vaknin/PCB/boards/capture-clip/case/case-exploded.png

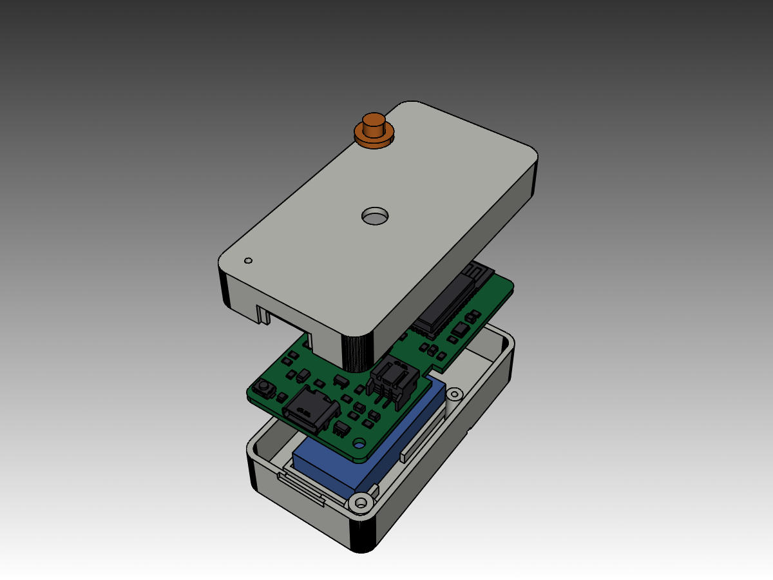
boards/capture-clip/case/case-exploded.png
