vaknin/PCB/boards/capture-clip/case/case-iso.png

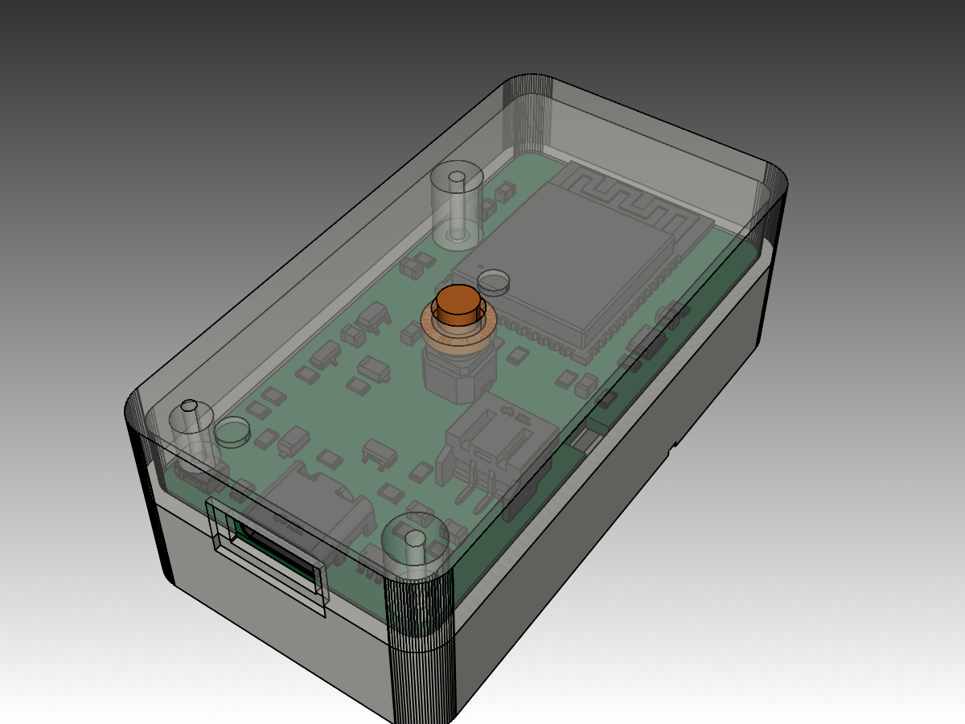
boards/capture-clip/case/case-iso.png
