vaknin/PCB/boards/capture-clip/fab/README.md

# Fab files: capture-clip

Generated by `cargo run --release -p capture-clip -- fab`; do not edit by hand.

- `capture-clip-gerbers.zip`: upload as the PCB (gerbers + drill).
- `capture-clip-bom.csv` and `capture-clip-cpl.csv`: upload for assembly (42 parts).
- Not assembled (no LCSC part, or test points/holes): H1, H2, TP1, TP2, TP3, TP4, TP5, TP6, TP7, TP8.

## Rotation corrections applied

- J1: KiCad 0 deg + 180 = 180 deg
- Q1: KiCad 0 deg + -90 = 270 deg
- U2: KiCad 90 deg + -90 = 0 deg
- U3: KiCad 90 deg + -90 = 0 deg
- U4: KiCad 0 deg + -90 = 270 deg

## Rotation UNVERIFIED (no known correction, or bottom side)

Check each of these in JLCPCB's placement preview (pin 1 marker) before paying.

- D1 (LED_0805_2012Metric)
- D2 (D_SOD-123F)
- D3 (D_SOD-123F)
- D4 (LED_LiteOn_LTST-C19HE1WT)
- J2 (JST_PH_S2B-PH-SM4-TB_1x02-1MP_P2.00mm_Horizontal)
- MK1 (InvenSense_ICS-43434-6_3.5x2.65mm)
- SW1 (SW_Push_1TS009xxxx-xxxx-xxxx_6x6x5mm)
- SW2 (SW_SPST_TS-1088-xR020)
- U1 (ESP32-S3-WROOM-1_EPAD-Drill0.3)
