vaknin/PCB/boards/starter/fab/README.md

# Fab files: starter

Generated by `cargo run --release -p starter -- fab`; do not edit by hand.

- `starter-gerbers.zip`: upload as the PCB (gerbers + drill).
- `starter-bom.csv` and `starter-cpl.csv`: upload for assembly (26 parts).
- Not assembled (no LCSC part, or test points/holes): H1, H2, H3, H4, TP1, TP2, TP3, TP4, TP5, TP6, TP7.

## Rotation corrections applied

- J1: KiCad 0 deg + 180 = 180 deg
- U2: KiCad 90 deg + 180 = 270 deg
- U3: KiCad 90 deg + -90 = 0 deg

## Rotation UNVERIFIED (no known correction, or bottom side)

Check each of these in JLCPCB's placement preview (pin 1 marker) before paying.

- D1 (LED_0805_2012Metric)
- D2 (LED_0805_2012Metric)
- D3 (D_SOD-123F)
- J2 (JST_SH_SM04B-SRSS-TB_1x04-1MP_P1.00mm_Horizontal)
- SW1 (SW_Push_1P1T_XKB_TS-1187A)
- SW2 (SW_Push_1P1T_XKB_TS-1187A)
- U1 (ESP32-S3-WROOM-1_EPAD-Drill0.3)
- U4 (Sensirion_DFN-4_1.5x1.5mm_P0.8mm_SHT4x_NoCentralPad)
