vaknin/PCB/research/2026-09-30-blind-review-capture-clip.md

# capture-clip revision A: blind design review (2026-09-30)

Reviewer: a separate agent that did not build the design and did not read `DECISIONS.md` or
`research/2026-09-30-power-path-fix.md` (only two datasheet URLs were taken from the latter by grep).

How this was checked:
- Every pad's net was read from `boards/capture-clip/kicad/capture-clip.kicad_pcb` (parsed with a script; pad positions turned into board coordinates) and compared with `src/circuit.rs` and the datasheets.
- Tracks, vias and the filled pours were read from the same file; path lengths are the shortest routed path between two pads.
- Coordinates are layout mm from the board's top-left corner, Y down (as in `src/layout.rs`).
- Datasheets read for this review: HE9073 (HEERMICR Ver 1.3, LCSC C723789 mirror), RB168MM-40 (ROHM Rev.002, C509936 mirror), adafruit.com/product/3898. Everything else rests on `research/2026-09-30-datasheet-check-capture-clip.md`.
- Reports read: `erc.json` (0 items), `drc.json` (16 warnings, all waived silk items; 0 unconnected; parity empty), `routing.json`, `gates.json`, `case/fit.json` (all checks pass), `fab/*`.

Cost-of-a-miss classes: **firmware** (fixable in code), **rework** (fixable by hand on the delivered board, or by reprinting the case or buying a different cell), **new board**.

## Findings

| # | Severity | Location | Finding and evidence | What a miss costs | Fix |
|---|---|---|---|---|---|
| 1 | **must** | J2 (24.9, 42.5), notch in the right edge (x 27.5–30, y 31–35), cell pocket x 6.5–23.5, y 18–54 (`board.toml` `[case.battery]`) | **The chosen cell's lead is too short to reach J2.** Adafruit #3898's lead is 25 mm (product page, read 2026-09-30; also parts research §10). J2's mouth faces the antenna end (`layout.rs` line 80), so the wires leave the plug at about (24.9, 30), turn back to the notch (~6 mm), drop past the board to the cell's mid-height (2.5 + 1.6 + 5.1 = ~9 mm), then run under the board to the cell's end at y 18 (15 mm to the nearest corner, ~20 mm to the middle of that end). Total ~30–35 mm against 25 mm. The lengths are **INFERRED** from the layout and case numbers; where on the cell's end the wires leave was not measured. `fit.json` has no check for the lead. | rework (splice longer wires onto a LiPo lead, or find a different protected cell with a longer lead and re-check its polarity) | Move J2 so its mouth is within ~15 mm of wire path from the cell's lead end (for example at the right edge near y 18–24, mouth toward the edge), or choose the cell first and place J2 for it. Add a lead-length check to the case stage. |
| 2 | **should** (fix before ordering; it is free now) | GND via at (4.6, 21.8), beside C7; pours `GND_F.Cu` (6 pieces), `GND_B.Cu` (3 pieces) | **The module's ground hangs on one via.** The pour pieces under and around U1, C5, C6, C8 and MK1 (front piece x 0.5–29.5, y 6–24; front piece around the mic; back piece y 6–32) connect to the ground of the regulator, battery connector, charger and USB only through the single 0.6/0.3 mm via at (4.6, 21.8) and a ~1 mm wide neck of front pour between tracks west of the module. Verified: removing that one via from the connectivity graph splits the GND net into two groups (pieces {module, mic} and {everything else}). No GND track bridges the two groups. DRC cannot see this (the net is connected). `routing.json` reports the piece counts but no gate acts on them. All 355 mA of Wi-Fi return current, the USB data return and the antenna's ground reference to the battery/USB side go through it. | Probably works; a single-via open kills the board (rework: a wire link). Marginal radio or USB behaviour would be hard to tell apart from other causes | Add stitching vias where the two back pieces meet the front pieces (several along x 1–5, y 22–30 and x 20–29, y 26–32), and keep a track-free ground corridor on the back layer from the module to U4/J2. Add a gate: every pour piece must be tied to the main piece by at least 2 vias. |
| 3 | **should** | U4 HE9073A33M5R (3.5, 32.5); `board.toml` lines 187–190, 197–200 | **The regulator drops too much for Wi-Fi bursts on a partly used cell.** HE9073 datasheet p.5: dropout 100 mV at 100 mA, 200 typ / 250 max mV at 200 mA; p.6 Fig. 5: ~0.45 V at 350 mA, ~0.77 V at 500 mA (typical). `board.toml`'s "500 mA typical at 0.5 V dropout" is the IOUT_MAX test condition, not the dropout. With Q1 (~30 mV) and the copper of finding 4 (~45 mV), the 3.3 V rail at a 355 mA peak is about cell − 0.55 V: below the module's 3.0 V minimum once the cell's terminal voltage is under ~3.55 V, which is reached with a good part of the charge left (**INFERRED**: roughly the last 15–30 % of a LiPo; the cell's own resistance makes it worse). The datasheet gives no load-transient conditions (p.7 Fig. 7 has none) and lists "Short / Start load current 90 mA" (fold-back, p.5). The earlier independent datasheet check covered the RT9080, not this part. Pinout 1 VIN, 2 GND, 3 CE, 4 NC, 5 VOUT was checked here against p.2 and matches the board. | firmware (stop uploads and warn at a higher cell voltage; less usable battery) or rework (swap U4 for a same-pinout SOT-23-5 part with lower dropout) | Decide now: either accept and set the low-battery threshold from a bench measurement, or pick a lower-dropout regulator with the same footprint and re-check its input rating and sleep current. Measure the rail during a transmit burst at a cell of 3.5–3.7 V at bring-up. |
| 4 | should | +BATT J2.1 → Q1.3 (32.7 mm, 5 of its nodes on the back), VSYS Q1.2 → U4.1 (13.4 mm), +3V3 U4.5 → U1.2 (26.2 mm, through vias); all 0.3 mm (`layout.rs` line 41) | **Power tracks are thin and long.** About 72 mm of 0.3 mm, 1 oz copper in series from the battery connector to the module: ~120 mΩ, ~45 mV at 355 mA, on top of finding 3. C5/C6 are close to the 3V3 pad (3.6 and 7.2 mm), which is good. | none by itself; adds to finding 3 | Power class 0.6–1.0 mm (or short pour shapes) for +BATT, VSYS, +3V3; put U4 nearer the module's pad 2 or Q1 nearer J2. |
| 5 | should | D3 SMF5.0A (7.6, 49.5), VBUS from J1.A4 (12.55, 52.26) | **The VBUS surge diode is at the end of the line, not the start.** Routed VBUS goes J1 → TP1 → D2.A at 17.2 mm and only then on to D3 at 30.4 mm (27 mm from J1.A9), although D3 sits 5 mm from the connector. D2, Q1's gate, R6 and the regulator's input see a fast edge before the clamp does (~25–30 nH of track in series with the diode, **INFERRED**). The 9 V rating of the HE9073 (p.4) and the clamp's 9.2 V leave little margin already. | rework is impractical; an ESD/surge failure would show as a dead regulator | Route J1 VBUS pins straight to D3.1 first (short, wide), then on to the rest; D3.2 to the pour with its own via. |
| 6 | should | J1 shell legs at (10.68, 53.17) and (19.32, 53.17), slots reach y 52.3–54.0; cell pocket ends at y 54 | **The cell's end lies under two soldered through-hole legs of the USB connector.** `layout.rs` says the cell is "clear of the USB-C shell legs (y > 53)", but the front legs start at y 52.3 and the cell reaches y 54, inside x 6.5–23.5. `fit.json` `battery.board` = 0.42 mm uses the EasyEDA 3D model, which has no solder fillets and was aligned by hand (HARDWARE_LESSONS). A solder tip against a swelling pouch cell is a safety matter. Whether the legs or fillets stick out below a 1.6 mm board is UNVERIFIED. | rework (tape or trim the legs; reprint the tray with the pocket moved) | Move the pocket ≥ 2.5 mm toward the antenna end or shorten it, and add the through-hole pads' positions to the battery check. |
| 7 | should | MK1 stock; BOM line C5656610 | **Only 1,271 ICS-43434 in JLCPCB stock** (`cost.json`), and the owner plans to order later (spec status). If it runs out, the fallback mic (T3902, PDM) has a different footprint: new layout. | new board if it goes out of stock after the freeze | Re-check stock at order time; consider pre-ordering the part into JLCPCB's parts library, or lay out for the better-stocked part now. |
| 8 | note | pins IO4 (CHRG_SENSE), IO5 (STDBY_N) | With USB absent both pins float (the charger is unpowered, D1 blocks). An internal pull-down on IO4 would read "charging" with USB present and not charging (3.3 V through 100k into ~45k = ~1 V). | firmware | Read both pins only while VBUS_SENSE is high; no pulls on IO4; disable their inputs before sleep. |
| 9 | note | unplugging USB with a low cell | VSYS falls onto Q1's body diode (cell − ~0.6 V) for a few ms until the gate (R6 × C1 = 10 ms) has dropped. At a cell of ~3.5 V the rail can dip to ~2.8 V (**INFERRED**). | firmware (brown-out handling; resume an interrupted upload) | Test unplugging during an upload at a low cell. |
| 10 | note | sleep budget, `board.toml` lines 251–279 | Not counted: insulation leakage of C2, C3, C4, C5 (10–22 µF X5R; datasheet-limit leakage can be ~0.5–2 µA each, typical far less: **INFERRED**), and the module's figure is typical only. The sum of 12.65 µA has room. Every other path was traced and draws nothing asleep: R8 only when pressed, R16/R17/R6/D1 only on USB, LEDs (VSYS − 3.3 V ≤ 0.9 V), mic off, R9, R19 (PROG at 0 V). | firmware/none | Measure on the first board through the battery lead. |
| 11 | note | cell (metal foil) under the board from y 18; antenna y 0–6; M2 screw at H1 (2.5, 16.7) | Metal 12 mm from the antenna, inside Espressif's suggested 15 mm. The keep-out under the antenna itself is clean on both layers (zone x −9..39, y −15..6; no copper found in it). | reduced range (INFERRED, small) | Range test at bring-up. |
| 12 | note | U2 (22.4, 56) next to the case boss at H2 (27, 56.5) | In fast charge the TP4057 runs up to its 120 °C limit about 1 mm from a resin screw boss, in a closed case beside the cell, with no temperature sensing of the cell. | rework (case material) / firmware (shorter or no fast charge) | Try fast charge with the case closed at bring-up before relying on it. |
| 13 | note | microphone path: PCB hole Ø0.5 × 1.6 mm, then a Ø1.5 chimney ~10.5 mm long through the tray; outlet on the back face (with a side groove) | A sound path ~12 mm long will resonate inside the 8 kHz band (quarter-wave estimate ~6–7 kHz, **INFERRED**), and the mic faces away from the speaker. The seal is printed resin against bare PCB with two screws on a diagonal. Speech for transcription should survive. | rework (case reprint) | Record a test sentence in the closed case before freezing the case. |
| 14 | note | J2 mount pads MP at (21.55, 39.6) and (28.25, 39.6) | Both pads carry one "unconnected" net name, so the router joined them with 15 mm of track and 2 vias. Harmless. | none | Tie them to GND or give them separate nets. |
| 15 | note | no fuse on VBUS; one spare pin (IO21 on TP8); no test pad on EN or the I2S lines | A short on VSYS is limited only by the USB source. Rework hooks are thin but usable: TP1–TP8, R18, R3/R19. | rework harder | Optional: a test pad on EN and on MIC_VDD. |
| 16 | note | `fab/README.md` "Rotation UNVERIFIED" list | D1, D2, D3, D4, J2, MK1, SW1, SW2, U1 rotations are unchecked against JLCPCB's preview. D2, D3, D4, MK1 and U1 are polarised. | new board if a polarised part is turned and not caught | Check every one in the placement preview before paying (already the README's instruction). |
| 17 | note | silk | SW1 prints a literal "REF**"; values and references overlap across the board (render). | cosmetic | Hide values on silk. |

## Checked and found correct
- Pad → net for every IC and polarised part on the board: U2 (1 CHRG, 2 GND, 3 BAT, 4 VBUS, 5 STDBY, 6 PROG), Q1 (G VBUS, S VSYS, D +BATT; body diode cell → VSYS), D2 (pad 1 cathode on VSYS), D3 (pad 1 cathode on VBUS), D1, D4 (pad 4 anode on VSYS), U3, U4, MK1, J1 (D+ on A6/B6 → pad 14, D− on A7/B7 → pad 13, CC1/CC2 each on its own 5.1k), J2 (pad 1 +BATT, the "+" silk at x 25.9 is at pad 1), U1 pads against the pin map in `board.toml`.
- Power path logic, reversed-cell tolerance, no back-feed into USB, running from USB with no cell.
- Strapping: IO0 has 10k up and the button, no capacitor; IO3, IO45, IO46 unconnected. Flashing: native USB, or hold SW1 and poke SW2.
- Gerbers, drill file and CPL share one origin (board's bottom-left); vias are tented; smallest hole 0.3 mm; one-sided assembly.
- Cost: `cost.json` $66.89 for the design, $96.48 alone in a parcel, under the spec's $150 guide; 8 Extended parts ($24.56).

## What I could not verify
- The battery: lead exit position, real lead length, polarity of a pack in hand, its internal resistance.
- Whether the USB connector's legs protrude below the board (no drawing dimension read).
- HE9073 load-transient behaviour and its fold-back under a Wi-Fi burst; dropout maximum at 355 mA (only 200 mA has a maximum).
- The module's real deep-sleep current with 8 MB PSRAM; capacitor leakage.
- JLCPCB's own DFM result and placement preview (needs an upload); current stock beyond `cost.json`.
- The TP4057's package dimensions (datasheet page mislabelled, per the earlier check) and RB168MM-40's land pattern against `D_SOD-123F` (both SOD-123FL by name; dimensions not compared).
- Acoustic response, radio range, thermal behaviour: bench only.
- The case beyond `fit.json` and the three renders; the STEP/STL solids were not opened.

## Verdict
**Not ready to order.** No wrong pinout, polarity or footprint was found, and the gates that exist do pass. But the specified battery cannot be plugged in as laid out (finding 1), and the ground pour, regulator dropout, power track widths and surge-diode routing (findings 2–5) are all cheap to fix in a layout round now and awkward or impossible on a delivered board. Fix 1–6, re-run the gates, then re-review the changed areas.
