vaknin/PCB/research/2026-09-30-red-team-capture-clip.md

# Red team: what breaks the capture clip in the owner's hands (2026-09-30)

Reviewer did not design this board and did not read `DECISIONS.md`. Read-only pass over
`boards/capture-clip` (spec, board.toml, circuit, layout, case fit and renders, fab files) and the
firmware (`boards/capture-clip/firmware/main`, `firmware/components/clip`). Nothing was built, run
or measured. Another agent was editing the button sampler in `main.c` and `sim/run.py`; nothing
below depends on that half-edited code.

How to read this:

- **INFERRED** = reasoned from the files or from memory of a datasheet, not measured and not
  re-read today. Everything about real-board behaviour is INFERRED: no board exists.
- "Cost after delivery": *Wi-Fi* = firmware update over Wi-Fi; *USB* = flash or re-provision from
  the laptop with the case closed; *owner fix* = something a non-solderer can do (file a part,
  add a sticker, reprint a case); *rework* = soldering, which the owner cannot do; *new board* =
  second order and shipment.
- `board.toml` and `PROGRESS.md` were being edited while this was written, so they are cited by
  section, not by line.
- Paths are relative to the repo root. `bc/` = `boards/capture-clip/`, `fw/` =
  `boards/capture-clip/firmware/main/`, `clip/` = `firmware/components/clip/`.
- The fab quote is for 2 assembled boards (`bc/fab/cost.json:4-7`). That spare covers a single
  assembly defect. It does not cover a design fault: both boards have it.

## The short version

1. The 3.3 V regulator was picked for its 9 V input rating and 0.3 µA sleep current. How it
   behaves when Wi-Fi switches on (a 0 to ~350 mA step) was never looked at, and there is only
   about 32 µF behind it. If the rail dips under 2.84 V the chip resets, and the firmware then
   retries at once, forever. This is the one finding that can make the core function (send a note
   on battery) fail on every board with no firmware cure better than "turn the radio down".
2. The case works against the device: the microphone hole is in the underside (blocked when the
   clip lies on a table), the button stands proud with no guard (pocket presses start 15-minute
   recordings), and the cap-to-switch gap is 0.2 mm, the same size as the print tolerance.
3. USB recovery is sound. Main button + reset pinhole gives the chip's built-in flashing mode,
   which no firmware can break, as long as no security eFuse is ever burned. So firmware faults
   are fixable; what matters is that the device does not drain or loop itself in the meantime.
4. Firmware has no loop breakers: a brown-out loop, a crash loop or a held button each keep the
   chip awake until the cell is flat.

---

## A. Hardware: change before the order

| # | What breaks | How likely, and why | Evidence | Cost after delivery | Cheapest prevention now |
|---|---|---|---|---|---|
| A1 | **Wi-Fi start resets the chip on battery (3.3 V rail dips).** The HE9073 is a 0.3 µA-quiescent regulator from a small vendor with a thin datasheet. Regulators this frugal usually answer a sudden load slowly. Behind it: C4 10 µF + C5 22 µF, and 0805 ceramics lose a third or more of that at 3.3 V. A 350 mA step for 20 µs on ~18 µF effective is a ~0.4 V dip: 3.3 → 2.9 V, against a 2.84 V brown-out setting. On a part-empty cell the rail already sits lower (0.46 V dropout at 355 mA), so the margin is gone. | **Medium (INFERRED), impact highest.** Nobody checked load-transient response: the regulator research covers input rating, quiescent current, dropout and current limit only, and itself calls the vendor "the main weakness of this pick". The dev-board tests ran on a different regulator, so they say nothing. The pattern (ESP32 + micro-power LDO = brown-out at radio start) is a well-known failure. | `bc/src/circuit.rs:239-256` (U4, C3, C4), `:268-269` (C5, C6); `research/2026-09-30-power-path-fix.md` §"HE9073A33M5R, from the datasheet" (no transient figure; "Vendor ... thin") ; `bc/firmware/sdkconfig.defaults:16` (brown-out level 4); `clip/include/clip.h:25-35` | Firmware over Wi-Fi/USB can only lower the transmit power (shorter range) and back off. A real cure is a capacitor soldered on: **rework → in practice a new board.** | Add bulk capacitance on +3V3 at the module now: pads for one or two large ceramics or a polymer/tantalum (100 µF or more in total), populated. Room exists beside C5/C6 on the left strip. Re-check the regulator's start-up into the larger capacitor (its short-circuit foldback is 90 mA). Also worth a second look: the RT9080 that was dropped has ~0.18 V dropout instead of 0.46 V, but a 6.5 V input limit. |
| A2 | **Microphone hole is in the underside of the case.** Lying on a table button-up (the normal place for a device used "around the house"), the hole faces the table and is closed off by it. Carried in a pocket it faces cloth. | **High** that recordings made with the clip lying down are muffled (INFERRED: a 1.5 mm hole flat against a surface). R4 asks for clear speech at arm's length. | `bc/board.toml` `[[case.opening]] ref = "MK1"` (`side = "bottom"`), `bc/case/fit.json` check `opening.MK1` ("tray side"), `bc/src/layout.rs:6-8`, `bc/case/case-top.png` (no opening on the top face) | Owner fix only if a new case is printed: a second shipment of the case, not the board. Firmware cannot help. | Case change only: the mic sits 2.7 mm from the right edge (`layout.rs:65`), so turn the sound channel to come out of the **side wall**, or at least add feet/ribs and a groove from the hole to the edge. No board change. |
| A3 | **Button cap can hold the button down for good.** Nominal gap cap-to-switch is 0.2 mm and the switch travels 0.25 mm. Print tolerance on resin is about ±0.2 mm, plus switch height and screw seating. A cap 0.2 mm long = button permanently pressed. | **Medium (INFERRED).** The case's own rule for moving parts is 0.5 mm (`moving_fit`), but this gap passes at the 0.2 mm static limit. Result of a stuck button: a 15-minute recording after every wake, the chip never sleeps (B-row F2), and any reset lands in flashing mode, so the device looks dead. | `bc/case/fit.json` checks `clearance.cap-SW1` (0.2, limit 0.2) and `cap_travel.SW1` ("gap 0.20 + travel 0.25"); `bc/case/board.json` `limits.moving_fit 0.5` | Owner fix (file the cap's stem) once someone works out that this is the cause. | Open the gap to ≥ 0.5 mm in the case generator; firmware stuck-button handling (F2) as the backstop. |
| A4 | **Button stands 0.55 mm proud of the lid with no guard: pocket and bag presses.** One bump starts a recording that runs up to 15 minutes; the next bump stops it and starts a send. The light cannot be seen in a pocket. | **High** for a device the spec says is "sometimes carried in a pocket or bag". Each false press: a private conversation sent to Gemini and committed as a junk note, a note number used up, ~3.6 MB of the 9.75 MB store, and about a tenth of the battery. Three of them offline fill the store. | `bc/case/fit.json` `cap_travel.SW1` ("stands 0.55 mm above the lid"); `bc/spec.md:13`; `clip/include/clip.h:119`; `clip/clip_sm.c:183-200`; `bc/firmware/partitions.csv:11` | Firmware over Wi-Fi can soften it (F3). The guard itself needs a new case print. | Case: sink the cap flush or below a raised rim. No board change. |
| A5 | **USB connector legs point at the battery.** The front pair of shell legs comes through the board at y 52.6–53.7 mm, x 10.7 and 19.3; the cell lies under the board at y 18–54, x 6.5–23.5, with 1.2 mm between cell and board, 0.78 mm of which is reserved for swelling. Soldered pin ends over the end of a soft pouch. | **Low–medium (INFERRED)**, but the consequence is a punctured lithium cell. `layout.rs` says the cell is "clear of the USB-C shell legs (y > 53)" while placing it to y 54: the two numbers overlap. Whether the fit check counts the legs below the board is not visible in `fit.json` (nearest part to the battery is reported as "PCB"). | `bc/src/layout.rs:17-20`; `bc/fab/gerbers/capture-clip.drl` (T4 slots X10.68 Y7.38–6.28 and mirror); `bc/board.toml` `[case.battery]`; `fit.json` `battery.board` | Owner fix: a strip of Kapton or fish paper over the legs, if told to. | Move the cell pocket 2–3 mm toward the antenna end (y 15.5–51.5 still clears the antenna, which ends at y 6), or put a printed shelf between legs and cell. |
| A6 | **Light too dim to read.** Each colour runs through 1 kΩ from VSYS. On a cell at the upload limit (3.65 V) blue and green get about 0.3–0.7 mA; a high-forward-voltage part is dark. Blue = "sending", green = "saved": the two things the owner most wants to see. Seen through a hole in a lid 7 mm above the LED. | **Medium (INFERRED from the designer's own datasheet check)**: "A high-Vf green/blue part may be dark on a nearly flat cell." Firmware can dim a bright LED with PWM; it can never brighten a dim one. | `bc/src/circuit.rs:342-359`; `research/2026-09-30-datasheet-check-capture-clip.md:66` | Rework (three resistors) → new board. | R11 and R12 (green, blue) to about 330 Ω, R10 (red) to about 470 Ω; trim in firmware. All Basic values, no cost. |

## B. Hardware hooks worth adding now (cheap insurance, not proven faults)

| # | What it buys | Why | Evidence | Cost if skipped | Hook |
|---|---|---|---|---|---|
| B1 | **The main button off the flashing-mode pin.** The main button is on IO0. The chip reads IO0 at power-on, brown-out and watchdog resets (INFERRED from the ESP32-S3 datasheet's strapping section, from memory); low = ROM flashing mode, where it sits with the light off until the cell is flat. | A brown-out while the button is down (a squeeze in a pocket on a low cell, or A3's stuck cap) parks the device in flashing mode. No firmware runs there, so no firmware can fix it. A deep-sleep wake is safe (HARDWARE_LESSONS:149). | `bc/src/circuit.rs:278-292`; `bc/board.toml:19` (BUTTON pin note) | Owner must know the cure: reset pinhole with the button released. Battery is drained each time. | Main button on the spare RTC pin IO21 (today only a test pad, which is useless to someone who cannot solder), and a second small Basic switch on IO0 behind its own pinhole next to reset. Recovery stays as good; a stuck main button can no longer stop the boot. |
| B2 | **Battery protection that does not depend on which cell is bought.** The board has no protection chip and no under-voltage cut-off; the regulator is always on. It relies on the cell's own protection board. | The owner buys the cell separately, in Israel, where the named Adafruit cell is awkward to get. A bare cell, or one with a 2.4 V cut-off, is deep-discharged by any of the drain loops in section C. | `bc/src/circuit.rs:209-215`; `bc/board.toml:203-205` ("its datasheet was not read") | Swollen or dead cell; new cell. | A DW01A + dual-FET protection stage on the board (standard parts), or at least state in the owner guide: only a *protected* cell, this size, this polarity. |
| B3 | **A battery reading good to better than ±0.1 V.** The divider is 667 kΩ seen from the pin; the pin's leakage (up to 50 nA) shifts the reading by up to 0.1 V at the cell. The firmware's limits are 50–100 mV apart. | A board that reads 0.1 V low refuses to send with a fifth of the charge still in the cell; one that reads high walks into brown-out. | `bc/src/circuit.rs:231-237`; datasheet check `:74`; `clip/include/clip.h:33-38` | Firmware (per-board calibration over USB: with no cell fitted the charger holds 4.2 V on the pin). | Three 330 kΩ instead of three 1 MΩ: 4 µA instead of 1.4 µA asleep, inside the 20 µA budget (sum today ~12.7 µA). Or keep and calibrate at bring-up. |
| B4 | **Fast charge is 0.83 C into a 400 mAh cell with no temperature sense**, in a closed case, next to a charger chip that runs at up to 120 °C while throttling. | Cell life and swelling over a year of nightly charges; charging below 0 °C or in a hot car is unprotected in any mode (TP4057 has no thermistor pin). Spec says indoors. | `bc/src/circuit.rs:147-159`; `bc/src/layout.rs:21-22`; `clip/clip_sm.c:288-293` | Wi-Fi: firmware can drop to 100 mA always, or use the chip's internal temperature sensor as a rough guard. | None needed on the board if fast charge is made opt-in in firmware. Tell the owner. |
| B5 | **Microphone seal.** The chimney's top meets the board with 0.0 mm nominal gap, rigid resin on fibreglass, at a corner far from both screws. Print tolerance gives either a leak (the mic hears the inside of the case and button clicks) or a bowed board. The 10.5 mm × Ø1.5 mm tube also resonates around 5–7 kHz, inside the recorded band (INFERRED). | Medium for "sounds boxy", low for "unusable": speech-to-text is tolerant. Open hole, no mesh: lint and sweat go straight to the mic port. | `fit.json` `seal.MK1` (0.0), `opening.MK1`, `print.tube_wall`; `bc/board.toml` `[[case.opening]] ref = "MK1"` | Owner fix (foam ring, mesh sticker) or new case. | Make the chimney 0.5 mm short and fit a soft gasket; a side port (A2) shortens the tube as well. |
| B6 | **M2 self-tapping screws into resin bosses**, 1.5 mm boss wall, two screws only. Resin is brittle: bosses crack on the second or third opening, and the case will be opened (battery, reset of a looping device). A drop lands on a 1.5 mm resin wall. | Medium over the device's life (INFERRED). Material is the owner's choice and resin is only the starting value. | `fit.json:5`, checks `print.boss_wall`, `screw_length` | New case print. | Offer nylon (MJF/SLS) on the choice page with this reason; or brass inserts. |

## C. Firmware: fix before shipping

All of these are fixable later over Wi-Fi or USB. They are listed because, until fixed, they
drain the cell, lose notes or leave the device looking dead.

| # | What breaks | How likely, and why | Evidence | Cost after delivery | Prevention now |
|---|---|---|---|---|---|
| F1 | **Brown-out reset loop.** After a brown-out the app starts "fresh": it clears the retry times, reads the cell at rest (it has recovered), sees a queued note and starts Wi-Fi at once. If Wi-Fi start is what caused the reset (A1, a cold or aged cell), it loops every second or two until the resting voltage falls under 3.65 V. The loaded-voltage check reads an average, not the transmit peak, so it does not catch this. | High *if* A1 is real; otherwise occasional on old or cold cells. | `fw/main.c:514-528` (fresh start wipes `keep`), `:645-647` (brown-out is only used to skip the self-test); `clip/clip_sm.c:76-91`; `fw/main.c:191-199`; `fw/hw_gpio.c:109-126` | Wi-Fi/USB | Count resets in memory that survives a reset (`RTC_NOINIT`); after a brown-out treat the battery as low for that wake and back off; cap transmit power until bring-up has measured the rail. |
| F2 | **A held or stuck button keeps the chip awake until the cell is flat.** With the button down the state machine refuses to sleep ("a sleep would end at once"). At roughly 30–50 mA idle that is about 10 hours for 400 mAh (INFERRED current). No timeout. | Medium: pocket pressure, a bag, A3's stuck cap. | `clip/clip_sm.c:104-108`; `fw/sleep_deep.c:30-40` | Wi-Fi/USB | After a recording ends with the button still down, sleep with the button wake turned off and a short timer wake to look again (or wake on release). |
| F3 | **Nothing stops a recording nobody meant.** No silence check, fixed 15-minute cap, and the junk is sent. | High with A4. Also a privacy matter: other people's speech goes to Google and into the repo. | `clip/clip_sm.c:217-220`; `clip/include/clip.h:119` | Wi-Fi/USB | Stop after ~20–30 s without speech energy; drop a new note Gemini hears nothing in (additions already do this). |
| F4 | **Crash loop with no safe mode.** A file in the queue that crashes the parser or the uploader crashes it again on every wake. Rollback does not help: the image was already accepted. The console barely comes up before the crash. | Low per release, but this is the case the "free to fix" promise rests on. | `fw/main.c:625-670` (no reset counter); `bc/firmware/sdkconfig.defaults:11` | USB with the case closed: button + reset pinhole, reflash, erase storage (queued notes are lost). Not Wi-Fi. | After three crashes in a row, start a minimal mode: console and update check only, queue untouched. |
| F5 | **Updates are not authenticated.** The image is checked only against a SHA-256 that comes from the same manifest. Whoever can write the manifest (or sit in the path: `http://` is accepted for both the manifest and the image) installs anything. Any *different* version string installs, including an older one. No secure boot. A malicious image gets the Wi-Fi password, both keys and a microphone in the house. | Low likelihood, severe. If the manifest lives in the notes repo, every holder of the notes token (phone, laptop, this clip's own flash) can push firmware. | `fw/update.c:49-69`, `:89-150` (SHA compare at `:138`); `clip/clip_update.c:53` (`http://` allowed), `:92-105` (`strcmp` only); `bc/firmware/PROGRESS.md` "INFERRED items" (update manifest format and hosting) | Wi-Fi/USB | Sign the manifest (Ed25519, public key in the firmware), refuse `http://`, refuse downgrades. Keeps USB recovery, burns no eFuse. |
| F6 | **Wi-Fi updates are inert as provisioned, and only checked at one moment.** `update_url` is not in `board.toml [provision]`, so a provisioned clip has none and never updates. With it, the check runs only on USB with Wi-Fi already up for a queued note. A firmware whose recorder is broken queues nothing and therefore never looks for its own fix. | Certain (first part) as the files stand. | `bc/board.toml` `[provision]` (no `update_url`); `bc/firmware/PROGRESS.md` "Needed from pcbgen and board.toml"; `clip/clip_sm.c:96-102`; `fw/update.c:89-96` | USB | Add the key; on USB plug-in, check for an update once a day whether or not a note is queued. |
| F7 | **A good update is thrown away, and that version is then refused for ever**, if the network is down for three tries during its trial, or the cable is pulled and the chip resets before the trial ends. | Medium: a router reboot is enough. The designer lists the first half as known bug 6. | `fw/update.c:164-203`; `clip/clip_update.c:100-102`; `bc/firmware/PROGRESS.md` "Known bugs" item 6 | Publish a new version number. | Judge the trial on local checks; treat "no network" as "try again at the next boot", not as failure. |
| F8 | **The trial's storage check cannot fail, and a mount failure erases the queue silently.** Storage is mounted with format-on-failure, so an update with an incompatible file-system setting wipes every unsent note and then passes its own "storage mounts" check. | Low, but the loss is silent and total. | `fw/store.c:144-155`; `fw/update.c:176-179` | Notes lost; no recovery. | Format only when a "never formatted" flag says first boot; otherwise fail the trial and report. |
| F9 | **Storage fills and stays full.** Given-up recordings are kept and never retried or deleted without a console command; while GitHub refuses (expired token), everything stays queued. About 40 minutes of audio fits. Then every press is a red blink. | Certain on 2027-09-18, when the GitHub token expires, unless it is renewed first; the status file uses the same token, so the phone sees nothing either. | `bc/firmware/PROGRESS.md` "Not started" (storage-full policy); `clip/clip_queue.c:664-669`; `fw/recorder.c:141`, `:190`; `bc/board.toml` `[provision] github_token` (`expires = "2027-09-18"`); `clip/clip_upload.c:14` | USB re-provisioning; nothing lost if done before the store fills. | A distinct light pattern for "needs the laptop"; a reminder before the expiry date; a policy for given-up audio. |
| F10 | **First half-second of every note is lost, and a hold must be ~1.2 s.** Wake-to-app was measured at 325–365 ms because the bootloader re-checks the whole image on every wake; the firmware assumes 150 ms. `update.c` says the skip option "must stay off", but that option only affects deep-sleep wakes and the update uses a restart, so they do not conflict. File-system mount and microphone start come on top. | Certain. | `firmware/spikes/codec/RESULTS-devboard.md:133-149`; `fw/main.c:35-38`; `fw/update.c:156-157`; `bc/firmware/sdkconfig.defaults` (option absent) | Wi-Fi/USB | Turn on skip-validate on wake and the quiet boot settings; measure; set `WAKE_BOOT_MS` from the measurement. Check that the quiet-ROM option burns no eFuse (the results file flags this). |
| F11 | **Gemini model and endpoint are compiled in** (`gemini-3.5-flash-lite`, a `v1beta` path). When Google retires either, every note fails eight times and is set aside. | Certain eventually (INFERRED: hosted models are retired on a schedule). | `firmware/components/capture/include/capture.h:114-121` | Wi-Fi, if F6 is fixed; otherwise USB. | Make the model a provisioned value with the compiled one as default. |
| F12 | **No upload where the network blocks time servers.** With the clock never set (first use, or after the cell ran flat), a failed time sync counts as "offline". Guest and office networks often block it. | Low at home, certain on such networks. | `fw/net_wifi.c:97-105` | Wi-Fi/USB | Fall back to the `Date` header of the first HTTPS answer. |
| F13 | **Notes postponed by the wall clock can wait indefinitely after the cell runs flat** (INFERRED from reading, not run): the queue compares `not_before_ms` with a wall clock that reads 0 until Wi-Fi sets it, and Wi-Fi is not started because nothing is due. A new recording unblocks it. | Low. | `fw/main.c:112-117`, `:136-141`; `clip/clip_queue.c:615-650` | Wi-Fi/USB | With the clock unset, treat postponed notes as due. |
| F14 | **Secrets are in plain flash.** Wi-Fi password, Gemini key, GitHub token and any unsent recordings can be read from a lost clip with a USB cable. NVS encryption is "not started"; it would not stop someone who flashes their own reader anyway. | Low (needs the device), but see section D: the cure is worse than the disease for recovery. | `bc/firmware/PROGRESS.md` "Not started" (NVS encryption); `fw/http.c:42-77` | — | See D3. Do **not** turn on flash encryption or secure boot casually: they burn eFuses and can end USB recovery. |
| F15 | **Audio gaps when flash is slow.** One second of audio is synced to LittleFS per page; the I2S buffer holds 320 ms. A slow erase or an allocator scan on a nearly full 9.75 MB store is longer than that (INFERRED; the designer lists it as not provable before hardware). | Medium when the store is nearly full. | `fw/mic_i2s.c:22-23`; `fw/recorder.c:46-54`, `:126-144` | Wi-Fi/USB | A larger ring buffer in internal RAM between mic and encoder; measure at bring-up. |
| F16 | **The microphone self-test cannot see a blocked or missing sound path.** It passes on the mic's own noise (4 counts of spread). A board with flux in the hole, or a case with the chimney off-centre, passes. | Medium that a real acoustic fault slips through bring-up. | `fw/selftests.c:15-47` | — | Self-test step: "clap once", require a clear rise over the noise floor, with the case closed. |
| F17 | **None of the real hardware paths has ever run**: GPIO, ADC, I2S mic, deep sleep and both wake pins, Wi-Fi, TLS, the certificate bundle. | Certain that something in there is wrong on first power-up; that is what bring-up is for. It matters here because the freeze comes before any board exists. | `bc/firmware/PROGRESS.md` "Written but untested" and "Proven where: Not before hardware" | USB | Run the app on the ESP32-S3 dev board with a breakout mic and a button before the order: it removes most of this list for the price of one small part. |

## D. Accept, and tell the owner

| # | What | Why accept | Evidence | What the owner needs to know |
|---|---|---|---|---|
| D1 | **Button held while a flat or missing battery is plugged into USB = flashing mode**, light off, looks dead. | Inherent in using one button for both (spec line 27), unless B1 is taken. | `bc/spec.md:27`; `bc/board.toml:19` | "If it seems dead: poke the reset hole once, without touching the button." The charge light works on its own and still shows USB power. |
| D2 | **The battery must be the right one.** The pocket fits 36 × 17 × 7.8 mm with 0.4 mm to spare; the plug's polarity is not standardised across sellers. A reversed cell does no damage by analysis (INFERRED) but the clip will not run. | Cannot be designed away short of B2. | `fit.json` `battery.case`; `bc/src/layout.rs:124-127`; datasheet check `:58` | Exact cell to buy, a photo of which wire goes to "+", and: never force the lid shut on the lead. About 5 cm of lead has to be folded above the board beside the button (INFERRED: the fit check does not model wires); keep it off the antenna end. |
| D3 | **A lost clip gives away the Wi-Fi password, the Gemini key and the notes token.** | Real protection costs the USB safety net. | F14 | Use a GitHub token limited to the notes repo only; know where to revoke it and the Gemini key; change the Wi-Fi password if the clip is lost. |
| D4 | **About a fifth of the battery cannot be used for sending.** Below 3.65 V at rest the clip records but does not send, because of the regulator's dropout. By the firmware's own curve that is ~18 % of the charge. | Follows from the regulator choice. | `clip/include/clip.h:33-37`; `clip/clip_power.c:42` | Amber light = "charge me to send". Battery life in weeks is still unmeasured (spec line 18). |
| D5 | **Weeks offline with a note queued drains the cell slowly**: a 15-second connect attempt every hour, roughly 10 mAh a day (INFERRED). | Cheap to soften later in firmware (longer back-off). | `clip/clip_sm.c:47-54`; `fw/net_wifi.c:19`, `:90` | On a trip, expect about a month, not months. |
| D6 | **Plugged in all the time**, the cell is held full and topped up, which ages it; the clip stays awake on USB. | Normal for this charger. 0.78 mm of swelling room is designed in. | `clip/clip_sm.c:104-107`; `fit.json` `battery.board` | Look at the cell once or twice a year; a case that no longer closes flat means replace the cell. |
| D7 | **Antenna**: the keep-out is respected and the cell ends 12 mm from it; a steel M2 screw sits 10 mm from it and the hand covers that end. Range is unmeasured. | Pre-certified module used as intended. | `bc/src/layout.rs:4`, `:57`; `bc/kicad/render-top.png` | If notes queue in rooms where the phone has Wi-Fi, that is range, not a fault. |
| D8 | **No clip.** The case is a plain 34 × 64 × ~20 mm box with no clip, loop or lanyard hole. | A case matter, the owner's choice. | `bc/case/case-iso.png`, `case-top.png`; `fit.json` parts list | Decide on the case choice page. |
| D9 | **Open holes** for the light, reset and microphone: not splash-proof. Spec says indoors, dry. | As specified. | `bc/spec.md:13`; `bc/board.toml` `[[case.opening]]` entries | Not for the bathroom or a sweaty pocket. |
| D10 | **Clock drift while asleep** uses the chip's internal oscillator: a note recorded after days offline can be stamped minutes off. | No crystal on the board; corrected at each connect. | `fw/net_wifi.c:100-101` | — |

## E. Fab and assembly chain

| # | What breaks | How likely | Evidence | Cost | Prevention |
|---|---|---|---|---|---|
| E1 | **Wrong rotation in the placement file.** Rotation is unverified for D2 and D3 (diodes), D4 (RGB), MK1 (mic), U1 (module), J2, D1. A reversed D3 shorts USB power; a reversed D2 means USB cannot run the board; a turned mic or module is a dead board. | Medium per part; this is the usual way a first assembled order dies. Both assembled boards would share it. | `bc/fab/README.md` ("Rotation UNVERIFIED") | New board (owner cannot solder). | Check every listed part against pin 1 in JLCPCB's placement preview before paying, and save a screenshot with the order. Ask JLCPCB to confirm polarity ("DFM/placement review") in the order note. |
| E2 | **Microphone out of stock.** 1,281 in stock on 2026-09-30, the thinnest on the board, and nothing else fits its footprint. A fab-side substitute would be wrong. | Medium if the order waits for other designs, as the spec says it will. | datasheet check `:115`; `bc/spec.md:4` | Order delayed, or a redesign. | Pre-purchase the mic (and the module) into JLCPCB's parts library at freeze; re-read stock on order day; forbid substitutions in the order. |
| E3 | **Regulator pin numbers are INFERRED** (the datasheet figure has no numbers) and the part is drawn with another maker's symbol. The standard numbering is very likely right. | Low. | `bc/src/circuit.rs:240-243` | New board. | Compare against JLCPCB's own footprint/3D preview for C723789 at order time. |
| E4 | **Bottom-port mic soldered by the fab**: paste or flux in the 0.5 mm hole. The hole is present in the drill file and unplated. | Low. | `bc/fab/gerbers/capture-clip.drl` (T5 0.5 mm at X27.3 Y39.69) | New board, or the spare. | F16's clap test on both boards at bring-up. |

## What was checked and found sound

- **USB recovery with the case closed.** Main button on IO0 plus reset behind a pinhole, native
  USB on the fixed pins, no eFuse burned: the ROM flashing mode is reachable whatever the firmware
  does (`bc/src/circuit.rs:278-301`, `fit.json` `opening.SW2`). It stays true only while no
  security eFuse is burned.
- **Bad update.** Two slots, trial boot, rollback on crash or failed check
  (`bc/firmware/sdkconfig.defaults:11`, `fw/update.c`). The old firmware always survives.
- **Power path.** USB present: cell isolated and charging; USB absent: cell feeds the board; a
  reversed cell is blocked by analysis (`bc/src/circuit.rs:181-205`).
- **Dead cell on USB.** The board runs from USB through D2 while the charger trickle-charges.
- **Fast charge never overlaps Wi-Fi** in the state machine, the worker and `net_up`
  (`clip/clip_sm.c:288-293`, `fw/main.c:286-294`, `fw/net_wifi.c:69`), and the pin is hi-Z at
  reset and asleep.
- **Power cut while recording.** Page-by-page sync, recovery at boot (`fw/recorder.c:46-54`).
- **Antenna keep-out** is in the footprint and empty in the render.
- **Provisioning console** lists key names and lengths only, never values
  (`firmware/components/provision/provision_cmd.c:28`).

## Not checked

- No datasheet was re-read today; the HE9073's transient behaviour (A1) and the strapping-pin
  reset list (B1) are from memory and must be confirmed.
- `clip_queue.c` and `clip_upload.c` were skimmed, not audited line by line.
- The case geometry was judged from `fit.json`, `board.json` and three renders, not from the
  STEP files.
- Nothing was measured: currents, range, audio and timing are all INFERRED.
