vaknin/PCB/boards/capture-clip/case/case-top.png

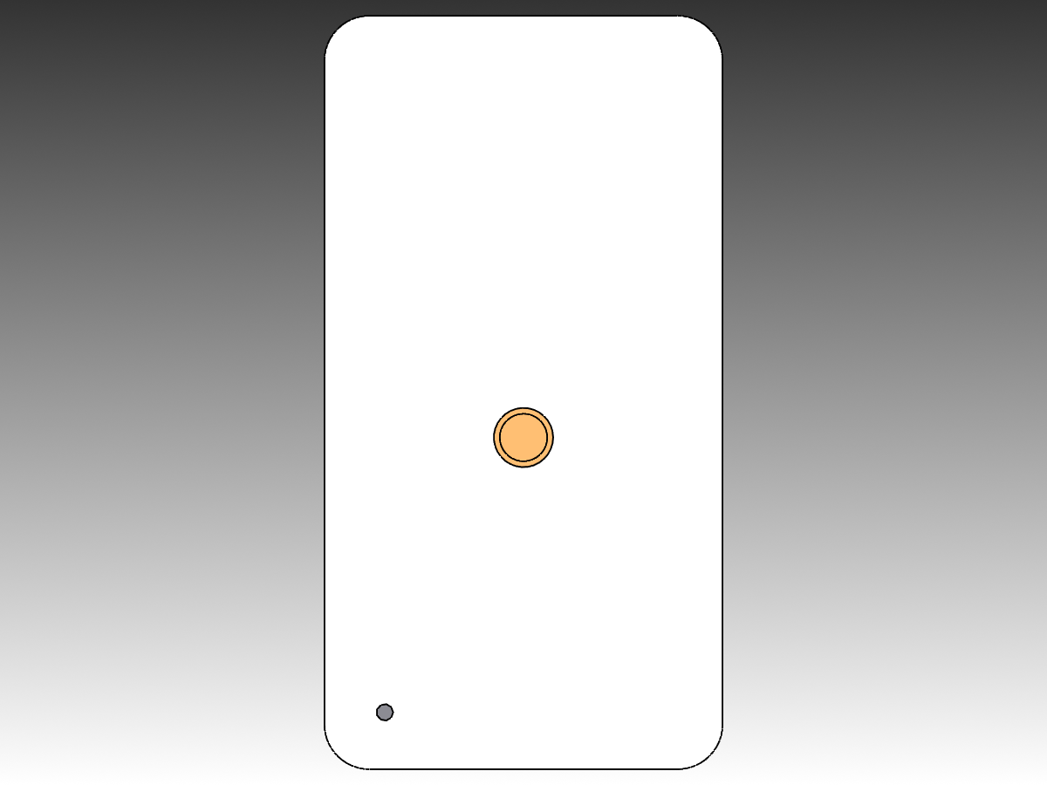
boards/capture-clip/case/case-top.png
