vaknin/PCB/boards/capture-clip/kicad/render-top.png

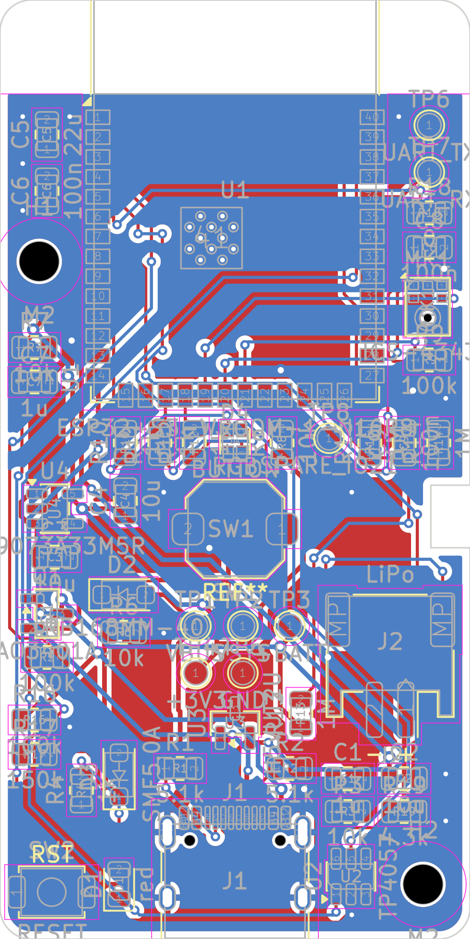
boards/capture-clip/kicad/render-top.png
