vaknin/PCB/boards/starter/kicad/render-top.png

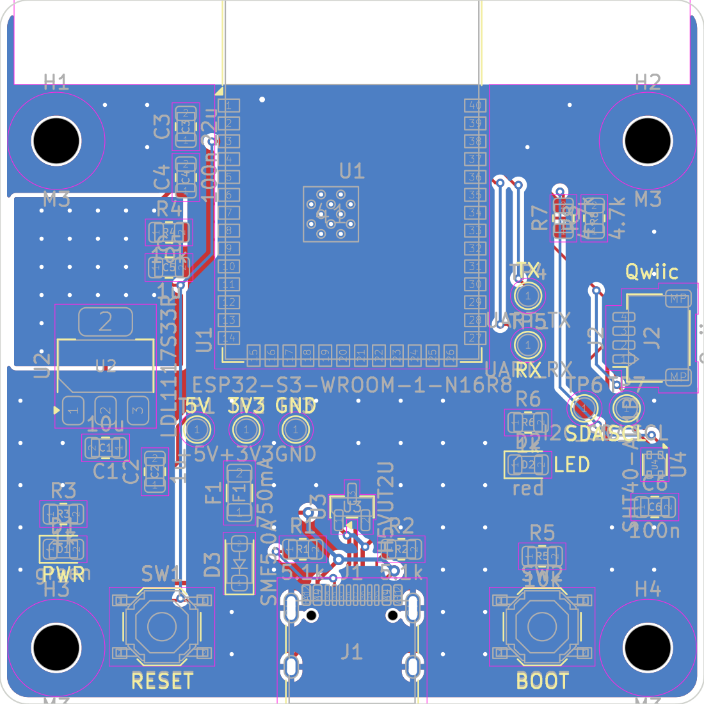
boards/starter/kicad/render-top.png
