vaknin/PCB/boards/starter/fab/starter-bom.csv

Comment | Designator | Footprint | LCSC
10u | C1 | C_0805_2012Metric | C15850
1u | C2,C5 | C_0805_2012Metric | C28323
22u | C3 | C_0805_2012Metric | C45783
100n | C4,C6 | C_0805_2012Metric | C49678
green | D1 | LED_0805_2012Metric | C2297
red | D2 | LED_0805_2012Metric | C84256
SMF5.0A | D3 | D_SOD-123F | C19077497
750mA | F1 | Fuse_1206_3216Metric | C89653
USB-C | J1 | USB_C_Receptacle_HRO_TYPE-C-31-M-12 | C165948
Qwiic | J2 | JST_SH_SM04B-SRSS-TB_1x04-1MP_P1.00mm_Horizontal | C160404
5.1k | R1,R2 | R_0805_2012Metric | C27834
1k | R3,R6 | R_0805_2012Metric | C17513
10k | R4,R5 | R_0805_2012Metric | C17414
4.7k | R7,R8 | R_0805_2012Metric | C17673
RESET | SW1 | SW_Push_1P1T_XKB_TS-1187A | C318884
BOOT | SW2 | SW_Push_1P1T_XKB_TS-1187A | C318884
ESP32-S3-WROOM-1-N16R8 | U1 | ESP32-S3-WROOM-1_EPAD-Drill0.3 | C2913202
LDL1117S33R | U2 | SOT-223-3_TabPin2 | C435835
H5VUT2U | U3 | SOT-23 | C20615824
SHT40-AD1B | U4 | Sensirion_DFN-4_1.5x1.5mm_P0.8mm_SHT4x_NoCentralPad | C2909890
