vaknin/PCB/boards/capture-clip/case/case-lid.step

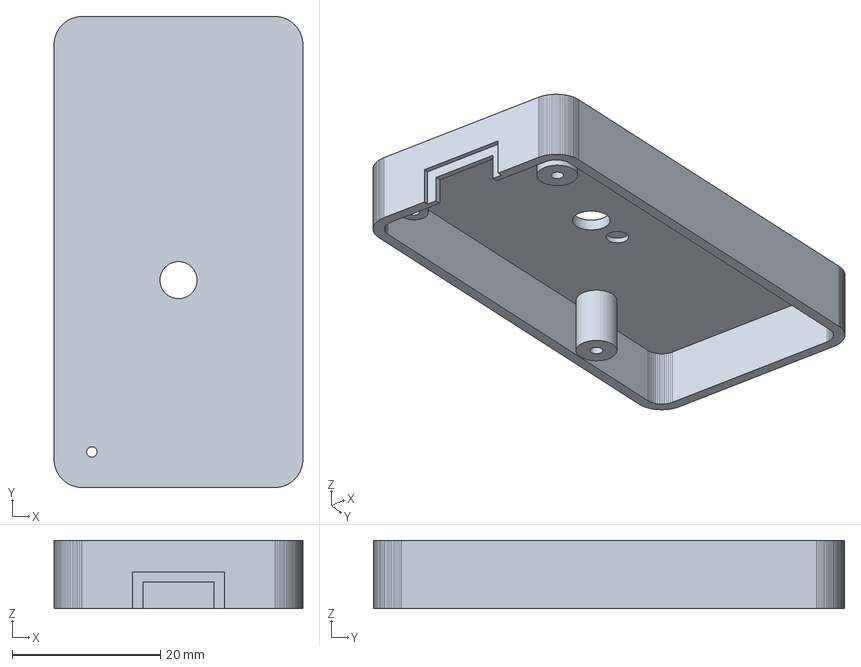
[picture p6: CAD file, 2026-09-30]
boards/capture-clip/case/case-lid.step
33.6 x 63.6 x 9.20 mm
