vaknin/PCB/boards/capture-clip/case/cap-SW1.step

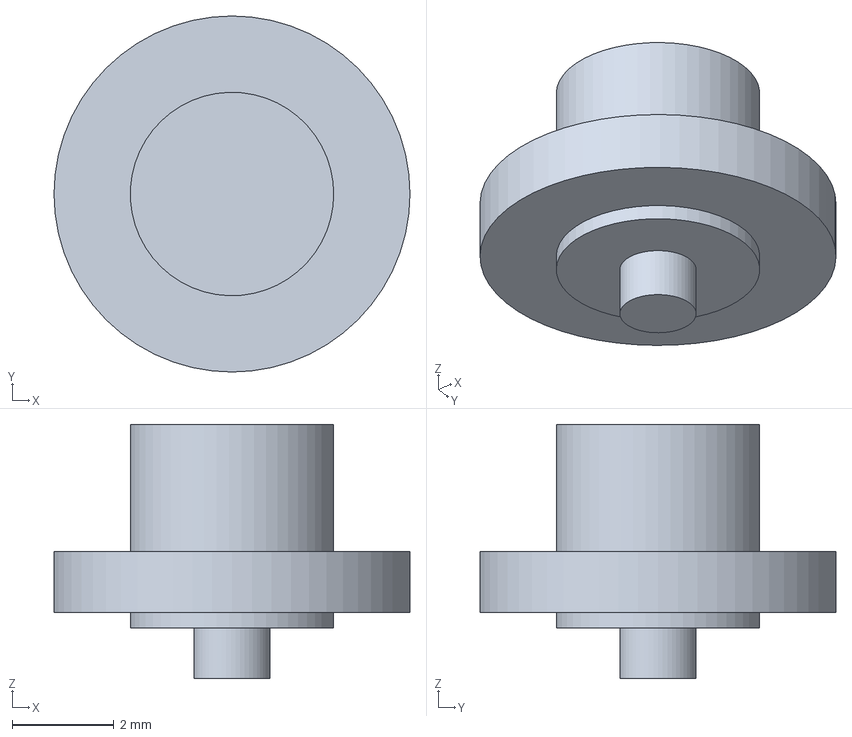
[picture p7: CAD file, 2026-09-30]
boards/capture-clip/case/cap-SW1.step
7.00 x 7.00 x 5.00 mm
