vaknin/PCB/boards/capture-clip/case/case-bottom.step

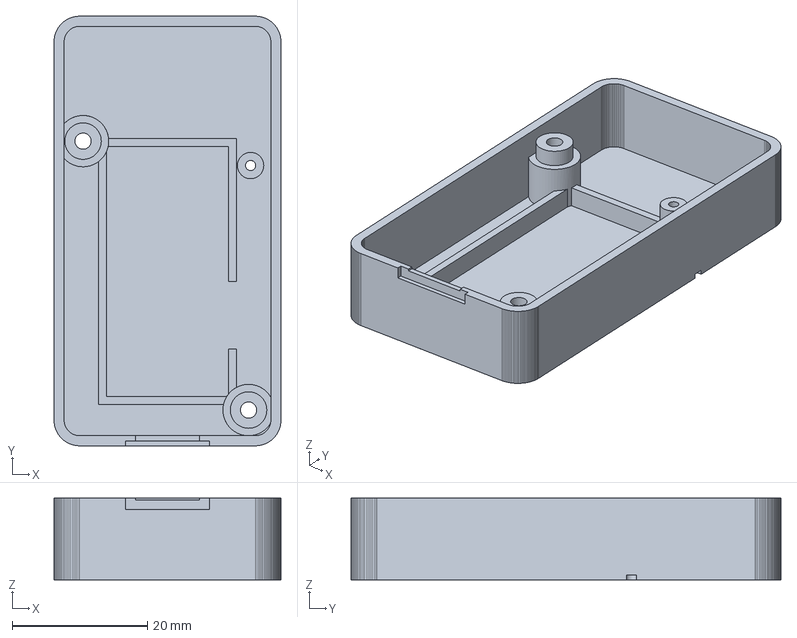
[picture p8: CAD file, 2026-09-30]
boards/capture-clip/case/case-bottom.step
33.6 x 63.6 x 12.1 mm
