vaknin/PCB/boards/starter/case/cap-SW2.step

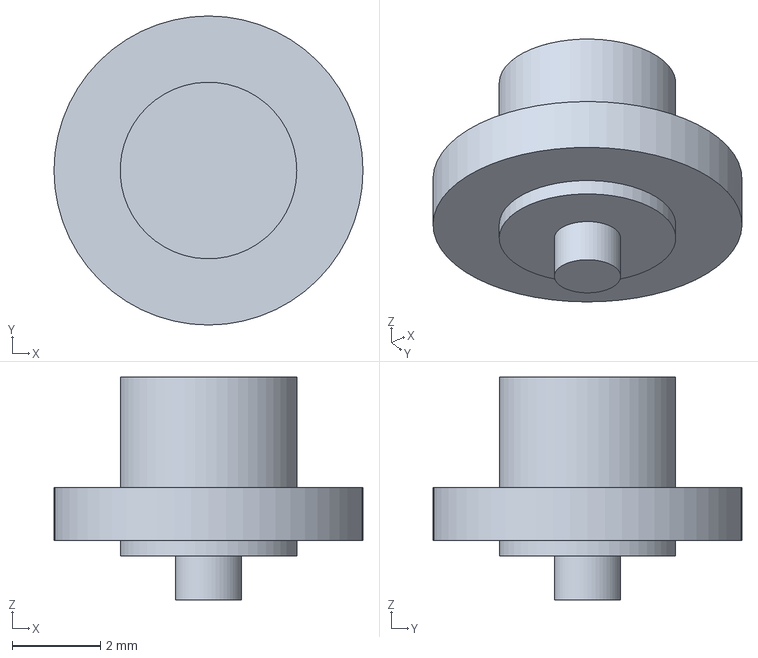
[picture p9: CAD file, 2026-09-30]
boards/starter/case/cap-SW2.step
7.00 x 7.00 x 5.05 mm
