vaknin/PCB/boards/starter/case/case-bottom.step

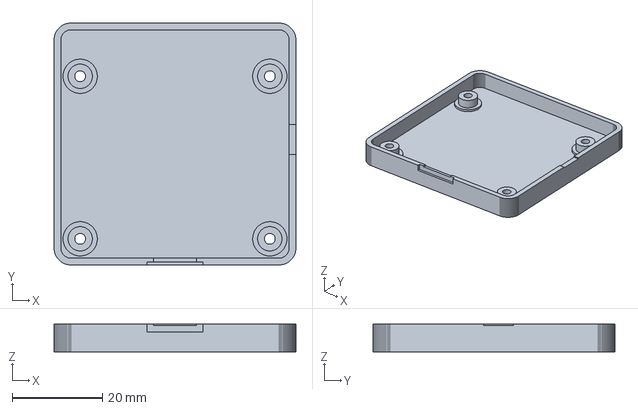
[picture p10: CAD file, 2026-09-30, an earlier design]
boards/starter/case/case-bottom.step
53.6 x 53.6 x 6.10 mm
