vaknin/PCB/boards/starter/case/case-lid.step

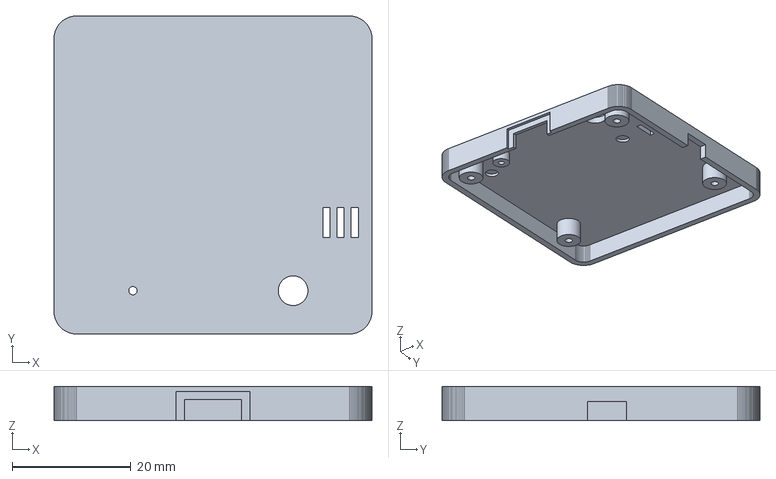
[picture p11: CAD file, 2026-09-30, an earlier design]
boards/starter/case/case-lid.step
53.6 x 53.6 x 5.75 mm
