vaknin/PCB/(list of files, cad)

Other CAD files:
boards/capture-clip/case/cap-SW1.stl
boards/capture-clip/case/case-bottom.stl
boards/capture-clip/case/case-lid.stl
boards/starter/case/cap-SW2.stl
boards/starter/case/case-bottom.stl
boards/starter/case/case-lid.stl
