vaknin/PCB/firmware/test/fixtures/capture/laptop_addition.md

---
id: c0ffee00000000000000000000000003
created: 2026-09-19T09:00:00Z
num: 43
source: laptop
---

# Label maker for jars

- Print labels for the spice jars.
- Use the old thermal printer.

## Transcript

Print labels for the spice jars.

## Added
<!-- addition add00000000000000000000000000002 created=2026-09-19T09:02:36Z source=laptop -->

Use the old thermal printer for it.
