vaknin/PCB/firmware/test/fixtures/capture/phone_list.md

---
id: c0ffee00000000000000000000000001
created: 2026-09-19T09:00:00Z
num: 41
duration_ms: 56634
source: phone
---

# Bird feeder with a camera

- Put a small camera on the bird feeder.
- Sort the pictures by species.

## Transcript

I want a bird feeder that takes a picture of every visitor. Later it could sort them by species.
