vaknin/PCB/firmware/test/fixtures/capture/phone_paragraph.md

---
id: c0ffee00000000000000000000000004
created: 2026-09-19T09:00:00Z
num: 44
duration_ms: 20343
source: phone
---

# Compost thermometer

A probe that reports how warm the compost heap is, so it is turned at the right time.

## Transcript

The compost heap should tell me how warm it is. Then I know when to turn it.
