vaknin/PCB/firmware/test/fixtures/capture/phone_typed_addition.md

---
id: c0ffee00000000000000000000000002
created: 2026-09-19T09:00:00Z
num: 42
duration_ms: 9023
source: phone
---

# Kite with lights

- Build a kite with a strip of lights.
- Power it from a coin cell.

## Transcript

A kite with lights on it, for flying at dusk.

## Added
<!-- addition add00000000000000000000000000001 created=2026-09-19T14:36:05Z source=phone -->

A coin cell should be enough to power it.
