vaknin/PCB/templates/errata.md

# <Board title>: errata, revision <X>

What was wrong with this revision at bring-up and after. Copy to
`boards/<name>/errata-rev<X>.md`. The next revision fixes every open item in one go
(`docs/workflow.md` step 6). Mark each cause VERIFIED (measured, seen) or INFERRED.

| # | Found | What happens | Cause | Workaround on this board | Fix in the next revision | Status |
|---|---|---|---|---|---|---|
| E1 | self-test / bring-up step / use | what the owner sees | why (VERIFIED/INFERRED) | rework, firmware change, or none | circuit or layout change | open |

## Self-test results at bring-up
Paste the self-test report here, one block per board (boards are numbered by the order
they were tested).

## Notes
