vaknin/PCB/boards/starter/kicad/starter.kicad_pcb

## KiCad design boards/starter/kicad/starter.kicad_pcb (2026-10-01)

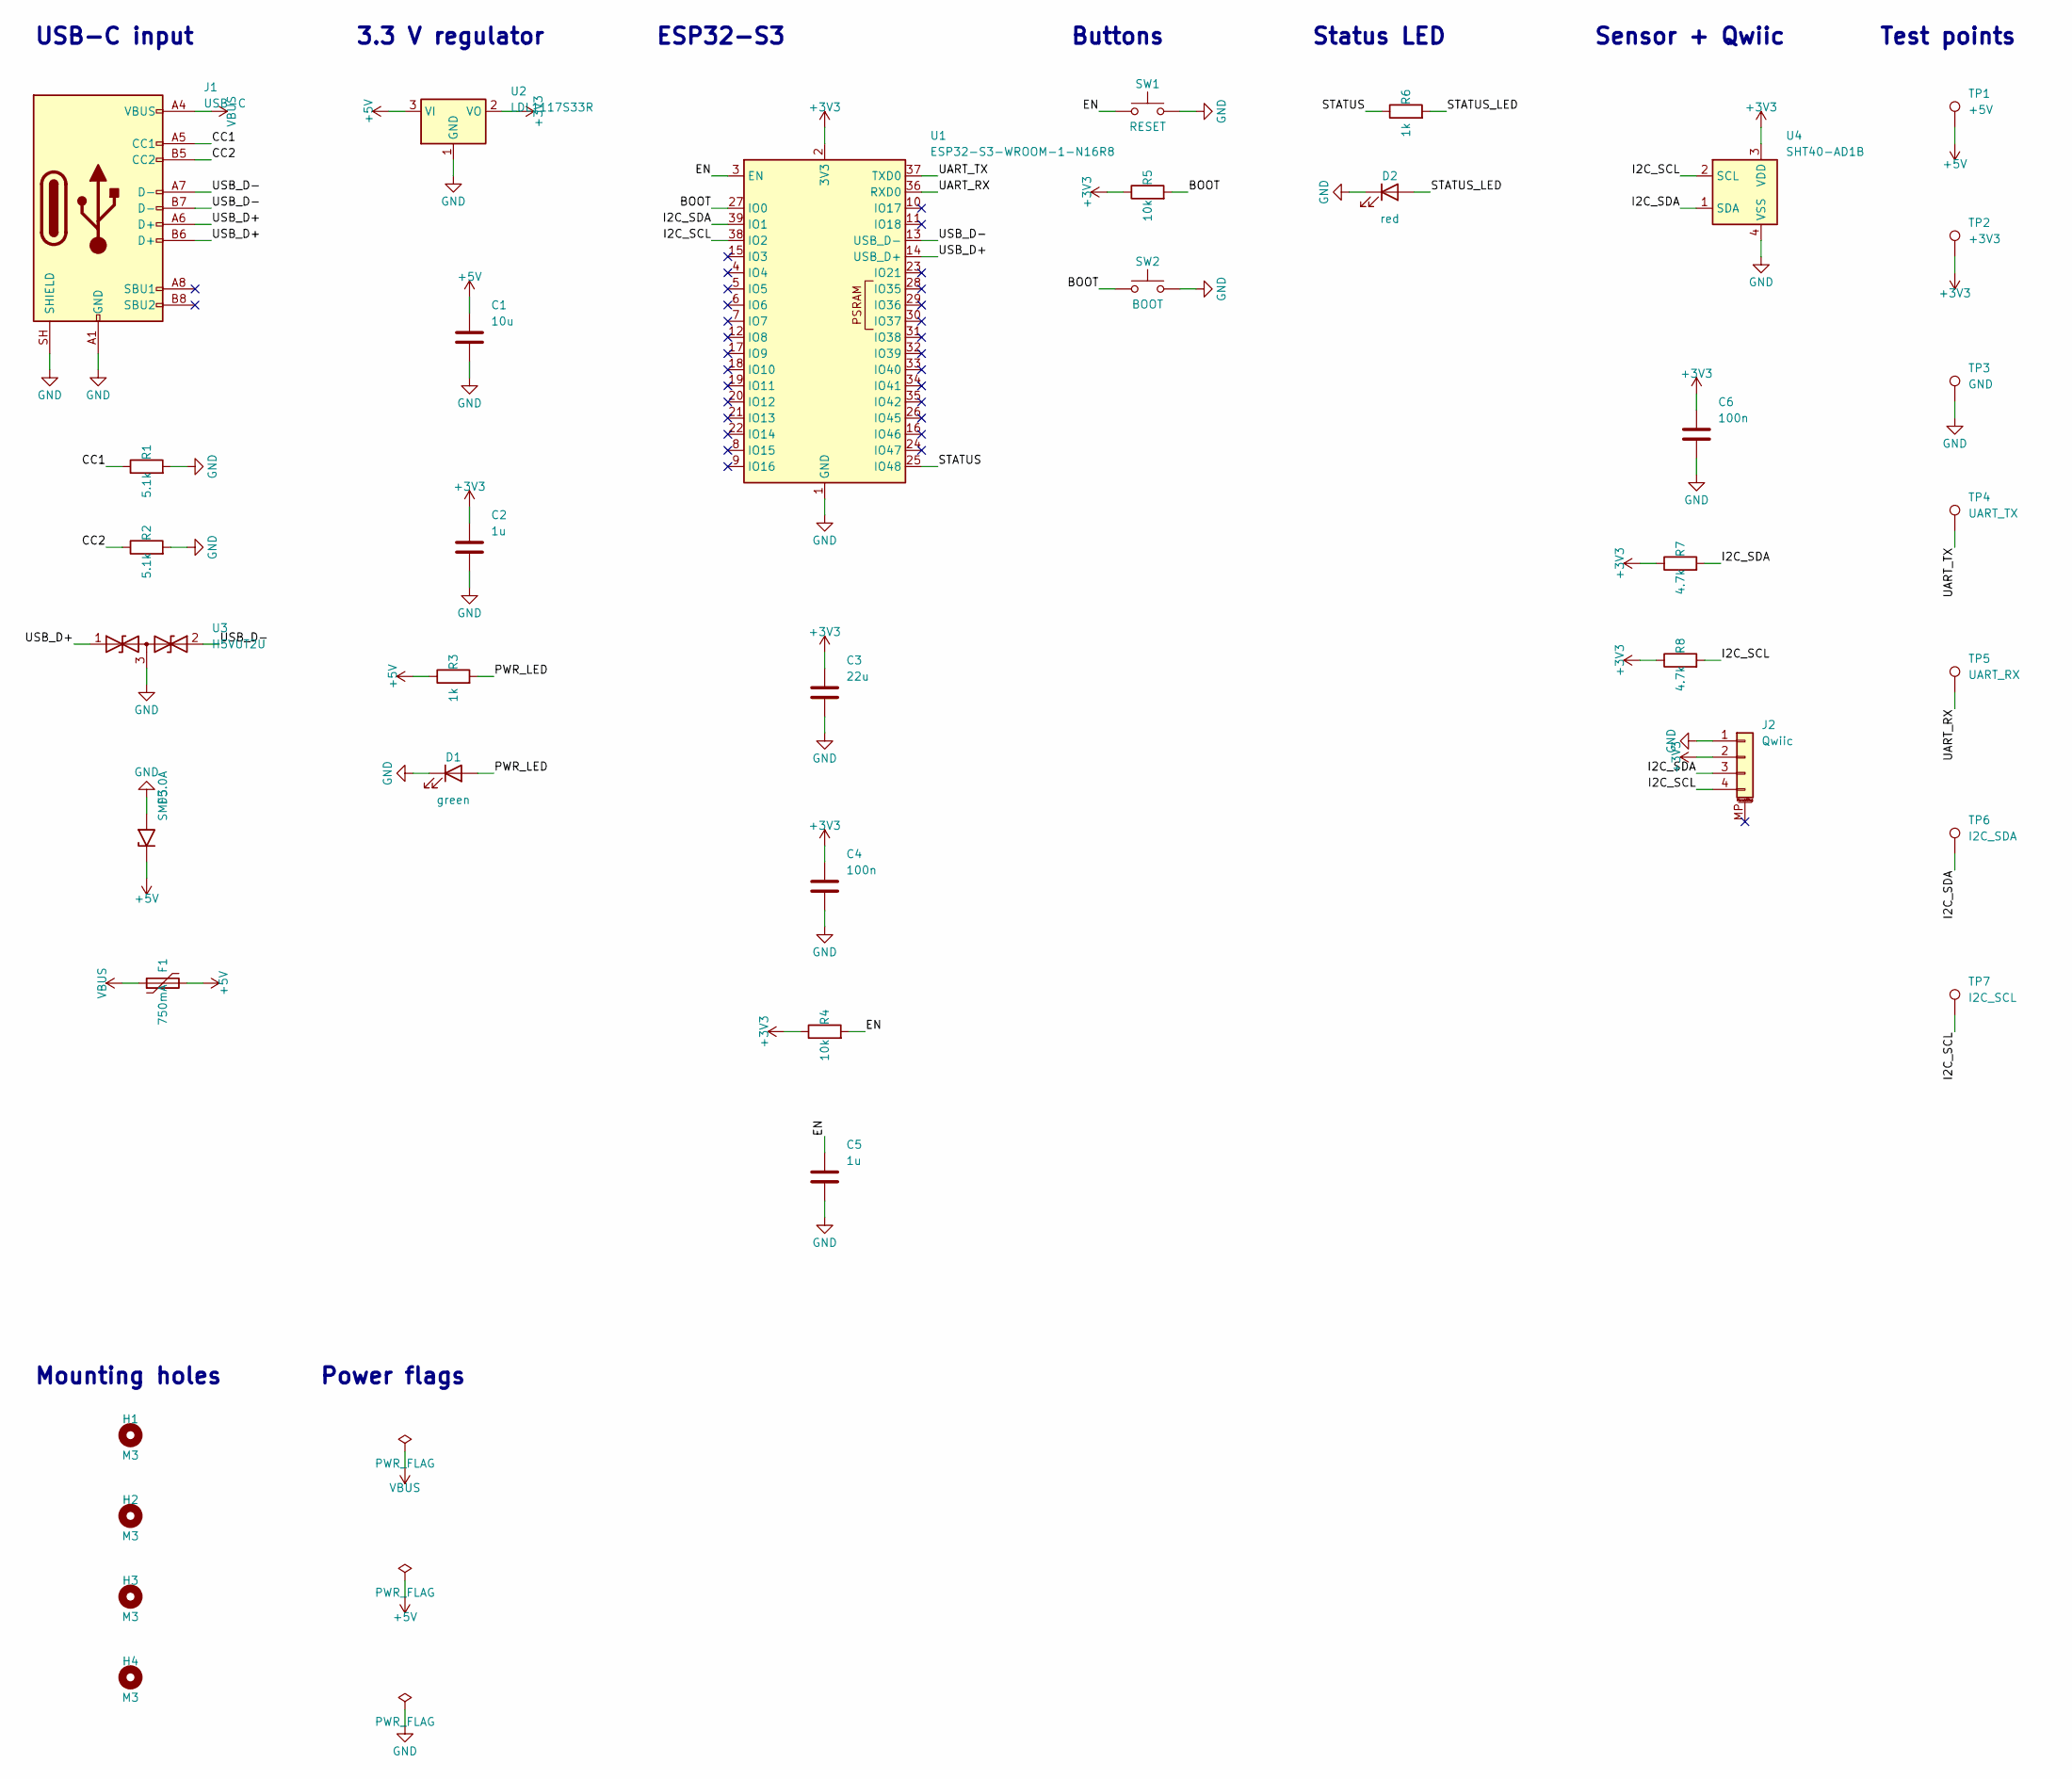
[picture p12: schematic starter.kicad_sch, ESP32-S3 starter board]

Parts:
C1: 10u; C_0805_2012Metric; MPN CL21A106KAYNNNE; LCSC C15850
C2, C5: 1u; C_0805_2012Metric; MPN CL21B105KBFNNNE; LCSC C28323
C3: 22u; C_0805_2012Metric; MPN CL21A226MAQNNNE; LCSC C45783
C4, C6: 100n; C_0805_2012Metric; MPN CC0805KRX7R9BB104; LCSC C49678
D1: green; LED_0805_2012Metric; MPN KT-0805G; LCSC C2297
D2: red; LED_0805_2012Metric; MPN NCD0805R1; LCSC C84256
D3: SMF5.0A; D_SOD-123F; MPN SMF5.0A; LCSC C19077497
F1: 750mA; Fuse_1206_3216Metric; MPN MF-NSMF075-2; LCSC C89653
H1, H2, H3, H4: M3; MountingHole_3.2mm_M3
J1: USB-C; USB_C_Receptacle_HRO_TYPE-C-31-M-12; MPN TYPE-C-31-M-12; LCSC C165948
J2: Qwiic; JST_SH_SM04B-SRSS-TB_1x04-1MP_P1.00mm_Horizontal; MPN SM04B-SRSS-TB; LCSC C160404
R1, R2: 5.1k; R_0805_2012Metric; MPN 0805W8F5101T5E; LCSC C27834
R3, R6: 1k; R_0805_2012Metric; MPN 0805W8F1001T5E; LCSC C17513
R4, R5: 10k; R_0805_2012Metric; MPN 0805W8F1002T5E; LCSC C17414
R7, R8: 4.7k; R_0805_2012Metric; MPN 0805W8F4701T5E; LCSC C17673
SW1: RESET; SW_Push_1P1T_XKB_TS-1187A; MPN TS-1187A-B-A-B; LCSC C318884
SW2: BOOT; SW_Push_1P1T_XKB_TS-1187A; MPN TS-1187A-B-A-B; LCSC C318884
TP1: +5V; TestPoint_Pad_D1.5mm
TP2: +3V3; TestPoint_Pad_D1.5mm
TP3: GND; TestPoint_Pad_D1.5mm
TP4: UART_TX; TestPoint_Pad_D1.5mm
TP5: UART_RX; TestPoint_Pad_D1.5mm
TP6: I2C_SDA; TestPoint_Pad_D1.5mm
TP7: I2C_SCL; TestPoint_Pad_D1.5mm
U1: ESP32-S3-WROOM-1-N16R8; ESP32-S3-WROOM-1_EPAD-Drill0.3; MPN ESP32-S3-WROOM-1-N16R8; LCSC C2913202
U2: LDL1117S33R; SOT-223-3_TabPin2; MPN LDL1117S33R; LCSC C435835
U3: H5VUT2U; SOT-23; MPN H5VUT2U; LCSC C20615824
U4: SHT40-AD1B; Sensirion_DFN-4_1.5x1.5mm_P0.8mm_SHT4x_NoCentralPad; MPN SHT40-AD1B-R2; LCSC C2909890

Connections:
+3V3: C2.1, C3.1, C4.1, C6.1, J2.2, R4.1, R5.1, R7.1, R8.1, TP2.1, U1.2 (3V3), U2.2 (VO), U4.3 (VDD)
+5V: C1.1, D3.1 (A1), F1.2, R3.1, TP1.1, U2.3 (VI)
/BOOT: R5.2, SW2.1, U1.27 (IO0)
/CC1: J1.A5 (CC1), R1.1
/CC2: J1.B5 (CC2), R2.1
/EN: C5.1, R4.2, SW1.1, U1.3 (EN)
/I2C_SCL: J2.4, R8.2, TP7.1, U1.38 (IO2), U4.2 (SCL)
/I2C_SDA: J2.3, R7.2, TP6.1, U1.39 (IO1), U4.1 (SDA)
/PWR_LED: D1.2 (A), R3.2
/STATUS: R6.1, U1.25 (IO48)
/STATUS_LED: D2.2 (A), R6.2
/UART_RX: TP5.1, U1.36 (RXD0)
/UART_TX: TP4.1, U1.37 (TXD0)
/USB_D+: J1.A6 (D+), J1.B6 (D+), U1.14 (USB_D+), U3.1 (A1)
/USB_D-: J1.A7 (D-), J1.B7 (D-), U1.13 (USB_D-), U3.2 (A2)
GND: C1.2, C2.2, C3.2, C4.2, C5.2, C6.2, D1.1 (K), D2.1 (K), D3.2 (A2), J1.A1 (GND), J1.A12 (GND), J1.B1 (GND), J1.B12 (GND), J1.SH (SHIELD), J2.1, R1.2, R2.2, SW1.2, SW2.2, TP3.1, U1.1 (GND), U1.40 (GND), U1.41 (GND), U2.1 (GND), U3.3 (common), U4.4 (VSS)
VBUS: F1.1, J1.A4 (VBUS), J1.A9 (VBUS), J1.B4 (VBUS), J1.B9 (VBUS)

Notes on the sheet:
Mounting holes
Sensor + Qwiic
ESP32-S3
USB-C input
Power flags
Buttons
Test points
3.3 V regulator
Status LED

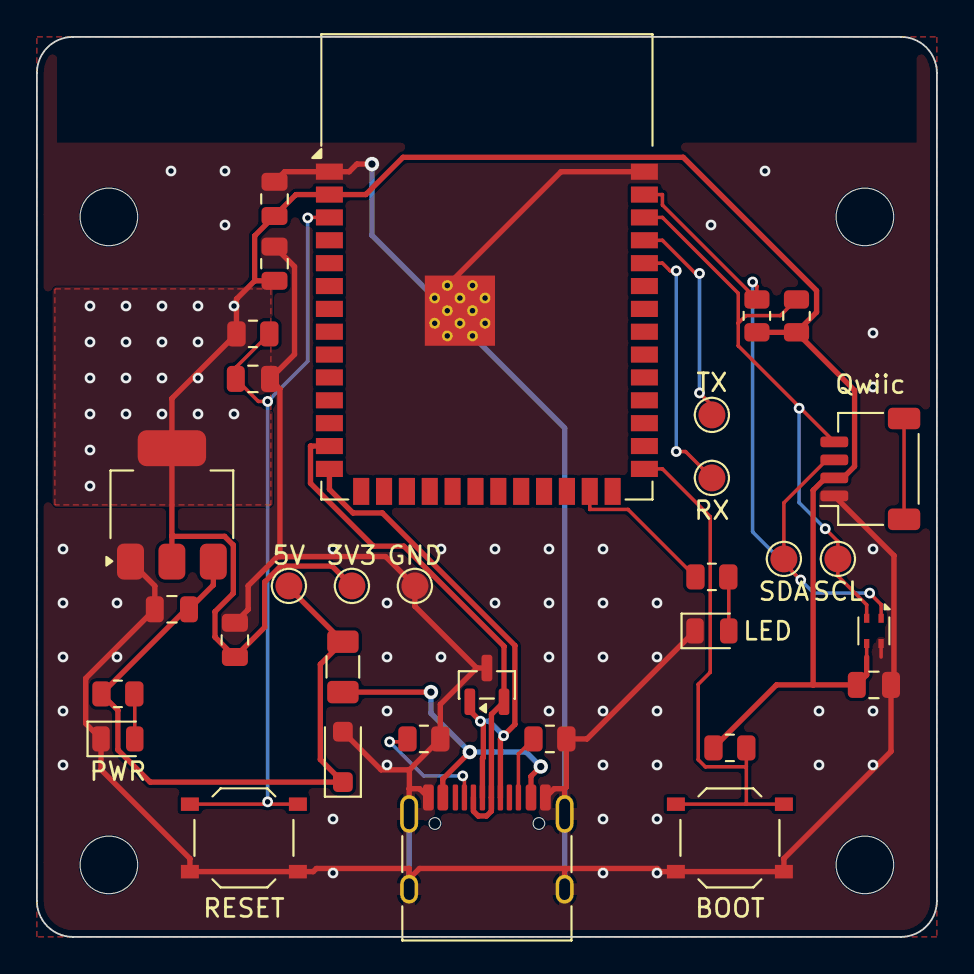
[picture p13: board starter.kicad_pcb from above]

Board: 2 copper layers, 50.0 x 50.0 mm, 37 parts (0 on the bottom side), 17 nets.
