vaknin/PCB/boards/capture-clip/kicad/capture-clip.kicad_pcb

## KiCad design boards/capture-clip/kicad/capture-clip.kicad_pcb (2026-09-30)

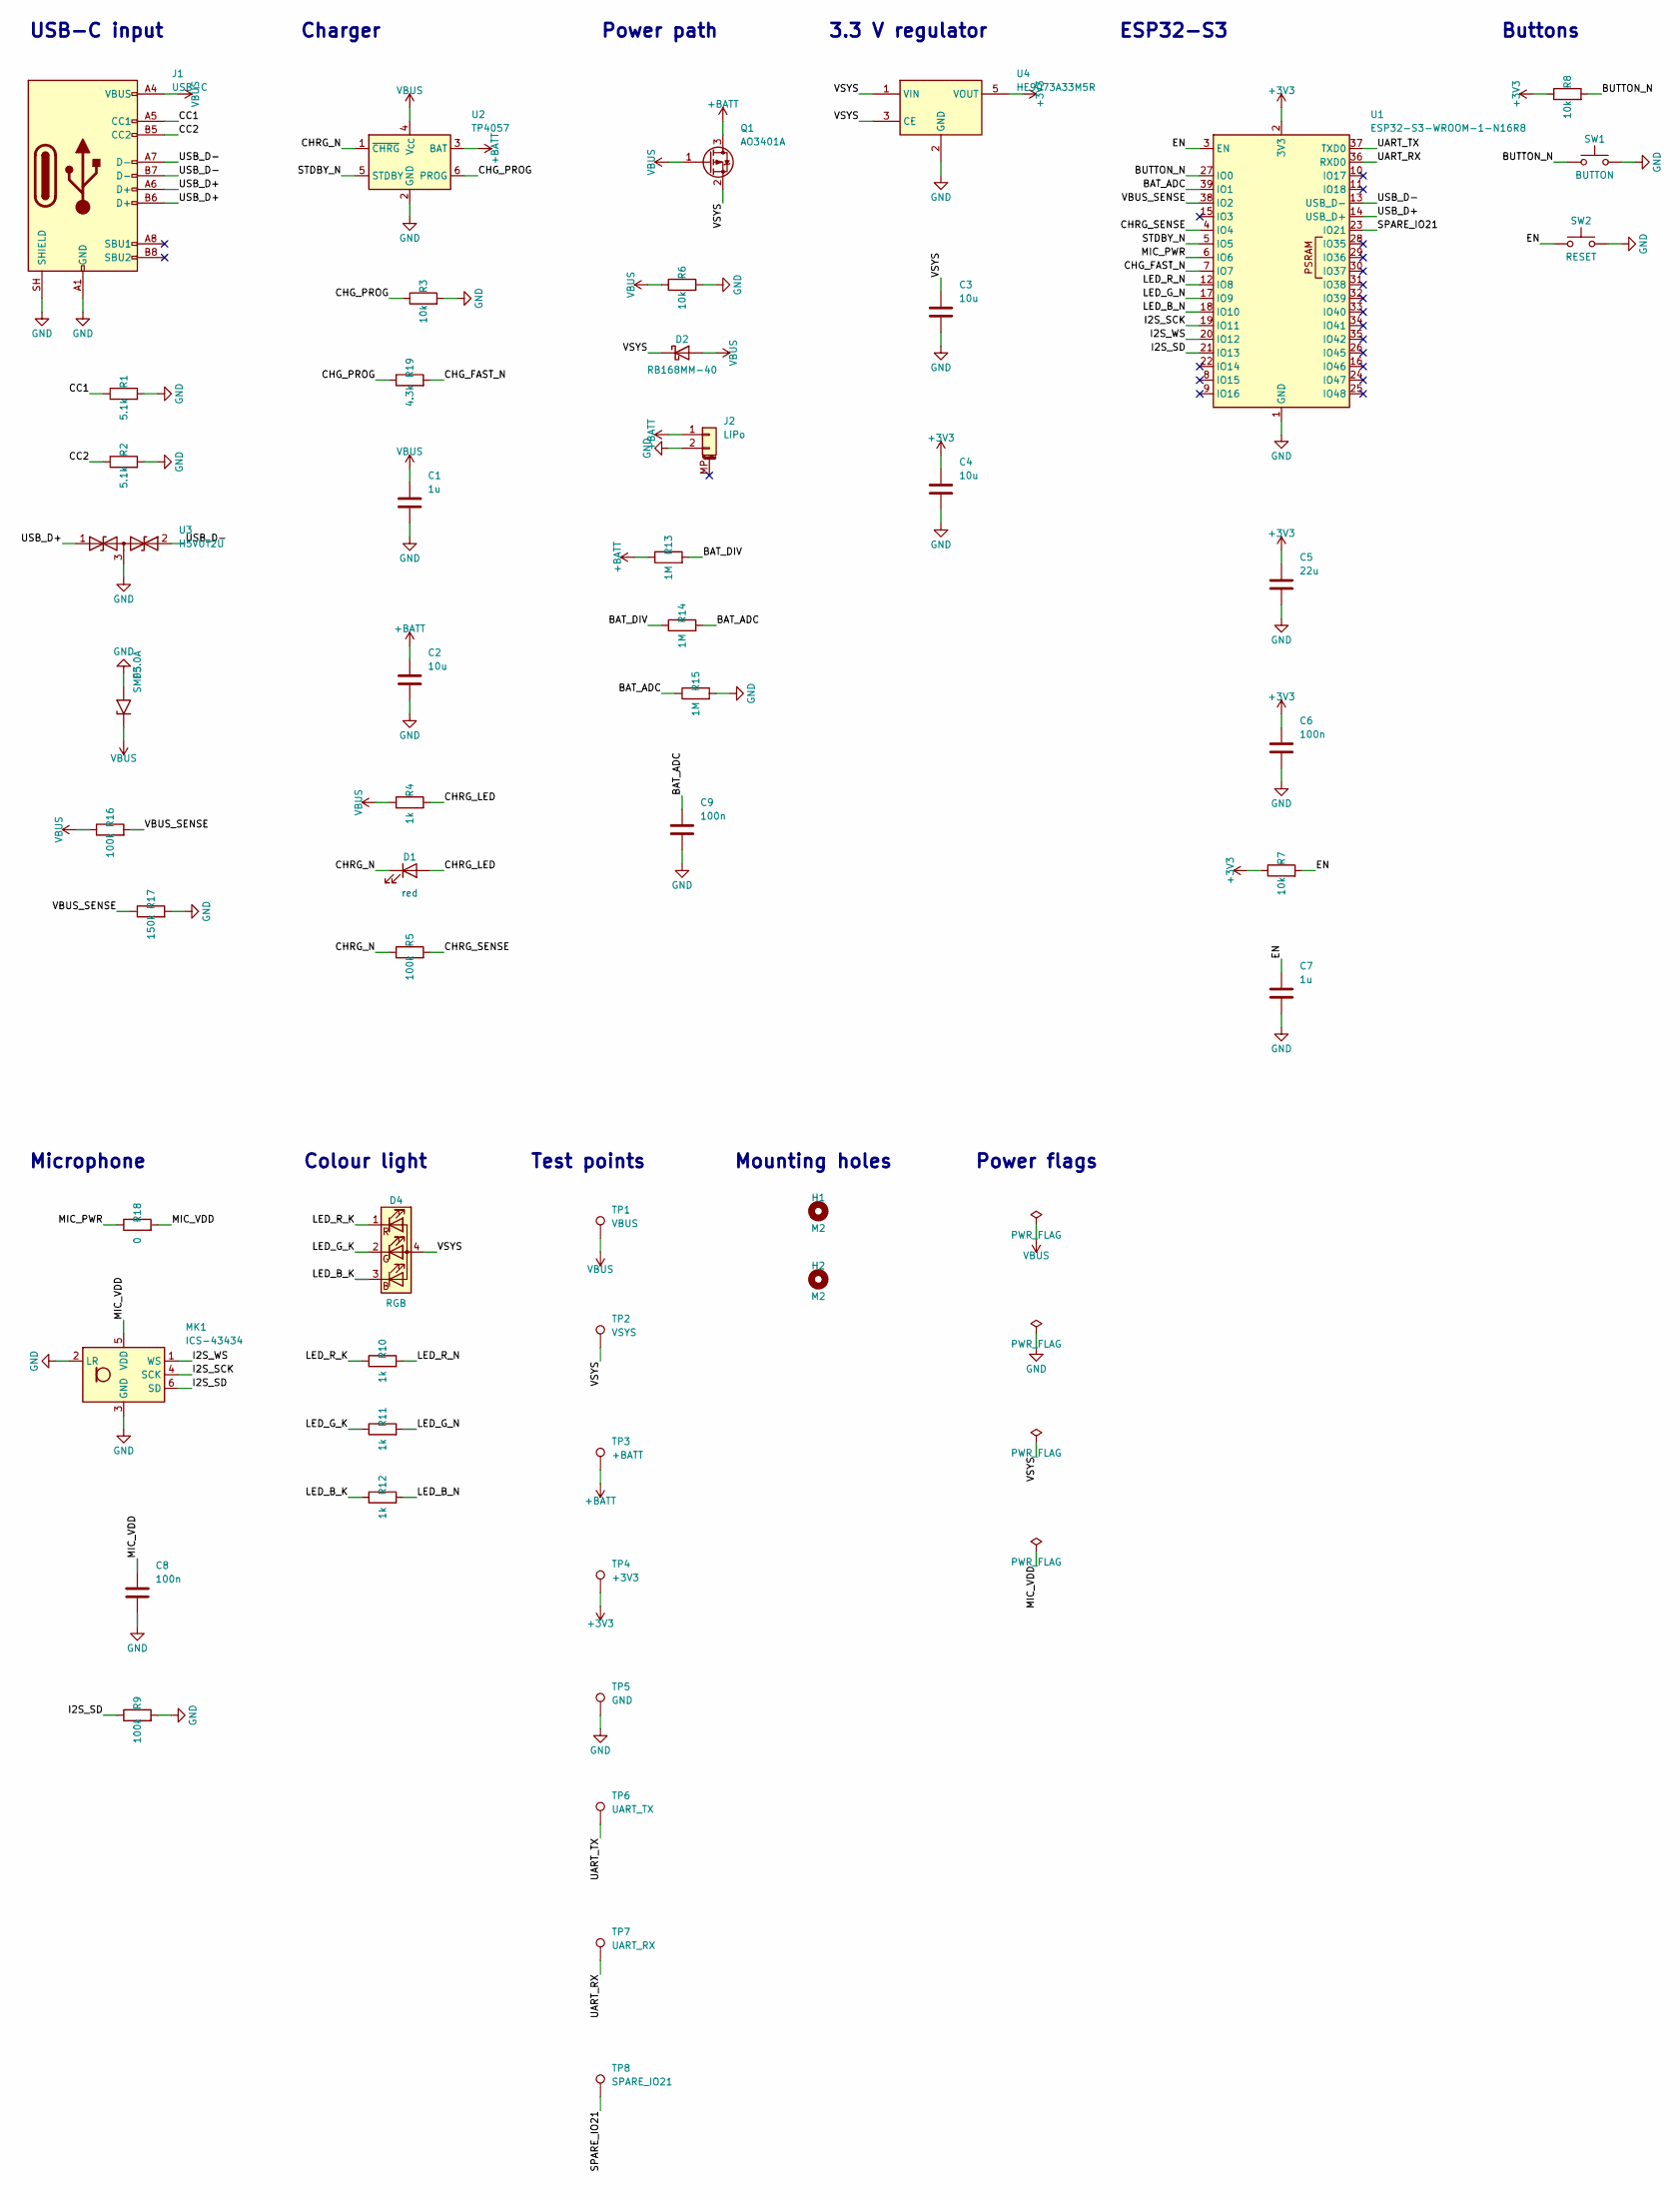
[picture p14: schematic capture-clip.kicad_sch, Capture clip]

Parts:
C1, C7: 1u; C_0805_2012Metric; LCSC C28323
C2, C3, C4: 10u; C_0805_2012Metric; LCSC C15850
C5: 22u; C_0805_2012Metric; LCSC C45783
C6, C8, C9: 100n; C_0805_2012Metric; LCSC C49678
D1: red; LED_0805_2012Metric; LCSC C84256
D2: RB168MM-40; D_SOD-123F; MPN RB168MM-40TR; LCSC C509936
D3: SMF5.0A; D_SOD-123F; MPN SMF5.0A; LCSC C19077497
D4: RGB; LED_LiteOn_LTST-C19HE1WT; MPN LTST-C19HE1WT; LCSC C458749
H1, H2: M2; MountingHole_2.5mm
J1: USB-C; USB_C_Receptacle_HRO_TYPE-C-31-M-12; MPN TYPE-C-31-M-12; LCSC C165948
J2: LiPo; JST_PH_S2B-PH-SM4-TB_1x02-1MP_P2.00mm_Horizontal; MPN S2B-PH-SM4-TB(LF)(SN); LCSC C295747
MK1: ICS-43434; InvenSense_ICS-43434-6_3.5x2.65mm; MPN ICS-43434; LCSC C5656610
Q1: AO3401A; SOT-23; MPN AO3401A; LCSC C15127
R1, R2: 5.1k; R_0805_2012Metric; LCSC C27834
R3, R6, R7, R8: 10k; R_0805_2012Metric; LCSC C17414
R4, R10, R11, R12: 1k; R_0805_2012Metric; LCSC C17513
R5, R9, R16: 100k; R_0805_2012Metric; LCSC C149504
R13, R14, R15: 1M; R_0805_2012Metric; LCSC C17514
R17: 150k; R_0805_2012Metric; LCSC C17470
R18: 0; R_0805_2012Metric; LCSC C17477
R19: 4.3k; R_0805_2012Metric; LCSC C17667
SW1: BUTTON; SW_Push_1TS009xxxx-xxxx-xxxx_6x6x5mm; MPN 1TS009A-1800-5000-CT; LCSC C319409
SW2: RESET; SW_SPST_TS-1088-xR020; MPN TS-1088-AR02016; LCSC C720477
TP1: VBUS; TestPoint_Pad_D1.5mm
TP2: VSYS; TestPoint_Pad_D1.5mm
TP3: +BATT; TestPoint_Pad_D1.5mm
TP4: +3V3; TestPoint_Pad_D1.5mm
TP5: GND; TestPoint_Pad_D1.5mm
TP6: UART_TX; TestPoint_Pad_D1.5mm
TP7: UART_RX; TestPoint_Pad_D1.5mm
TP8: SPARE_IO21; TestPoint_Pad_D1.5mm
U1: ESP32-S3-WROOM-1-N16R8; ESP32-S3-WROOM-1_EPAD-Drill0.3; MPN ESP32-S3-WROOM-1-N16R8; LCSC C2913202
U2: TP4057; SOT-23-6; MPN TP4057-42-SOT26-R; LCSC C12044
U3: H5VUT2U; SOT-23; MPN H5VUT2U; LCSC C20615824
U4: HE9073A33M5R; SOT-23-5; MPN HE9073A33M5R; LCSC C723789

Connections:
+3V3: C4.1, C5.1, C6.1, R7.1, R8.1, TP4.1, U1.2 (3V3), U4.5 (VOUT)
+BATT: C2.1, J2.1, Q1.3 (D), R13.1, TP3.1, U2.3 (BAT)
/BAT_ADC: C9.1, R14.2, R15.1, U1.39 (IO1)
/BAT_DIV: R13.2, R14.1
/BUTTON_N: R8.2, SW1.1, U1.27 (IO0)
/CC1: J1.A5 (CC1), R1.1
/CC2: J1.B5 (CC2), R2.1
/CHG_FAST_N: R19.2, U1.7 (IO7)
/CHG_PROG: R3.1, R19.1, U2.6 (PROG)
/CHRG_LED: D1.2 (A), R4.2
/CHRG_N: D1.1 (K), R5.1, U2.1 (~CHRG)
/CHRG_SENSE: R5.2, U1.4 (IO4)
/EN: C7.1, R7.2, SW2.1, U1.3 (EN)
/I2S_SCK: MK1.4 (SCK), U1.19 (IO11)
/I2S_SD: MK1.6 (SD), R9.1, U1.21 (IO13)
/I2S_WS: MK1.1 (WS), U1.20 (IO12)
/LED_B_K: D4.3 (BK), R12.1
/LED_B_N: R12.2, U1.18 (IO10)
/LED_G_K: D4.2 (GK), R11.1
/LED_G_N: R11.2, U1.17 (IO9)
/LED_R_K: D4.1 (RK), R10.1
/LED_R_N: R10.2, U1.12 (IO8)
/MIC_PWR: R18.1, U1.6 (IO6)
/MIC_VDD: C8.1, MK1.5 (VDD), R18.2
/SPARE_IO21: TP8.1, U1.23 (IO21)
/STDBY_N: U1.5 (IO5), U2.5 (STDBY)
/UART_RX: TP7.1, U1.36 (RXD0)
/UART_TX: TP6.1, U1.37 (TXD0)
/USB_D+: J1.A6 (D+), J1.B6 (D+), U1.14 (USB_D+), U3.1 (A1)
/USB_D-: J1.A7 (D-), J1.B7 (D-), U1.13 (USB_D-), U3.2 (A2)
/VBUS_SENSE: R16.2, R17.1, U1.38 (IO2)
/VSYS: C3.1, D2.1 (K), D4.4 (A), Q1.2 (S), TP2.1, U4.1 (VIN), U4.3 (CE)
GND: C1.2, C2.2, C3.2, C4.2, C5.2, C6.2, C7.2, C8.2, C9.2, D3.2 (A2), J1.A1 (GND), J1.A12 (GND), J1.B1 (GND), J1.B12 (GND), J1.SH (SHIELD), J2.2, MK1.2 (LR), MK1.3 (GND), R1.2, R2.2, R3.2, R6.2, R9.2, R15.2, R17.2, SW1.2, SW2.2, TP5.1, U1.1 (GND), U1.40 (GND), U1.41 (GND), U2.2 (GND), U3.3 (common), U4.2 (GND)
VBUS: C1.1, D2.2 (A), D3.1 (A1), J1.A4 (VBUS), J1.A9 (VBUS), J1.B4 (VBUS), J1.B9 (VBUS), Q1.1 (G), R4.1, R6.1, R16.1, TP1.1, U2.4 (V_{CC})

Notes on the sheet:
Test points
Power path
Colour light
3.3 V regulator
Buttons
Power flags
USB-C input
Charger
Mounting holes
Microphone
ESP32-S3

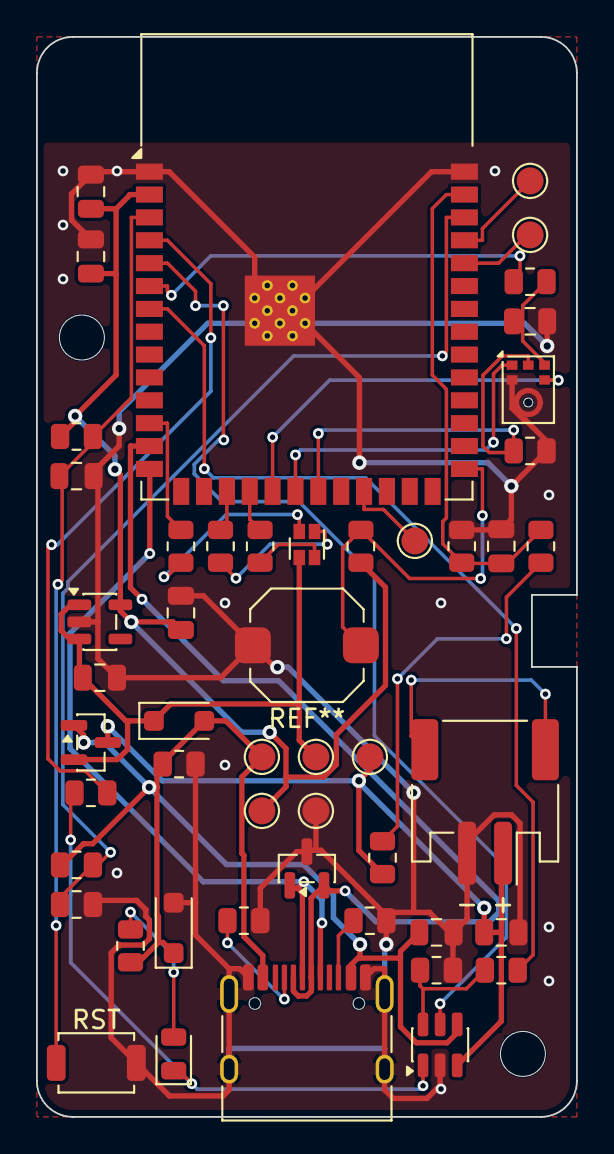
[picture p15: board capture-clip.kicad_pcb from above]

Board: 2 copper layers, 30.0 x 60.0 mm, 52 parts (0 on the bottom side), 34 nets.
