vaknin/PCB/crates/pcbgen/src/boardfile.rs

//! `board.toml`: the facts that the circuit, the firmware and the spec must agree on
//! (D-022, D-023). One per board, next to its `Cargo.toml`:
//!
//! ```toml
//! [board]          name = "starter"; revision = "0"; module = "U1"
//! [[pin]]          signal = "I2C_SDA"; pin = "IO1"; net = "I2C_SDA"; gpio = 1; dir = "io"
//! [[power.source]] name = "usb"; what = "USB-C 5 V"; sleep_ua = 20 (optional)
//! [[power.source.limit]] name = "USB 2.0 default"; ma = 500; source = "..."
//! [[power.load]]   name = "ESP32-S3 Wi-Fi TX peak"; ma = 355; source = "WROOM-1 datasheet"; from = ["usb"]
//! [[power.sleep_load]] name = "LDO quiescent"; ua = 2; source = "VERIFIED: datasheet p.3"
//! [[requirement]]  id = "R1"; text = "..."; covered_by = ["part:J1", "pin:I2C_SDA", "test:sht40", "gate:drc"]
//! [firmware]       self_test = ["sht40"]
//! [[sim.wokwi_step]] wait = "SELFTEST_PRESS boot_button"; press = "BOOT"
//! [[sim.scenario]] name = "press"; about = "..."; [[sim.scenario.step]] sim = "PRESS 300"
//! [provision]      gemini_api_key = "file:~/.config/capture-notes/config#gemini_api_key"
//!                  github_token = { from = "file:...#github_token", expires = "2027-09-18" }
//! [case]           material = "resin"; wall = 1.5; screw = "M3"
//! [[case.opening]] ref = "J1"; kind = "usb_c"
//! [case.battery]   size = [36, 17, 7.8]; lead = "J3"
//! [[requirement.proof]] how = "simulated"; evidence = "QEMU scenario record_upload"
//! [[risk]]         what = "..."; tag = "INFERRED"; fix = "new_board"; miss = "..."; check = "..."; accepted = "..."
//! ```
//!
//! `gate` checks it against the circuit and the board's `spec.md`; `header` turns it into
//! the firmware's `board_pins.h`. Unknown keys are errors, so a typo can't pass silently.

use std::collections::{BTreeMap, BTreeSet, HashSet};
use std::path::Path;

use anyhow::{Context, Result};
use regex::Regex;
use serde::{Deserialize, Serialize};

use crate::circuit::Circuit;

pub const FILE: &str = "board.toml";
/// Gate names a requirement may be covered by (`gate:<name>`).
pub const GATES: [&str; 6] = ["erc", "drc", "netlist", "netclasses", "routing", "board_toml"];

#[derive(Debug, Deserialize)]
#[serde(deny_unknown_fields)]
pub struct BoardFile {
    pub board: BoardInfo,
    #[serde(rename = "pin", default)]
    pub pins: Vec<PinMap>,
    pub power: Power,
    #[serde(rename = "requirement", default)]
    pub requirements: Vec<Requirement>,
    #[serde(default)]
    pub firmware: Firmware,
    #[serde(default)]
    pub order: Order,
    #[serde(default)]
    pub sim: Sim,
    /// NVS key -> where `devctl provision` gets its value: `file:<path>#<field>` (a
    /// `field = value` line in that file) or `prompt`, optionally with the secret's expiry
    /// date. Only references; values never enter the repo (D-025).
    #[serde(default)]
    pub provision: BTreeMap<String, Provision>,
    /// The printed case (D-025 Phase B), built and fit-checked by the `case` stage; None: no case.
    pub case: Option<Case>,
    /// Every guess and unchecked fact the design still rests on, for the readiness page
    /// (`crate::readiness`, docs/workflow.md "Right the first time").
    #[serde(rename = "risk", default)]
    pub risks: Vec<Risk>,
}

/// `[case]`: a two-part printed shell (bottom tray + lid) around the board, made by
/// `enclosure/case.py` from `case/board.json` (the `case` stage, `crate::case`). mm throughout.
/// Printing rules are JLC3DP's design guide (research/2026-09-29-enclosure-tooling.md §3).
#[derive(Debug, Clone, Deserialize)]
#[serde(deny_unknown_fields)]
pub struct Case {
    /// Sets the minimum wall, hole and skin (`Material::limits`).
    pub material: Material,
    /// Side wall.
    #[serde(default = "d1_5")]
    pub wall: f64,
    /// Floor of the tray and top plate of the lid.
    #[serde(default = "d1_5")]
    pub floor: f64,
    /// PCB edge to the inner wall (static fit 0.2 + print tolerance).
    #[serde(default = "d0_3")]
    pub edge_gap: f64,
    /// Tallest top-side part to the lid's underside.
    #[serde(default = "d1_0")]
    pub top_gap: f64,
    /// PCB underside to the floor: the standoff height.
    #[serde(default = "d3_0")]
    pub bottom_gap: f64,
    /// Fit gate: every case solid to every part solid, except intended contacts.
    #[serde(default = "d0_2")]
    pub min_clearance: f64,
    /// Self-tapping screw for plastic: from below through a standoff and the PCB's mounting
    /// hole into a boss in the lid.
    #[serde(default)]
    pub screw: Screw,
    #[serde(rename = "opening", default)]
    pub openings: Vec<Opening>,
    /// A single-cell LiPo under the board, in a fenced pocket on the tray's floor.
    pub battery: Option<Battery>,
}

/// `[case.battery]`: the cell lies on the tray's floor under the board, in a pocket fenced on
/// all sides by a low rib, open on the side facing its lead's connector. The fit gate checks the
/// cell against the case and the cell plus its swelling room against the board's underside
/// (research/2026-09-29-enclosure-tooling.md §4: ribs on four sides, room to swell, nothing
/// pressing on it).
#[derive(Debug, Clone, Deserialize)]
#[serde(deny_unknown_fields)]
pub struct Battery {
    /// Length, width and thickness of the cell (mm), from its datasheet, lead and tape included.
    pub size: [f64; 3],
    /// Centre of the cell, in board coordinates (mm); the board's centre if not given.
    pub at: Option<[f64; 2]>,
    /// The cell's length runs along the board's y axis instead of x.
    #[serde(default)]
    pub rotate: bool,
    /// Headroom over the cell for swelling (mm); 10 % of its thickness if not given (INFERRED:
    /// pouch cells swell several % over their life).
    pub swell: Option<f64>,
    /// Gap between the cell and its fence, per side (mm).
    #[serde(default = "d0_5")]
    pub pad: f64,
    /// The part the cell's lead plugs into (a JST PH): the fence opens on that side.
    pub lead: Option<String>,
}

impl Battery {
    /// Fence rib height above the floor (mm): up to the cell's mid-height, at most 3 mm
    /// (INFERRED: enough to stop it sliding, low enough to lift it out).
    fn fence_height(&self) -> f64 {
        (self.size[2] / 2.0).min(3.0)
    }

    fn swell(&self) -> f64 {
        self.swell.unwrap_or(0.1 * self.size[2])
    }

    /// Floor to the board's underside the cell needs (mm): thickness + swell + clearance.
    pub fn needs(&self, min_clearance: f64) -> f64 {
        self.size[2] + self.swell() + min_clearance
    }
}

fn d0_2() -> f64 {
    0.2
}
fn d0_5() -> f64 {
    0.5
}
fn d0_3() -> f64 {
    0.3
}
fn d1_0() -> f64 {
    1.0
}
fn d1_5() -> f64 {
    1.5
}
fn d3_0() -> f64 {
    3.0
}

#[derive(Debug, Clone, Copy, PartialEq, Eq, Deserialize, Serialize)]
#[serde(rename_all = "lowercase")]
pub enum Material {
    /// SLA, JLC3DP 9600 white resin: cheapest, finest; brittle (no snap arms), translucent.
    Resin,
    /// MJF PA12 nylon: tough, black or grey.
    Nylon,
}

/// A material's printing limits, mm (JLC3DP design guide, VERIFIED 2026-09-29, unless noted).
#[derive(Debug, Clone, Copy, Serialize)]
pub struct Limits {
    /// Side wall and floor: resin 1.2 (the upload checker's "wall thickness > 1.2 mm"),
    /// nylon 1.5 (the guide's 50 × 50 mm row).
    pub wall_min: f64,
    /// Smallest hole: SLA Ø1.0, others Ø1.5.
    pub hole_min: f64,
    /// Bosses, snaps and fasteners: "more than 1.5 mm".
    pub boss_wall_min: f64,
    /// Thinnest local skin (LED window, the wall left at the USB-C recess): resin 0.8 (the
    /// upload checker's "thinnest part ≥ 0.8 mm"), nylon 1.0 (PA12-HP's datasheet wall).
    pub skin_min: f64,
    /// Static fit clearance per side (resin 0.2; nylon 0.2-0.4).
    pub static_fit: f64,
    /// Moving fit clearance per side (resin 0.5, nylon 0.6): the button cap in its hole.
    pub moving_fit: f64,
    /// Smallest printable part in each axis (SLA/MJF 5 × 5 × 5).
    pub part_min: f64,
}

impl Material {
    pub fn limits(self) -> Limits {
        match self {
            Material::Resin => Limits { wall_min: 1.2, hole_min: 1.0, boss_wall_min: 1.5, skin_min: 0.8, static_fit: 0.2, moving_fit: 0.5, part_min: 5.0 },
            Material::Nylon => Limits { wall_min: 1.5, hole_min: 1.5, boss_wall_min: 1.5, skin_min: 1.0, static_fit: 0.2, moving_fit: 0.6, part_min: 5.0 },
        }
    }
}

/// Self-tapping (thread-forming) screws for plastic, by nominal size.
#[derive(Debug, Clone, Copy, PartialEq, Eq, Default, Deserialize, Serialize)]
pub enum Screw {
    M2,
    #[serde(rename = "M2.5")]
    M2_5,
    #[default]
    M3,
}

/// A screw's holes, mm. Pilot ≈ 0.8-0.85 × d for thread-forming screws into plastic and pan
/// head sizes from ISO 7045 (INFERRED: common vendor tables, not checked against the screws
/// that will be bought).
#[derive(Debug, Clone, Copy, Serialize)]
pub struct ScrewHoles {
    pub size: Screw,
    pub d: f64,
    /// Hole in the lid boss the screw cuts its thread into.
    pub pilot: f64,
    /// Hole the screw passes through (standoff).
    pub clearance: f64,
    pub head_d: f64,
    pub head_h: f64,
}

impl Screw {
    pub fn holes(self) -> ScrewHoles {
        let (d, pilot, clearance, head_d, head_h) = match self {
            Screw::M2 => (2.0, 1.7, 2.4, 4.0, 1.6),
            Screw::M2_5 => (2.5, 2.1, 2.9, 5.0, 2.0),
            Screw::M3 => (3.0, 2.5, 3.4, 5.6, 2.4),
        };
        ScrewHoles { size: self, d, pilot, clearance, head_d, head_h }
    }
}

#[derive(Debug, Clone, Copy, PartialEq, Eq, Deserialize, Serialize)]
#[serde(rename_all = "snake_case")]
pub enum OpeningKind {
    /// Wall cutout around a USB-C receptacle's mouth, plus an outer recess for the plug.
    UsbC,
    /// Wall cutout around a connector's mouth (JST, Qwiic).
    Connector,
    /// Lid hole over a tactile switch, with a separate printed cap (plunger).
    Button,
    /// Small lid hole over a switch (reset), with a guide tube for a paper clip.
    Pinhole,
    /// A LED seen through the lid: a thin window (resin) or a hole.
    Led,
    /// Slots in the lid over a part that must see outside air (humidity sensor).
    Vent,
}

impl OpeningKind {
    pub fn as_str(self) -> &'static str {
        match self {
            OpeningKind::UsbC => "usb_c",
            OpeningKind::Connector => "connector",
            OpeningKind::Button => "button",
            OpeningKind::Pinhole => "pinhole",
            OpeningKind::Led => "led",
            OpeningKind::Vent => "vent",
        }
    }
}

#[derive(Debug, Clone, Copy, PartialEq, Eq, Deserialize, Serialize)]
#[serde(rename_all = "lowercase")]
pub enum LedStyle {
    /// A pocket from inside, leaving the material's thinnest skin (resin glows through it).
    Window,
    /// A hole through the lid.
    Hole,
}

/// Which half of the case an opening is in.
#[derive(Debug, Clone, Copy, PartialEq, Eq, Deserialize, Serialize)]
#[serde(rename_all = "lowercase")]
pub enum CaseSide {
    /// The lid, over the part (the default).
    Top,
    /// The tray's floor, under the board: for a part whose port is a hole through the PCB (a
    /// bottom-port microphone). The hole sits under the footprint's one unplated hole, with a
    /// chimney from the floor up to the PCB's underside around it.
    Bottom,
}

/// `[[case.opening]]`: what the case must let through for one part. Only `ref` and `kind` are
/// needed; the rest override the kind's defaults (`Opening::resolved`).
#[derive(Debug, Clone, Deserialize)]
#[serde(deny_unknown_fields)]
pub struct Opening {
    #[serde(rename = "ref")]
    pub reference: String,
    pub kind: OpeningKind,
    /// usb_c, connector: gap around the mouth, per side (0.3).
    pub margin: Option<f64>,
    /// usb_c, connector: the mouth's height above the PCB (usb_c 3.26, INFERRED from the HRO
    /// model; a connector must give its datasheet value).
    pub height: Option<f64>,
    /// button: the cap's diameter (4.0); pinhole: the hole (1.4); led: the window pocket (3.0)
    /// or the hole (2.0).
    pub diameter: Option<f64>,
    /// led: window (default) or hole.
    pub style: Option<LedStyle>,
    /// pinhole: top (default, a lid hole with a guide tube) or bottom (a floor hole with a
    /// chimney up to the part's hole through the PCB).
    pub side: Option<CaseSide>,
    /// button: the switch's travel (0.25, INFERRED: typical for small tactile switches).
    pub travel: Option<f64>,
    /// vent: number of slots (3), their width (1.2) and length (5.0).
    pub slots: Option<u32>,
    pub slot_width: Option<f64>,
    pub slot_length: Option<f64>,
}

/// An opening with every value its kind uses filled in (written to `case/board.json`).
#[derive(Debug, Clone, Serialize)]
pub struct ResolvedOpening {
    #[serde(rename = "ref")]
    pub reference: String,
    pub kind: OpeningKind,
    #[serde(skip_serializing_if = "Option::is_none")]
    pub margin: Option<f64>,
    #[serde(skip_serializing_if = "Option::is_none")]
    pub height: Option<f64>,
    #[serde(skip_serializing_if = "Option::is_none")]
    pub diameter: Option<f64>,
    #[serde(skip_serializing_if = "Option::is_none")]
    pub style: Option<LedStyle>,
    /// Only written when it is `bottom`, so a top opening's JSON is as before.
    #[serde(skip_serializing_if = "Option::is_none")]
    pub side: Option<CaseSide>,
    #[serde(skip_serializing_if = "Option::is_none")]
    pub travel: Option<f64>,
    #[serde(skip_serializing_if = "Option::is_none")]
    pub slots: Option<u32>,
    #[serde(skip_serializing_if = "Option::is_none")]
    pub slot_width: Option<f64>,
    #[serde(skip_serializing_if = "Option::is_none")]
    pub slot_length: Option<f64>,
}

impl Opening {
    /// The keys (besides ref and kind) this kind uses.
    fn keys(kind: OpeningKind) -> &'static [&'static str] {
        match kind {
            OpeningKind::UsbC | OpeningKind::Connector => &["margin", "height"],
            OpeningKind::Button => &["diameter", "travel"],
            OpeningKind::Pinhole => &["diameter", "side"],
            OpeningKind::Led => &["style", "diameter"],
            OpeningKind::Vent => &["slots", "slot_width", "slot_length"],
        }
    }

    /// The keys given in board.toml.
    fn given(&self) -> Vec<&'static str> {
        let o = self;
        [
            ("margin", o.margin.is_some()),
            ("height", o.height.is_some()),
            ("diameter", o.diameter.is_some()),
            ("style", o.style.is_some()),
            ("side", o.side.is_some()),
            ("travel", o.travel.is_some()),
            ("slots", o.slots.is_some()),
            ("slot_width", o.slot_width.is_some()),
            ("slot_length", o.slot_length.is_some()),
        ]
        .into_iter()
        .filter(|x| x.1)
        .map(|x| x.0)
        .collect()
    }

    pub fn resolved(&self) -> ResolvedOpening {
        use OpeningKind::*;
        let k = self.kind;
        let style = (k == Led).then(|| self.style.unwrap_or(LedStyle::Window));
        let diameter = match k {
            Button => Some(self.diameter.unwrap_or(4.0)),
            Pinhole => Some(self.diameter.unwrap_or(1.4)),
            Led => Some(self.diameter.unwrap_or(if style == Some(LedStyle::Hole) { 2.0 } else { 3.0 })),
            _ => None,
        };
        ResolvedOpening {
            reference: self.reference.clone(),
            kind: k,
            margin: matches!(k, UsbC | Connector).then(|| self.margin.unwrap_or(0.3)),
            height: match k {
                UsbC => Some(self.height.unwrap_or(3.26)),
                Connector => self.height,
                _ => None,
            },
            diameter,
            style,
            side: self.side.filter(|&s| k == Pinhole && s == CaseSide::Bottom),
            travel: (k == Button).then(|| self.travel.unwrap_or(0.25)),
            slots: (k == Vent).then(|| self.slots.unwrap_or(3)),
            slot_width: (k == Vent).then(|| self.slot_width.unwrap_or(1.2)),
            slot_length: (k == Vent).then(|| self.slot_length.unwrap_or(5.0)),
        }
    }
}

impl Case {
    /// The table as `case/board.json` carries it: defaults filled, the material's limits and
    /// the screw's holes spelled out, so `enclosure/case.py` has one source of numbers.
    pub fn resolved(&self) -> serde_json::Value {
        serde_json::json!({
            "material": self.material,
            "limits": self.material.limits(),
            "wall": self.wall,
            "floor": self.floor,
            "edge_gap": self.edge_gap,
            "top_gap": self.top_gap,
            "bottom_gap": self.bottom_gap,
            "min_clearance": self.min_clearance,
            "screw": self.screw.holes(),
            "openings": self.openings.iter().map(Opening::resolved).collect::<Vec<_>>(),
            "battery": self.battery.as_ref().map(|b| serde_json::json!({
                "size": b.size,
                "at": b.at,
                "rotate": b.rotate,
                "swell": b.swell(),
                "pad": b.pad,
                "lead": b.lead,
                "fence_height": b.fence_height(),
                "fence_width": self.material.limits().wall_min,
            })),
        })
    }
}

/// Simulation settings (D-025). QEMU needs none; Wokwi needs the parts on the pins (`PinMap::sim`)
/// and the steps that drive them during the self-test run.
#[derive(Debug, Default, Deserialize)]
#[serde(deny_unknown_fields)]
pub struct Sim {
    #[serde(rename = "wokwi_step", default)]
    pub wokwi_steps: Vec<WokwiStep>,
    /// QEMU scenarios the `sim` stage runs (`crate::scenario`), each on a fresh copy of the image.
    #[serde(rename = "scenario", default)]
    pub scenarios: Vec<Scenario>,
}

/// `[[sim.scenario]]`: the firmware driven over its console in QEMU (unlimited, no pins), passed
/// or failed on what it prints. A `[[requirement.proof]]` with `evidence = "scenario:<name>"`
/// points at its result.
#[derive(Debug, Clone, Deserialize)]
#[serde(deny_unknown_fields)]
pub struct Scenario {
    /// `[a-z0-9_]+`, unique on the board.
    pub name: String,
    /// What it shows, in plain words (the review page's table).
    pub about: String,
    /// Give QEMU its Ethernet (`-nic user,model=open_eth`, the Wi-Fi stand-in).
    #[serde(default)]
    pub nic: bool,
    /// NVS values set over the console after boot (`PROV SET`). Literals only, never secrets:
    /// they are in the repo.
    #[serde(default)]
    pub provision: BTreeMap<String, String>,
    #[serde(rename = "step", default)]
    pub steps: Vec<ScenarioStep>,
}

/// One step of a scenario: exactly one verb.
#[derive(Debug, Clone, Default, Deserialize)]
#[serde(deny_unknown_fields)]
pub struct ScenarioStep {
    /// A console line, as is.
    pub send: Option<String>,
    /// `SIM <this>`, then wait (10 s) for the firmware's `SIM OK <this>` (firmware/components/simcmd).
    pub sim: Option<String>,
    /// A regex for the next console line to wait for (after the last one matched).
    pub wait: Option<String>,
    /// The next `<TAG> {json}` line whose fields equal `fields`.
    pub expect_json: Option<String>,
    pub fields: Option<BTreeMap<String, serde_json::Value>>,
    /// For `wait` and `expect_json`; 30 s if not given.
    pub timeout_ms: Option<u64>,
    /// Let the firmware run this long.
    pub sleep_ms: Option<u64>,
    /// `reboot = true`: kill QEMU and boot again on the same image (a power cycle).
    pub reboot: Option<bool>,
}

impl ScenarioStep {
    /// The verbs set on this step (a valid step has one).
    pub fn verbs(&self) -> Vec<&'static str> {
        [
            ("send", self.send.is_some()),
            ("sim", self.sim.is_some()),
            ("wait", self.wait.is_some()),
            ("expect_json", self.expect_json.is_some()),
            ("sleep_ms", self.sleep_ms.is_some()),
            ("reboot", self.reboot.is_some()),
        ]
        .into_iter()
        .filter_map(|(v, on)| on.then_some(v))
        .collect()
    }
}

/// The longest wait a scenario step may ask for (and the longest sleep).
pub const SCENARIO_MAX_MS: u64 = 300_000;

/// One step of the Wokwi self-test run: wait for a console line, then press a button or check
/// a pin. The run always ends by waiting for `SELFTEST_DONE`.
#[derive(Debug, Deserialize)]
#[serde(deny_unknown_fields)]
pub struct WokwiStep {
    /// Console text to wait for first.
    pub wait: String,
    /// Press the button on this signal (its pin has `sim = "button"`)...
    pub press: Option<String>,
    /// ...for this long (200 ms if not given; 1000 or more is a hold).
    pub hold_ms: Option<u64>,
    /// ...or check this signal's pin (a LED) is at `level`.
    pub expect: Option<String>,
    pub level: Option<u8>,
}

/// The Wokwi part that stands in for a pin in simulation (D-025).
#[derive(Debug, Clone, Copy, PartialEq, Eq, Hash, Deserialize)]
#[serde(rename_all = "snake_case")]
pub enum SimPart {
    /// Pushbutton to GND with a 10k pull-up (active low).
    Button,
    /// LED from the pin through 1k to GND (active high).
    Led,
    /// One cathode of a common-anode RGB LED on 3V3 (active low).
    LedR,
    LedG,
    LedB,
    /// Potentiometer wiper (an analog input such as a battery divider).
    Pot,
}

/// How the board would be ordered (D-021 option A: its own JLCPCB order in a shared parcel).
#[derive(Debug, Deserialize)]
#[serde(deny_unknown_fields)]
pub struct Order {
    /// Bare PCBs made (JLCPCB's smallest batch is 5).
    #[serde(default = "five")]
    pub boards: u64,
    /// Of those, how many JLCPCB assembles (Economic PCBA: 2 to 50).
    #[serde(default = "two")]
    pub assembled: u64,
    /// The owner's budget for this design, USD, before shipping and VAT; None if not set.
    pub budget_usd: Option<f64>,
}

fn five() -> u64 {
    5
}
fn two() -> u64 {
    2
}

impl Default for Order {
    fn default() -> Self {
        Order { boards: 5, assembled: 2, budget_usd: None }
    }
}

#[derive(Debug, Deserialize)]
#[serde(deny_unknown_fields)]
pub struct BoardInfo {
    /// Must equal `Circuit::name`.
    pub name: String,
    /// Must equal `Circuit::rev`.
    pub revision: String,
    /// Reference of the MCU module whose pins the map names ("U1").
    pub module: String,
}

/// One firmware signal on one module pin.
#[derive(Debug, Deserialize)]
#[serde(deny_unknown_fields)]
pub struct PinMap {
    /// Firmware name, upper-case C identifier: the header defines `PIN_<signal>`.
    pub signal: String,
    /// The module symbol's pin name ("IO1", "TXD0", "USB_D+").
    pub pin: String,
    /// The circuit net on that pin, as named in the circuit code (no KiCad "/" prefix).
    pub net: String,
    pub gpio: u32,
    pub dir: Dir,
    #[serde(default)]
    pub active_low: bool,
    #[serde(default)]
    pub note: String,
    /// The Wokwi part standing in for this pin, if any.
    pub sim: Option<SimPart>,
}

#[derive(Debug, Clone, Copy, PartialEq, Eq, Deserialize)]
#[serde(rename_all = "lowercase")]
pub enum Dir {
    In,
    Out,
    Io,
}

impl Dir {
    fn as_str(self) -> &'static str {
        match self {
            Dir::In => "in",
            Dir::Out => "out",
            Dir::Io => "io",
        }
    }
}

/// `[power]`: where the current comes from and what draws it. A board has one or more sources
/// (USB, a battery), each with its own budget; a battery board adds a sleep budget (D-025 C.2).
#[derive(Debug, Deserialize)]
#[serde(deny_unknown_fields)]
pub struct Power {
    #[serde(rename = "source")]
    pub sources: Vec<PowerSource>,
    #[serde(rename = "load", default)]
    pub loads: Vec<Load>,
    /// What stays on while the board sleeps, against the sources' `sleep_ua`.
    #[serde(rename = "sleep_load", default)]
    pub sleep_loads: Vec<SleepLoad>,
}

/// `[[power.source]]`: one way the board is powered.
#[derive(Debug, Deserialize)]
#[serde(deny_unknown_fields)]
pub struct PowerSource {
    /// Short lower-case name the loads' `from` uses: "usb", "battery".
    pub name: String,
    /// In words, for the review page: "USB-C 5 V, no PD".
    pub what: String,
    /// What caps the current; the budget is the smallest (a battery: its regulator and the
    /// cell's peak).
    #[serde(rename = "limit")]
    pub limits: Vec<SupplyLimit>,
    /// The whole board's budget while asleep on this source, µA (None: not a sleeping board).
    pub sleep_ua: Option<f64>,
}

#[derive(Debug, Deserialize)]
#[serde(deny_unknown_fields)]
pub struct SupplyLimit {
    pub name: String,
    pub ma: f64,
    /// Where the number comes from; say INFERRED if it is a guess.
    pub source: String,
}

#[derive(Debug, Deserialize)]
#[serde(deny_unknown_fields)]
pub struct Load {
    pub name: String,
    pub ma: f64,
    /// Where the number comes from; say INFERRED if it is a guess.
    pub source: String,
    /// The sources it draws from (empty: all of them).
    #[serde(default)]
    pub from: Vec<String>,
}

#[derive(Debug, Deserialize)]
#[serde(deny_unknown_fields)]
pub struct SleepLoad {
    pub name: String,
    pub ua: f64,
    /// Where the number comes from; must say INFERRED or VERIFIED.
    pub source: String,
    /// The sources it draws from while asleep (empty: every source with a `sleep_ua`).
    #[serde(default)]
    pub from: Vec<String>,
}

/// One source's budgets and what is drawn from it.
pub struct Tally<'a> {
    pub source: &'a PowerSource,
    /// The smallest limit, and which one it is (None: no limits, an error).
    pub budget_ma: f64,
    pub binding: Option<&'a SupplyLimit>,
    pub loads: Vec<&'a Load>,
    pub ma: f64,
    pub sleep_loads: Vec<&'a SleepLoad>,
    pub sleep_ua: f64,
}

impl Tally<'_> {
    pub fn over(&self) -> bool {
        self.ma > self.budget_ma
    }
    pub fn sleep_over(&self) -> bool {
        self.source.sleep_ua.is_some_and(|b| self.sleep_ua > b)
    }
}

impl Power {
    /// Each source with its loads and totals, in file order.
    pub fn tally(&self) -> Vec<Tally<'_>> {
        self.sources
            .iter()
            .map(|s| {
                let binding = s.limits.iter().min_by(|a, b| a.ma.total_cmp(&b.ma));
                let loads: Vec<&Load> = self.loads.iter().filter(|l| l.from.is_empty() || l.from.contains(&s.name)).collect();
                let sleep_loads: Vec<&SleepLoad> = self
                    .sleep_loads
                    .iter()
                    .filter(|l| if l.from.is_empty() { s.sleep_ua.is_some() } else { l.from.contains(&s.name) })
                    .collect();
                Tally {
                    source: s,
                    budget_ma: binding.map_or(f64::NAN, |l| l.ma),
                    binding,
                    ma: loads.iter().map(|l| l.ma).sum(),
                    sleep_ua: sleep_loads.iter().map(|l| l.ua).sum(),
                    loads,
                    sleep_loads,
                }
            })
            .collect()
    }

    /// One line per source for the gate and the page: "usb 360.9 of 500 mA".
    pub fn summary(&self) -> String {
        let parts: Vec<String> = self
            .tally()
            .iter()
            .map(|t| {
                let mut s = format!("{} {:.1} of {} mA", t.source.name, t.ma, t.budget_ma);
                if let Some(b) = t.source.sleep_ua {
                    s += &format!(", asleep {:.1} of {b} µA", t.sleep_ua);
                }
                s
            })
            .collect();
        parts.join("; ")
    }
}

/// A `[provision]` value: a reference (`"prompt"`, `"file:<path>#<field>"`), or a table with the
/// reference in `from` and the secret's expiry date, so the review page can warn before it
/// lapses. Never the secret itself.
#[derive(Debug, Clone, Deserialize)]
#[serde(untagged)]
pub enum Provision {
    Ref(String),
    Entry(ProvisionEntry),
}

/// The table form of a `[provision]` value. Unknown keys are errors here too: a `value = ...`
/// must never pass silently.
#[derive(Debug, Clone, Deserialize)]
#[serde(deny_unknown_fields)]
pub struct ProvisionEntry {
    pub from: String,
    /// "YYYY-MM-DD": when the secret stops working (a token's expiry).
    pub expires: Option<String>,
}

impl Provision {
    pub fn reference(&self) -> &str {
        match self {
            Provision::Ref(r) => r,
            Provision::Entry(e) => &e.from,
        }
    }
    pub fn expires(&self) -> Option<&str> {
        match self {
            Provision::Entry(e) => e.expires.as_deref(),
            Provision::Ref(_) => None,
        }
    }
}

impl From<String> for Provision {
    fn from(r: String) -> Self {
        Provision::Ref(r)
    }
}

/// Days since 1970-01-01 of a "YYYY-MM-DD" date; None if it isn't a real date.
pub fn day_number(date: &str) -> Option<i64> {
    let b = date.as_bytes();
    if b.len() != 10 || b[4] != b'-' || b[7] != b'-' {
        return None;
    }
    let num = |r: std::ops::Range<usize>| date.get(r).filter(|x| x.bytes().all(|c| c.is_ascii_digit())).and_then(|x| x.parse::<i64>().ok());
    let (y, m, d) = (num(0..4)?, num(5..7)?, num(8..10)?);
    let leap = y % 4 == 0 && (y % 100 != 0 || y % 400 == 0);
    let len = [31, if leap { 29 } else { 28 }, 31, 30, 31, 30, 31, 31, 30, 31, 30, 31];
    if !(1..=12).contains(&m) || d < 1 || d > len[m as usize - 1] {
        return None;
    }
    // days from civil (H. Hinnant's algorithm)
    let y = if m <= 2 { y - 1 } else { y };
    let era = y.div_euclid(400);
    let yoe = y - era * 400;
    let doy = (153 * (if m > 2 { m - 3 } else { m + 9 }) + 2) / 5 + d - 1;
    Some(era * 146097 + yoe * 365 + yoe / 4 - yoe / 100 + doy - 719468)
}

/// Provision keys with an expiry date, and the days left from `today` (negative: expired).
pub fn expiries(bf: &BoardFile, today: &str) -> Vec<(String, String, i64)> {
    let Some(now) = day_number(today) else { return vec![] };
    bf.provision
        .iter()
        .filter_map(|(k, v)| {
            let e = v.expires()?;
            Some((k.clone(), e.to_string(), day_number(e)? - now))
        })
        .collect()
}

#[derive(Debug, Deserialize)]
#[serde(deny_unknown_fields)]
pub struct Requirement {
    /// "R1", "R2", ...: the same IDs as in `spec.md`.
    pub id: String,
    pub text: String,
    /// What shows the requirement is met: `part:<ref>`, `pin:<signal>`, `test:<self-test>`
    /// or `gate:<gate>` (one of `GATES`).
    pub covered_by: Vec<String>,
    /// How it was proven before the order (`[[requirement.proof]]`). `covered_by` says what in
    /// the design is responsible; a proof says what showed that it works. None is not a gate
    /// failure: the readiness page shows the requirement red, and red blocks freeze.
    #[serde(rename = "proof", default)]
    pub proofs: Vec<Proof>,
}

/// `[[requirement.proof]]`: one thing that showed a requirement is met.
#[derive(Debug, Clone, Deserialize)]
#[serde(deny_unknown_fields)]
pub struct Proof {
    pub how: How,
    /// The scenario, datasheet table, measurement or gate that shows it, in plain words (free
    /// text, not parsed). For `unprovable`: why, and what covers it at bring-up.
    pub evidence: String,
}

#[derive(Debug, Clone, Copy, PartialEq, Eq, Deserialize)]
#[serde(rename_all = "lowercase")]
pub enum How {
    /// The firmware did it in QEMU or Wokwi.
    Simulated,
    /// Checked against the part's datasheet by the independent checker.
    Datasheet,
    /// Measured on a dev board with plug-in parts.
    Devboard,
    /// One of the pipeline's gates (ERC, DRC, the case's fit check, ...).
    Gate,
    /// Only the delivered board can show it (radio range, how the microphone sounds).
    Unprovable,
}

/// `[[risk]]`: one open guess or unchecked fact, and what being wrong about it would cost. The
/// readiness page sorts them by `fix`; one that would need a new board blocks freeze until the
/// owner accepts it by name.
#[derive(Debug, Clone, Deserialize)]
#[serde(deny_unknown_fields)]
pub struct Risk {
    /// The open item, in plain words.
    pub what: String,
    pub tag: Tag,
    /// What fixing a miss would need.
    pub fix: Fix,
    /// What a miss would cost the owner, in plain words.
    pub miss: String,
    /// How and when it gets settled.
    pub check: Option<String>,
    /// The owner's words accepting it by name; never written by Claude on the owner's behalf.
    pub accepted: Option<String>,
}

#[derive(Debug, Clone, Copy, PartialEq, Eq, Deserialize)]
#[serde(rename_all = "UPPERCASE")]
pub enum Tag {
    /// Read from a source, but not checked against it independently.
    Unverified,
    /// Reasoned or estimated; no source says it.
    Inferred,
}

#[derive(Debug, Clone, Copy, PartialEq, Eq, Deserialize)]
#[serde(rename_all = "snake_case")]
pub enum Fix {
    /// Free: an update over USB or Wi-Fi.
    Firmware,
    /// A soldering iron on the delivered board (a cut track, a swapped part).
    Rework,
    /// A second order and a second shipment.
    NewBoard,
}

#[derive(Debug, Default, Deserialize)]
#[serde(deny_unknown_fields)]
pub struct Firmware {
    /// Self-tests the firmware runs at bring-up (lower-case identifiers).
    #[serde(default)]
    pub self_test: Vec<String>,
}

/// The board's `board.toml`, or None if it has none (boards from before D-023).
pub fn load(dir: &Path) -> Result<Option<BoardFile>> {
    let path = dir.join(FILE);
    if !path.exists() {
        return Ok(None);
    }
    let text = std::fs::read_to_string(&path).with_context(|| format!("reading {}", path.display()))?;
    parse(&text).with_context(|| format!("in {}", path.display())).map(Some)
}

pub fn parse(text: &str) -> Result<BoardFile> {
    Ok(toml::from_str(text)?)
}

/// A module pcbgen has a GPIO table for: which symbols it is, and how their pin names map
/// to GPIO numbers.
struct Module {
    /// The symbol's lib id starts with this. `MODULES` is searched in order, so a longer
    /// prefix goes before a shorter one it extends.
    lib_id_prefix: &'static str,
    /// Pins whose name doesn't say their GPIO number.
    special: &'static [(&'static str, u32)],
    /// Other pins named `<io_prefix><n>` are GPIO n; the rest (EN, 3V3, GND) are not GPIOs.
    io_prefix: &'static str,
}

/// ESP32-S3-WROOM-1 and -1U: `IOnn` is GPIOnn; TXD0/RXD0 are GPIO43/44 (Espressif
/// WROOM-1/WROOM-1U datasheet v1.8, Table 3-1; one document for both); USB_D-/USB_D+ are
/// GPIO19/20 (the KiCad symbol's alternate names IO19/IO20).
const WROOM1_SPECIAL: &[(&str, u32)] = &[("TXD0", 43), ("RXD0", 44), ("USB_D-", 19), ("USB_D+", 20)];

const MODULES: &[Module] = &[
    // KiCad 10 ships a -1U footprint but no -1U symbol, so a -1U board uses the WROOM-1
    // symbol (its footprint filter takes both) and the next entry; this one is for a
    // library that names the symbol -1U.
    Module { lib_id_prefix: "RF_Module:ESP32-S3-WROOM-1U", special: WROOM1_SPECIAL, io_prefix: "IO" },
    Module { lib_id_prefix: "RF_Module:ESP32-S3-WROOM-1", special: WROOM1_SPECIAL, io_prefix: "IO" },
];

fn module_of(lib_id: &str) -> Option<&'static Module> {
    MODULES.iter().find(|m| lib_id.starts_with(m.lib_id_prefix))
}

/// The GPIO number behind a module pin name, for the modules in `MODULES`.
fn gpio_of(lib_id: &str, pin: &str) -> Option<u32> {
    let m = module_of(lib_id)?;
    if let Some(&(_, g)) = m.special.iter().find(|(name, _)| *name == pin) {
        return Some(g);
    }
    pin.strip_prefix(m.io_prefix).filter(|n| !n.is_empty() && n.bytes().all(|b| b.is_ascii_digit())).and_then(|n| n.parse().ok())
}

fn knows(lib_id: &str) -> bool {
    module_of(lib_id).is_some()
}

/// Problems between `board.toml`, the circuit and the spec's requirement IDs
/// (None: the board has no `spec.md`). Empty means the gate passes.
pub fn problems(bf: &BoardFile, c: &Circuit, spec_ids: Option<&BTreeSet<String>>) -> Vec<String> {
    let mut p = vec![];
    let b = &bf.board;
    if b.name != c.name {
        p.push(format!("board.name {:?} is not the circuit's name {:?}", b.name, c.name));
    }
    if b.revision != c.rev {
        p.push(format!("board.revision {:?} is not the circuit's revision {:?}", b.revision, c.rev));
    }

    // --- pin map --------------------------------------------------------------
    let module = c.find_part(&b.module).map(|id| (id.0, &c.parts[id.0]));
    match module {
        None => p.push(format!("board.module {:?} is not a part in the circuit", b.module)),
        Some((_, m)) if !knows(&m.lib_id) => {
            p.push(format!("module {} ({}) has no GPIO table in pcbgen's boardfile.rs; add one", m.reference, m.lib_id))
        }
        _ => {}
    }
    let ident = Regex::new(r"^[A-Z][A-Z0-9_]*$").unwrap();
    let (mut signals, mut gpios, mut pads) = (HashSet::new(), HashSet::new(), HashSet::new());
    for m in &bf.pins {
        let at = format!("pin {}", m.signal);
        if !ident.is_match(&m.signal) {
            p.push(format!("{at}: signal must be an upper-case C identifier (A-Z, 0-9, _)"));
        }
        if !signals.insert(m.signal.as_str()) {
            p.push(format!("{at}: signal listed twice"));
        }
        if !gpios.insert(m.gpio) {
            p.push(format!("{at}: GPIO {} used by another signal", m.gpio));
        }
        if !pads.insert(m.pin.as_str()) {
            p.push(format!("{at}: module pin {} used by another signal", m.pin));
        }
        let Some((mi, part)) = module.filter(|(_, part)| knows(&part.lib_id)) else { continue };
        let Some(pin) = part.symbol.pins.iter().find(|x| x.name == m.pin) else {
            p.push(format!("{at}: {} ({}) has no pin named {:?}", part.reference, part.lib_id, m.pin));
            continue;
        };
        match gpio_of(&part.lib_id, &m.pin) {
            Some(g) if g != m.gpio => p.push(format!("{at}: {} is GPIO {g}, not {}", m.pin, m.gpio)),
            None => p.push(format!("{at}: {} is not a GPIO", m.pin)),
            _ => {}
        }
        match c.net_of(mi, pin) {
            Some(n) if n.name == m.net => {}
            Some(n) => p.push(format!("{at}: {} is on net {}, not {}", m.pin, n.name, m.net)),
            None => p.push(format!("{at}: {} is on no net (net {} expected)", m.pin, m.net)),
        }
    }
    // the other way round: every GPIO the circuit uses must be in the map
    if let Some((mi, part)) = module.filter(|(_, part)| knows(&part.lib_id)) {
        let mapped: HashSet<&str> = bf.pins.iter().map(|m| m.pin.as_str()).collect();
        let mut seen = HashSet::new();
        for pin in &part.symbol.pins {
            if gpio_of(&part.lib_id, &pin.name).is_none() || mapped.contains(pin.name.as_str()) || !seen.insert(&pin.name) {
                continue;
            }
            if let Some(n) = c.net_of(mi, pin) {
                p.push(format!("{}.{} ({}) is on net {} but not in the pin map", part.reference, pin.number, pin.name, n.name));
            }
        }
    }

    // --- power ----------------------------------------------------------------
    p.extend(power_problems(&bf.power));

    // --- order ------------------------------------------------------------------
    let o = &bf.order;
    if !(2..=50).contains(&o.assembled) || o.assembled > o.boards {
        p.push(format!("order: {} assembled of {} boards; JLCPCB Economic assembles 2 to 50, at most the boards made", o.assembled, o.boards));
    }
    if o.budget_usd.is_some_and(|b| !(b.is_finite() && b > 0.0)) {
        p.push("order.budget_usd must be more than 0".into());
    }

    // --- firmware self-tests ---------------------------------------------------
    let test_ident = Regex::new(r"^[a-z][a-z0-9_]*$").unwrap();
    let mut tests = HashSet::new();
    for t in &bf.firmware.self_test {
        if !test_ident.is_match(t) {
            p.push(format!("firmware.self_test {t:?}: must be a lower-case identifier (a-z, 0-9, _)"));
        }
        if !tests.insert(t.as_str()) {
            p.push(format!("firmware.self_test {t:?} listed twice"));
        }
    }

    // --- requirements ------------------------------------------------------------
    let rid = Regex::new(r"^R[1-9][0-9]*$").unwrap();
    let mut ids = BTreeSet::new();
    for r in &bf.requirements {
        let at = format!("requirement {}", r.id);
        if !rid.is_match(&r.id) {
            p.push(format!("{at}: id must look like R1, R2, ..."));
        }
        if !ids.insert(r.id.clone()) {
            p.push(format!("{at}: id listed twice"));
        }
        if r.text.trim().is_empty() {
            p.push(format!("{at}: text is empty"));
        }
        if r.covered_by.is_empty() {
            p.push(format!("{at}: nothing covers it (covered_by is empty)"));
        }
        for cov in &r.covered_by {
            let ok = match cov.split_once(':') {
                Some(("part", x)) => c.find_part(x).is_some(),
                Some(("pin", x)) => signals.contains(x),
                Some(("test", x)) => tests.contains(x),
                Some(("gate", x)) => GATES.contains(&x),
                Some(("power", x)) => bf.power.sources.iter().any(|s| s.name == x),
                Some(("sleep", x)) => bf.power.sources.iter().any(|s| s.name == x && s.sleep_ua.is_some()),
                _ => {
                    p.push(format!("{at}: {cov:?} must start with part:, pin:, test:, gate:, power: or sleep:"));
                    continue;
                }
            };
            if !ok {
                let what = match cov.split_once(':').unwrap().0 {
                    "part" => "no such part in the circuit".to_string(),
                    "pin" => "no such signal in the pin map".to_string(),
                    "test" => "not in firmware.self_test".to_string(),
                    "power" => "no such [[power.source]]".to_string(),
                    "sleep" => "no [[power.source]] of that name with a sleep_ua".to_string(),
                    _ => format!("gates are {}", GATES.join(", ")),
                };
                p.push(format!("{at}: {cov:?}: {what}"));
            }
        }
    }
    // --- readiness: proofs and open risks (empty words would show as blanks on the page) ----
    for r in &bf.requirements {
        for (n, proof) in r.proofs.iter().enumerate() {
            if proof.evidence.trim().is_empty() {
                p.push(format!("requirement {}: proof {}: evidence is empty", r.id, n + 1));
            }
        }
    }
    for (n, r) in bf.risks.iter().enumerate() {
        let blank = |s: &str| s.trim().is_empty();
        for (key, empty) in [("what", blank(&r.what)), ("miss", blank(&r.miss)), ("accepted", r.accepted.as_deref().is_some_and(blank))] {
            if empty {
                p.push(format!("risk {}: {key} is empty", n + 1));
            }
        }
    }
    for t in &bf.firmware.self_test {
        if !bf.requirements.iter().any(|r| r.covered_by.iter().any(|c| c == &format!("test:{t}"))) {
            p.push(format!("firmware.self_test {t:?} covers no requirement"));
        }
    }
    p.extend(sim_problems(bf));
    if let Some(case) = &bf.case {
        p.extend(case_problems(case, c));
    }
    let key = Regex::new(r"^[a-z0-9_]{1,15}$").unwrap();
    for (k, entry) in &bf.provision {
        if !key.is_match(k) {
            p.push(format!("provision key {k:?}: NVS keys are [a-z0-9_], at most 15 characters"));
        }
        if let Some(e) = entry.expires().filter(|e| day_number(e).is_none()) {
            p.push(format!("provision {k}: expires {e:?} must be a date, YYYY-MM-DD"));
        }
        let v = entry.reference();
        let ok = v == "prompt" || v.strip_prefix("file:").and_then(|f| f.split_once('#')).is_some_and(|(f, field)| !f.is_empty() && !field.is_empty());
        if !ok {
            p.push(format!("provision {k}: {v:?} must be \"prompt\" or \"file:<path>#<field>\""));
        }
    }
    match spec_ids {
        None => p.push("the board has no spec.md (copy templates/spec.md)".into()),
        Some(spec) => {
            for id in spec.difference(&ids) {
                p.push(format!("spec.md requirement {id} is not in board.toml"));
            }
            for id in ids.difference(spec) {
                p.push(format!("board.toml requirement {id} is not in spec.md"));
            }
        }
    }
    p
}

/// `[power]`: names, numbers, and every source's loads under its budgets.
fn power_problems(pw: &Power) -> Vec<String> {
    let mut p = vec![];
    if pw.sources.is_empty() {
        p.push("power: no [[power.source]]".into());
    }
    let ident = Regex::new(r"^[a-z][a-z0-9_]*$").unwrap();
    let mut names = HashSet::new();
    for s in &pw.sources {
        let at = format!("power.source {:?}", s.name);
        if !ident.is_match(&s.name) {
            p.push(format!("{at}: name must be a lower-case identifier (a-z, 0-9, _)"));
        }
        if !names.insert(s.name.as_str()) {
            p.push(format!("{at}: listed twice"));
        }
        if s.limits.is_empty() {
            p.push(format!("{at}: no [[power.source.limit]], so no budget"));
        }
        for l in &s.limits {
            if !(l.ma.is_finite() && l.ma > 0.0) {
                p.push(format!("{at} limit {:?}: ma must be more than 0", l.name));
            }
        }
        if s.sleep_ua.is_some_and(|b| !(b.is_finite() && b > 0.0)) {
            p.push(format!("{at}: sleep_ua must be more than 0"));
        }
    }
    let known = |from: &[String], what: &str, p: &mut Vec<String>| {
        for f in from.iter().filter(|f| !names.contains(f.as_str())) {
            p.push(format!("{what}: from {f:?}: no such [[power.source]]"));
        }
    };
    for l in &pw.loads {
        let at = format!("power.load {:?}", l.name);
        if !(l.ma.is_finite() && l.ma >= 0.0) {
            p.push(format!("{at}: ma must be 0 or more"));
        }
        known(&l.from, &at, &mut p);
    }
    let sleepers = pw.sources.iter().filter(|s| s.sleep_ua.is_some()).count();
    for l in &pw.sleep_loads {
        let at = format!("power.sleep_load {:?}", l.name);
        if !(l.ua.is_finite() && l.ua >= 0.0) {
            p.push(format!("{at}: ua must be 0 or more"));
        }
        if !(l.source.contains("INFERRED") || l.source.contains("VERIFIED")) {
            p.push(format!("{at}: source must say INFERRED or VERIFIED"));
        }
        known(&l.from, &at, &mut p);
        for f in &l.from {
            if pw.sources.iter().any(|s| &s.name == f && s.sleep_ua.is_none()) {
                p.push(format!("{at}: source {f:?} has no sleep_ua budget"));
            }
        }
        if l.from.is_empty() && sleepers == 0 {
            p.push(format!("{at}: no [[power.source]] has a sleep_ua budget"));
        }
    }
    for t in pw.tally() {
        let name = &t.source.name;
        if let Some(l) = t.binding.filter(|l| l.ma.is_finite() && l.ma > 0.0 && t.over()) {
            p.push(format!("power {name}: loads total {} mA, over the {} mA budget ({})", t.ma, t.budget_ma, l.name));
        }
        if let Some(b) = t.source.sleep_ua.filter(|b| b.is_finite() && *b > 0.0) {
            if t.sleep_loads.is_empty() {
                p.push(format!("power {name}: sleep_ua is set but no [[power.sleep_load]] draws from it"));
            } else if t.sleep_over() {
                p.push(format!("power {name}: asleep {} µA, over the {b} µA sleep budget", t.sleep_ua));
            }
        }
    }
    p
}

fn sim_problems(bf: &BoardFile) -> Vec<String> {
    let mut p = vec![];
    let mut seen = HashSet::new();
    for pin in &bf.pins {
        let Some(part) = pin.sim else { continue };
        let at = format!("pin {} sim {part:?}", pin.signal);
        let want_in = matches!(part, SimPart::Button | SimPart::Pot);
        if want_in && pin.dir == Dir::Out || !want_in && pin.dir == Dir::In {
            p.push(format!("{at}: doesn't fit dir {:?}", pin.dir.as_str()));
        }
        if matches!(part, SimPart::LedR | SimPart::LedG | SimPart::LedB) && !seen.insert(part) {
            p.push(format!("{at}: the RGB LED has one {part:?}"));
        }
        if matches!(pin.gpio, 19 | 20 | 43 | 44) {
            p.push(format!("{at}: GPIO {} is USB or the UART console", pin.gpio));
        }
    }
    let part_of = |sig: &str| bf.pins.iter().find(|x| x.signal == sig).and_then(|x| x.sim);
    for (i, st) in bf.sim.wokwi_steps.iter().enumerate() {
        let at = format!("sim.wokwi_step {}", i + 1);
        if st.wait.trim().is_empty() {
            p.push(format!("{at}: wait is empty"));
        }
        match (&st.press, &st.expect) {
            (Some(sig), None) => {
                if part_of(sig) != Some(SimPart::Button) {
                    p.push(format!("{at}: press {sig:?} needs a pin with sim = \"button\""));
                }
                if st.level.is_some() {
                    p.push(format!("{at}: level goes with expect, not press"));
                }
            }
            (None, Some(sig)) => {
                if !matches!(part_of(sig), Some(SimPart::Led | SimPart::LedR | SimPart::LedG | SimPart::LedB)) {
                    p.push(format!("{at}: expect {sig:?} needs a pin with a LED sim part"));
                }
                if !matches!(st.level, Some(0 | 1)) {
                    p.push(format!("{at}: expect needs level = 0 or 1"));
                }
                if st.hold_ms.is_some() {
                    p.push(format!("{at}: hold_ms goes with press, not expect"));
                }
            }
            _ => p.push(format!("{at}: needs exactly one of press or expect")),
        }
    }
    p.extend(scenario_problems(bf));
    p
}

fn scenario_problems(bf: &BoardFile) -> Vec<String> {
    let mut p = vec![];
    let name_re = Regex::new(r"^[a-z0-9_]+$").unwrap();
    let key_re = Regex::new(r"^[a-z0-9_]{1,15}$").unwrap();
    let tag_re = Regex::new(r"^[A-Z][A-Z0-9_]*$").unwrap();
    let mut names = HashSet::new();
    for (i, sc) in bf.sim.scenarios.iter().enumerate() {
        let at = format!("sim.scenario {} ({:?})", i + 1, sc.name);
        if !name_re.is_match(&sc.name) {
            p.push(format!("{at}: name must be [a-z0-9_]+"));
        }
        if !names.insert(sc.name.as_str()) {
            p.push(format!("{at}: a second scenario with this name"));
        }
        if sc.about.trim().is_empty() {
            p.push(format!("{at}: about is empty"));
        }
        if sc.steps.is_empty() {
            p.push(format!("{at}: no steps"));
        }
        for (k, v) in &sc.provision {
            if !key_re.is_match(k) {
                p.push(format!("{at}: provision key {k:?} must be [a-z0-9_], at most 15 characters"));
            }
            // [provision]'s reference forms would be sent as literal text: say so instead
            if v.starts_with("file:") || v == "prompt" {
                p.push(format!("{at}: provision {k} must be a literal value (never a secret or a reference)"));
            }
            if v.len() > 512 {
                p.push(format!("{at}: provision {k} is over 512 bytes"));
            }
        }
        for (j, st) in sc.steps.iter().enumerate() {
            let at = format!("{at} step {}", j + 1);
            let verbs = st.verbs();
            if verbs.len() != 1 {
                p.push(format!("{at}: needs exactly one of send, sim, wait, expect_json, sleep_ms, reboot (has {verbs:?})"));
                continue;
            }
            let one_line = |what: &str, s: &str, p: &mut Vec<String>| {
                if s.trim().is_empty() || s.contains(['\n', '\r']) {
                    p.push(format!("{at}: {what} must be one non-empty line"));
                }
            };
            match verbs[0] {
                "send" => one_line("send", st.send.as_deref().unwrap_or(""), &mut p),
                "sim" => {
                    let s = st.sim.as_deref().unwrap_or("");
                    one_line("sim", s, &mut p);
                    if s.trim_start().starts_with("SIM ") {
                        p.push(format!("{at}: sim is what follows `SIM ` (e.g. \"PRESS 300\")"));
                    }
                }
                "wait" => {
                    if let Err(e) = Regex::new(st.wait.as_deref().unwrap_or("")) {
                        p.push(format!("{at}: wait is not a regex: {e}"));
                    }
                }
                "expect_json" => {
                    if !tag_re.is_match(st.expect_json.as_deref().unwrap_or("")) {
                        p.push(format!("{at}: expect_json is the line's tag, [A-Z][A-Z0-9_]* (e.g. \"SELFTEST\")"));
                    }
                    if st.fields.as_ref().is_none_or(BTreeMap::is_empty) {
                        p.push(format!("{at}: expect_json needs fields = {{ ... }}"));
                    }
                }
                "sleep_ms" => {
                    if !(1..=SCENARIO_MAX_MS).contains(&st.sleep_ms.unwrap_or(0)) {
                        p.push(format!("{at}: sleep_ms must be 1..={SCENARIO_MAX_MS}"));
                    }
                }
                _ => {
                    if st.reboot != Some(true) {
                        p.push(format!("{at}: reboot takes only true"));
                    }
                }
            }
            if st.fields.is_some() && verbs[0] != "expect_json" {
                p.push(format!("{at}: fields goes with expect_json"));
            }
            if let Some(t) = st.timeout_ms {
                if !matches!(verbs[0], "wait" | "expect_json") {
                    p.push(format!("{at}: timeout_ms goes with wait or expect_json"));
                } else if !(1..=SCENARIO_MAX_MS).contains(&t) {
                    p.push(format!("{at}: timeout_ms must be 1..={SCENARIO_MAX_MS}"));
                }
            }
        }
    }
    // a proof that names a scenario is a simulation
    for q in &bf.requirements {
        for pr in &q.proofs {
            if pr.evidence.trim().starts_with("scenario:") && pr.how != How::Simulated {
                p.push(format!("requirement {} proof {:?}: a scenario proof needs how = \"simulated\"", q.id, pr.evidence.trim()));
            }
        }
    }
    p
}

/// `[case]` against the material's printing limits and the circuit's parts. What only the 3D
/// shapes can show (clearances, alignment) is the `case` stage's fit gate.
fn case_problems(case: &Case, c: &Circuit) -> Vec<String> {
    let mut p = vec![];
    let lim = case.material.limits();
    let m = match case.material {
        Material::Resin => "resin",
        Material::Nylon => "nylon",
    };
    let num = |v: f64| v.is_finite() && v >= 0.0;
    for (key, v, min) in [
        ("wall", case.wall, lim.wall_min),
        ("floor", case.floor, lim.wall_min),
        ("edge_gap", case.edge_gap, lim.static_fit),
        ("min_clearance", case.min_clearance, 0.0),
        ("top_gap", case.top_gap, case.min_clearance),
        ("bottom_gap", case.bottom_gap, case.min_clearance),
    ] {
        if !num(v) || v < min {
            p.push(format!("case.{key} = {v} mm is under the minimum {min} mm ({m})"));
        }
    }
    if let Some(b) = &case.battery {
        if b.size.iter().any(|v| !(v.is_finite() && *v > 0.0)) {
            p.push("case.battery: size must be three lengths over 0 (length, width, thickness)".into());
        }
        if !num(b.swell()) {
            p.push("case.battery: swell must be 0 or more".into());
        }
        if !num(b.pad) || b.pad < lim.static_fit {
            p.push(format!("case.battery: pad {} mm is under the static fit {} mm ({m})", b.pad, lim.static_fit));
        }
        if b.at.is_some_and(|a| a.iter().any(|v| !v.is_finite())) {
            p.push("case.battery: at must be two numbers".into());
        }
        let need = b.needs(case.min_clearance);
        if case.bottom_gap < need {
            p.push(format!(
                "case.battery: bottom_gap {} mm has no room for the cell ({} thick + {:.2} swell + {} clearance = {need:.2} mm)",
                case.bottom_gap,
                b.size[2],
                b.swell(),
                case.min_clearance
            ));
        }
        if let Some(l) = &b.lead
            && c.find_part(l).is_none()
        {
            p.push(format!("case.battery: lead {l}: no such part in the circuit"));
        }
    }
    let mut seen = HashSet::new();
    for o in &case.openings {
        let at = format!("case.opening {}", o.reference);
        if c.find_part(&o.reference).is_none() {
            p.push(format!("{at}: no such part in the circuit"));
        }
        if !seen.insert(o.reference.as_str()) {
            p.push(format!("{at}: listed twice"));
        }
        let allowed = Opening::keys(o.kind);
        for k in o.given() {
            if !allowed.contains(&k) {
                p.push(format!("{at}: {k} is not used by a {} opening (it takes {})", o.kind.as_str(), allowed.join(", ")));
            }
        }
        let r = o.resolved();
        if o.kind == OpeningKind::Connector && r.height.is_none() {
            p.push(format!("{at}: a connector needs height (its mouth's height above the PCB, from the datasheet)"));
        }
        for (k, v) in [("margin", r.margin), ("height", r.height), ("diameter", r.diameter), ("travel", r.travel), ("slot_width", r.slot_width), ("slot_length", r.slot_length)] {
            if v.is_some_and(|v| !(v.is_finite() && v > 0.0)) {
                p.push(format!("{at}: {k} must be more than 0"));
            }
        }
        if r.margin.is_some_and(|v| v < lim.static_fit) {
            p.push(format!("{at}: margin {} mm is under the static fit {} mm ({m})", r.margin.unwrap(), lim.static_fit));
        }
        if r.slots == Some(0) {
            p.push(format!("{at}: slots must be at least 1"));
        }
        // holes through the case: the pinhole, a LED hole, the vent slots
        let hole = match (o.kind, r.style) {
            (OpeningKind::Pinhole, _) | (OpeningKind::Led, Some(LedStyle::Hole)) => r.diameter,
            (OpeningKind::Vent, _) => r.slot_width,
            _ => None,
        };
        if let Some(h) = hole.filter(|&h| h < lim.hole_min) {
            p.push(format!("{at}: a {h} mm hole is under the smallest printable hole {} mm ({m})", lim.hole_min));
        }
    }
    p
}

/// Requirement IDs in a `spec.md`: list items starting with a bold ID, `- **R1** ...`.
pub fn spec_ids(spec: &str) -> BTreeSet<String> {
    let re = Regex::new(r"(?m)^\s*[-*]\s+\*\*(R[0-9]+)\*\*").unwrap();
    re.captures_iter(spec).map(|m| m[1].to_string()).collect()
}

/// The `BOARD.TOML` gate: prints each power source's total and every problem.
/// `dir` is the board's directory (for its `spec.md`).
pub fn gate(bf: &BoardFile, c: &Circuit, dir: &Path) -> Result<bool> {
    let spec = dir.join("spec.md");
    let ids = if spec.exists() { Some(spec_ids(&std::fs::read_to_string(&spec)?)) } else { None };
    println!(
        "== BOARD.TOML: {} pins, {} requirements, {} self-tests; power {}",
        bf.pins.len(),
        bf.requirements.len(),
        bf.firmware.self_test.len(),
        bf.power.summary()
    );
    let p = problems(bf, c, ids.as_ref());
    for line in &p {
        println!("   OPEN:   {line}");
    }
    println!("== BOARD.TOML: {}", if p.is_empty() { "PASS" } else { "FAIL" });
    Ok(p.is_empty())
}

/// The firmware's `board_pins.h` (ESP-IDF). Deterministic: the same file gives the same text.
pub fn header(bf: &BoardFile) -> String {
    let one_line = |s: &str| s.split_whitespace().collect::<Vec<_>>().join(" ");
    let mut h = String::new();
    h += "// Generated by pcbgen from board.toml; do not edit. Regenerate with the `fw` stage.\n";
    h += "#pragma once\n\n#include \"driver/gpio.h\"\n\n";
    h += &format!("#define BOARD_NAME \"{}\"\n#define BOARD_REVISION \"{}\"\n", bf.board.name, bf.board.revision);
    for m in &bf.pins {
        let mut c = format!("{}: module pin {}, net {}, {}", m.signal, m.pin, m.net, m.dir.as_str());
        if m.active_low {
            c += ", active low";
        }
        if !m.note.is_empty() {
            c += &format!("; {}", one_line(&m.note));
        }
        h += &format!("\n// {c}\n#define PIN_{} GPIO_NUM_{}\n", m.signal, m.gpio);
        if m.active_low {
            h += &format!("#define PIN_{}_ACTIVE_LOW 1\n", m.signal);
        }
    }
    let tests: Vec<String> = bf.firmware.self_test.iter().map(|t| format!("\"{t}\"")).collect();
    h += "\n// Self-tests the firmware runs at bring-up: static const char *t[] = BOARD_SELF_TESTS;\n";
    h += &format!("#define BOARD_SELF_TEST_COUNT {}\n#define BOARD_SELF_TESTS {{{}}}\n", tests.len(), tests.join(", "));
    h
}

#[cfg(test)]
mod tests {
    use super::*;

    const SAMPLE: &str = r#"
[board]
name = "t"
revision = "A"
module = "U1"

[[pin]]
signal = "I2C_SDA"
pin = "IO1"
net = "SDA"
gpio = 1
dir = "io"

[[pin]]
signal = "BOOT"
pin = "IO0"
net = "BOOT"
gpio = 0
dir = "in"
active_low = true
note = "strapping pin"

[[pin]]
signal = "USB_DP"
pin = "USB_D+"
net = "DP"
gpio = 20
dir = "io"

[[power.source]]
name = "usb"
what = "USB"

[[power.source.limit]]
name = "USB 2.0"
ma = 500
source = "spec"

[[power.load]]
name = "module"
ma = 355
source = "datasheet"

[[requirement]]
id = "R1"
text = "Reads the sensor"
covered_by = ["part:R1", "pin:I2C_SDA", "test:sensor", "gate:drc"]

[firmware]
self_test = ["sensor"]
"#;

    /// ESP32-S3 module on SDA/BOOT/DP, plus a resistor so SDA has two pins.
    fn circuit() -> Circuit {
        let mut c = Circuit::new("t", "test", "A");
        let (sda, boot, dp, gnd) = (c.net("SDA"), c.net("BOOT"), c.net("DP"), c.net("GND"));
        let u1 = c.part("U1", "RF_Module:ESP32-S3-WROOM-1", "m", "fp").id();
        c.connect(sda, u1, &["IO1"]);
        c.connect(boot, u1, &["IO0"]);
        c.connect(dp, u1, &["USB_D+"]);
        c.connect(gnd, u1, &["GND"]);
        let r1 = c.part("R1", "Device:R", "1k", "fp").id();
        c.connect(sda, r1, &["1"]);
        c.connect(gnd, r1, &["2"]);
        c
    }

    fn ids(v: &[&str]) -> BTreeSet<String> {
        v.iter().map(|s| s.to_string()).collect()
    }

    fn run(toml: &str, c: &Circuit) -> Vec<String> {
        problems(&parse(toml).unwrap(), c, Some(&ids(&["R1"])))
    }

    /// The single problem a one-line change to SAMPLE causes, checked by substring.
    fn one(from: &str, to: &str, want: &str) {
        assert!(SAMPLE.contains(from), "{from:?} not in SAMPLE");
        let p = run(&SAMPLE.replacen(from, to, 1), &circuit());
        assert!(p.len() == 1 && p[0].contains(want), "{from:?} -> {to:?}: want {want:?}, got {p:?}");
    }

    #[test]
    fn sample_parses_and_passes() {
        let bf = parse(SAMPLE).unwrap();
        assert_eq!(bf.pins.len(), 3);
        assert_eq!(bf.pins[1].dir, Dir::In);
        assert!(bf.pins[1].active_low && !bf.pins[0].active_low);
        assert_eq!(bf.power.loads[0].ma, 355.0);
        assert_eq!(run(SAMPLE, &circuit()), Vec::<String>::new());
    }

    #[test]
    fn sim_parts_and_wokwi_steps() {
        let button = "active_low = true\nsim = \"button\"\n";
        let steps = "[[sim.wokwi_step]]\nwait = \"SELFTEST_PRESS\"\npress = \"BOOT\"\nhold_ms = 1200\n";
        let ok = SAMPLE.replacen("active_low = true\n", button, 1) + steps;
        assert_eq!(run(&ok, &circuit()), Vec::<String>::new());
        let bf = parse(&ok).unwrap();
        assert_eq!(bf.pins[1].sim, Some(SimPart::Button));
        assert_eq!(bf.sim.wokwi_steps[0].hold_ms, Some(1200));
        assert!(parse(&SAMPLE.replacen("active_low = true\n", "sim = \"buzzer\"\n", 1)).is_err());

        let bad = |from: &str, to: &str, want: &str| {
            let p = run(&ok.replacen(from, to, 1), &circuit());
            assert!(p.iter().any(|x| x.contains(want)), "{from:?} -> {to:?}: want {want:?}, got {p:?}");
        };
        bad("sim = \"button\"", "sim = \"led\"", "doesn't fit dir");
        bad("press = \"BOOT\"", "press = \"I2C_SDA\"", "needs a pin with sim = \"button\"");
        bad("press = \"BOOT\"\nhold_ms = 1200", "expect = \"BOOT\"\nlevel = 1", "needs a pin with a LED sim part");
        bad("press = \"BOOT\"", "press = \"BOOT\"\nexpect = \"BOOT\"", "exactly one of press or expect");
        bad("wait = \"SELFTEST_PRESS\"", "wait = \" \"", "wait is empty");
        // a sim part on the USB pin
        bad("gpio = 20\ndir = \"io\"", "gpio = 20\ndir = \"io\"\nsim = \"led\"", "USB or the UART console");
    }

    const SCENARIO: &str = r#"
[[sim.scenario]]
name = "press"
about = "A press is seen"
nic = true
provision = { sim_note = "kept" }
[[sim.scenario.step]]
wait = "^PROV READY"
timeout_ms = 60000
[[sim.scenario.step]]
sim = "PRESS 300"
[[sim.scenario.step]]
expect_json = "BUTTON"
fields = { kind = "short", n = 1 }
[[sim.scenario.step]]
send = "SELFTEST"
[[sim.scenario.step]]
sleep_ms = 500
[[sim.scenario.step]]
reboot = true
"#;

    #[test]
    fn sim_scenarios() {
        let ok = format!("{SAMPLE}{SCENARIO}");
        assert_eq!(run(&ok, &circuit()), Vec::<String>::new());
        let bf = parse(&ok).unwrap();
        let sc = &bf.sim.scenarios[0];
        assert!(sc.nic && sc.provision["sim_note"] == "kept" && sc.steps.len() == 6);
        assert_eq!(sc.steps[2].fields.as_ref().unwrap()["n"], serde_json::json!(1));
        assert_eq!(sc.steps[5].verbs(), ["reboot"]);
        // unknown keys and verbs are errors
        assert!(parse(&ok.replace("sleep_ms = 500", "sleep = 500")).is_err());
        assert!(parse(&ok.replace("nic = true", "net = true")).is_err());

        let bad = |from: &str, to: &str, want: &str| {
            assert!(ok.contains(from), "{from:?} not in the sample");
            let p = run(&ok.replacen(from, to, 1), &circuit());
            assert!(p.iter().any(|x| x.contains(want)), "{from:?} -> {to:?}: want {want:?}, got {p:?}");
        };
        bad("name = \"press\"", "name = \"Press me\"", "name must be [a-z0-9_]+");
        bad("about = \"A press is seen\"", "about = \" \"", "about is empty");
        bad("sim_note = \"kept\"", "sim_note = \"file:~/.config/x#k\"", "literal value");
        bad("sim_note = \"kept\"", "sim_note = \"prompt\"", "literal value");
        bad("sim_note = \"kept\"", "Sim-Note = \"kept\"", "provision key");
        bad("sim = \"PRESS 300\"", "sim = \"PRESS 300\"\nsend = \"x\"", "exactly one of");
        bad("sim = \"PRESS 300\"", "sim = \"SIM PRESS 300\"", "what follows `SIM `");
        bad("send = \"SELFTEST\"", "send = \"a\\nb\"", "one non-empty line");
        bad("wait = \"^PROV READY\"", "wait = \"^PROV (READY\"", "not a regex");
        bad("expect_json = \"BUTTON\"", "expect_json = \"button\"", "the line's tag");
        bad("fields = { kind = \"short\", n = 1 }", "fields = {}", "needs fields");
        bad("sleep_ms = 500", "sleep_ms = 0", "sleep_ms must be");
        bad("sleep_ms = 500", "sleep_ms = 500\nreboot = true", "exactly one of");
        bad("send = \"SELFTEST\"", "send = \"SELFTEST\"\ntimeout_ms = 10", "timeout_ms goes with wait or expect_json");
        bad("timeout_ms = 60000", "timeout_ms = 600000", "timeout_ms must be");
        bad("send = \"SELFTEST\"", "send = \"SELFTEST\"\nfields = { a = 1 }", "fields goes with expect_json");
        bad("reboot = true", "reboot = false", "reboot takes only true");
        let twice = format!("{ok}{}", SCENARIO.replace("about = \"A press is seen\"", "about = \"again\""));
        assert!(run(&twice, &circuit()).iter().any(|x| x.contains("a second scenario")));
        let no_steps = format!("{SAMPLE}[[sim.scenario]]\nname = \"x\"\nabout = \"y\"\n");
        assert!(run(&no_steps, &circuit()).iter().any(|x| x.contains("no steps")));
        // a proof that names a scenario must say it was simulated
        let proof = format!("{SAMPLE}[[requirement.proof]]\nhow = \"datasheet\"\nevidence = \"scenario:press\"\n{SCENARIO}");
        assert!(run(&proof, &circuit()).iter().any(|x| x.contains("needs how = \"simulated\"")));
    }

    #[test]
    fn provision_references() {
        let with = |v: &str| run(&format!("{SAMPLE}\n[provision]\n{v}\n"), &circuit());
        assert_eq!(with("gemini_api_key = \"file:~/.config/capture-notes/config#gemini_api_key\""), Vec::<String>::new());
        assert_eq!(with("wifi_pass = \"prompt\""), Vec::<String>::new());
        assert!(with("wifi_pass = \"hunter2\"")[0].contains("must be \"prompt\""));
        assert!(with("file = \"file:x\"")[0].contains("file:<path>#<field>"));
        assert!(with("a_key_that_is_too_long = \"prompt\"")[0].contains("at most 15"));
    }

    /// A battery board: USB charges the cell and runs the board; the battery runs it alone.
    const BATTERY: &str = r#"
[[power.source]]
name = "battery"
what = "LiPo through the LDO"
sleep_ua = 20

[[power.source.limit]]
name = "LDO"
ma = 600
source = "datasheet"

[[power.source.limit]]
name = "cell peak"
ma = 400
source = "INFERRED"

[[power.load]]
name = "charger"
ma = 100
source = "RPROG"
from = ["usb"]

[[power.sleep_load]]
name = "module asleep"
ua = 8
source = "VERIFIED: datasheet"

[[power.sleep_load]]
name = "LDO quiescent"
ua = 4
source = "INFERRED"
"#;

    fn battery(from: &str, to: &str) -> Vec<String> {
        let text = format!("{SAMPLE}{BATTERY}");
        assert!(text.contains(from), "{from:?} not in the battery sample");
        run(&text.replacen(from, to, 1), &circuit())
    }

    #[test]
    fn power_sources_and_sleep() {
        let text = format!("{SAMPLE}{BATTERY}");
        assert_eq!(run(&text, &circuit()), Vec::<String>::new());
        let bf = parse(&text).unwrap();
        let t = bf.power.tally();
        // usb: the module (all sources) and the charger (usb only)
        assert_eq!((t[0].source.name.as_str(), t[0].ma, t[0].budget_ma, t[0].loads.len()), ("usb", 455.0, 500.0, 2));
        // battery: the smaller limit binds; only the module draws; both sleep loads count
        assert_eq!((t[1].ma, t[1].budget_ma, t[1].binding.unwrap().name.as_str()), (355.0, 400.0, "cell peak"));
        assert_eq!((t[1].sleep_ua, t[1].sleep_loads.len(), t[0].sleep_loads.len()), (12.0, 2, 0));
        assert_eq!(bf.power.summary(), "usb 455.0 of 500 mA; battery 355.0 of 400 mA, asleep 12.0 of 20 µA");
        // requirements can be covered by a source's budgets
        let covered = text.replace("\"gate:drc\"]", "\"gate:drc\", \"power:battery\", \"sleep:battery\"]");
        assert_eq!(run(&covered, &circuit()), Vec::<String>::new());
        let p = run(&text.replace("\"gate:drc\"]", "\"sleep:usb\", \"power:mains\"]"), &circuit());
        assert!(p.len() == 2 && p[0].contains("no [[power.source]] of that name with a sleep_ua") && p[1].contains("no such [[power.source]]"), "{p:?}");

        let one = |from: &str, to: &str, want: &str| {
            let p = battery(from, to);
            assert!(p.len() == 1 && p[0].contains(want), "{from:?} -> {to:?}: want {want:?}, got {p:?}");
        };
        one("ua = 8", "ua = 17", "power battery: asleep 21 µA, over the 20 µA sleep budget");
        one("ma = 400", "ma = 300", "power battery: loads total 355 mA, over the 300 mA budget (cell peak)");
        one("ma = 100", "ma = 200", "power usb: loads total 555 mA, over the 500 mA budget (USB 2.0)");
        one("ua = 4\nsource = \"INFERRED\"", "ua = 4\nsource = \"guess\"", "power.sleep_load \"LDO quiescent\": source must say INFERRED or VERIFIED");
        one("from = [\"usb\"]", "from = [\"mains\"]", "power.load \"charger\": from \"mains\": no such [[power.source]]");
        one("ua = 4", "ua = 4\nfrom = [\"usb\"]", "source \"usb\" has no sleep_ua budget");
        // a second "usb" also merges the loads, so it is over budget too
        assert!(battery("name = \"battery\"", "name = \"usb\"").iter().any(|x| x.contains("power.source \"usb\": listed twice")));
        one("name = \"battery\"", "name = \"Battery\"", "lower-case identifier");
        one("sleep_ua = 20", "sleep_ua = 0", "sleep_ua must be more than 0");
        one("ma = 600", "ma = -1", "limit \"LDO\": ma must be more than 0");
        // a sleep budget with nothing counted against it proves nothing
        let p = run(text.split("[[power.sleep_load]]").next().unwrap(), &circuit());
        assert!(p.len() == 1 && p[0].contains("sleep_ua is set but no [[power.sleep_load]]"), "{p:?}");
        // sleep loads with no sleeping source
        let p = battery("sleep_ua = 20\n", "");
        assert!(p.len() == 2 && p.iter().all(|x| x.contains("no [[power.source]] has a sleep_ua budget")), "{p:?}");
        // a source needs at least one limit; the old single-source form no longer parses
        assert!(parse(&SAMPLE.replace("[[power.source.limit]]\nname = \"USB 2.0\"\nma = 500\nsource = \"spec\"\n", "")).is_err());
        assert!(parse(&SAMPLE.replace("[[power.source]]\nname = \"usb\"\nwhat = \"USB\"", "[power]\nsource = \"USB\"\nbudget_ma = 500")).is_err());
    }

    #[test]
    fn provision_expiry() {
        let with = |v: &str| format!("{SAMPLE}\n[provision]\n{v}\n");
        let text = with("github_token = { from = \"file:~/c#github_token\", expires = \"2027-09-18\" }\nwifi_pass = \"prompt\"");
        assert_eq!(run(&text, &circuit()), Vec::<String>::new());
        let bf = parse(&text).unwrap();
        assert_eq!(bf.provision["github_token"].reference(), "file:~/c#github_token");
        assert_eq!(bf.provision["wifi_pass"].expires(), None);
        assert_eq!(expiries(&bf, "2026-09-30"), vec![("github_token".to_string(), "2027-09-18".to_string(), 353)]);
        assert_eq!(expiries(&bf, "2027-09-20")[0].2, -2);
        // a table without expires is fine; a bad date or a bad reference in a table is not
        assert_eq!(run(&with("k = { from = \"prompt\" }"), &circuit()), Vec::<String>::new());
        let p = run(&with("k = { from = \"prompt\", expires = \"2027-02-29\" }"), &circuit());
        assert!(p.len() == 1 && p[0].contains("must be a date, YYYY-MM-DD"), "{p:?}");
        assert!(run(&with("k = { from = \"hunter2\" }"), &circuit())[0].contains("must be \"prompt\""));
        assert!(parse(&with("k = { from = \"prompt\", value = \"x\" }")).is_err());
    }

    #[test]
    fn day_numbers() {
        assert_eq!(day_number("1970-01-01"), Some(0));
        assert_eq!(day_number("2000-03-01"), Some(11017));
        assert_eq!(day_number("2028-02-29").zip(day_number("2028-03-01")).map(|(a, b)| b - a), Some(1));
        for bad in ["2027-13-01", "2027-02-29", "2027-9-18", "2027-09-18x", "20270918", "2027-09-00", "abcd-ef-gh"] {
            assert_eq!(day_number(bad), None, "{bad}");
        }
    }

    const CASE: &str = r#"
[case]
material = "resin"
wall = 1.5

[[case.opening]]
ref = "U1"
kind = "usb_c"

[[case.opening]]
ref = "R1"
kind = "led"
style = "hole"
"#;

    #[test]
    fn case_parses_resolves_and_passes() {
        let text = format!("{SAMPLE}{CASE}");
        assert_eq!(run(&text, &circuit()), Vec::<String>::new());
        let case = parse(&text).unwrap().case.unwrap();
        assert_eq!((case.floor, case.edge_gap, case.top_gap, case.bottom_gap, case.min_clearance), (1.5, 0.3, 1.0, 3.0, 0.2));
        assert_eq!(case.screw, Screw::M3);
        let r = case.resolved();
        assert_eq!(r["material"], "resin");
        assert_eq!(r["limits"]["hole_min"], 1.0);
        assert_eq!(r["screw"]["size"], "M3");
        assert_eq!(r["screw"]["pilot"], 2.5);
        let usb = &r["openings"][0];
        assert_eq!((usb["ref"].as_str(), usb["kind"].as_str()), (Some("U1"), Some("usb_c")));
        assert_eq!((usb["margin"].as_f64(), usb["height"].as_f64()), (Some(0.3), Some(3.26)));
        assert!(usb.get("diameter").is_none(), "{usb}");
        let led = &r["openings"][1];
        assert_eq!((led["style"].as_str(), led["diameter"].as_f64()), (Some("hole"), Some(2.0)));
        // no [case]: nothing about a case
        assert!(parse(SAMPLE).unwrap().case.is_none());
        // unknown kinds, materials, screws and keys don't parse
        assert!(parse(&text.replace("kind = \"usb_c\"", "kind = \"hdmi\"")).is_err());
        assert!(parse(&text.replace("\"resin\"", "\"wood\"")).is_err());
        assert!(parse(&text.replace("wall = 1.5", "wall = 1.5\nscrew = \"M4\"")).is_err());
        assert!(parse(&text.replace("wall = 1.5", "wall = 1.5\nwal = 1.5")).is_err());
        assert!(parse(&text.replace("style = \"hole\"", "style = \"hole\"\ncolour = \"red\"")).is_err());
        assert_eq!(parse(&text.replace("wall = 1.5", "wall = 1.5\nscrew = \"M2.5\"")).unwrap().case.unwrap().screw, Screw::M2_5);
    }

    #[test]
    fn case_battery() {
        let base = format!("{SAMPLE}{CASE}").replace("wall = 1.5", "wall = 1.5\nbottom_gap = 9.0");
        let with = |b: &str| format!("{base}\n[case.battery]\n{b}\n");
        let ok = with("size = [36, 17, 7.8]\nlead = \"R1\"");
        assert_eq!(run(&ok, &circuit()), Vec::<String>::new());
        let r = parse(&ok).unwrap().case.unwrap().resolved();
        let b = &r["battery"];
        assert_eq!((b["swell"].as_f64().map(|v| (v * 100.0).round()), b["pad"].as_f64(), b["fence_height"].as_f64()), (Some(78.0), Some(0.5), Some(3.0)));
        assert_eq!((b["at"].is_null(), b["rotate"].as_bool(), b["fence_width"].as_f64()), (true, Some(false), Some(1.2)));
        assert!(parse(&format!("{SAMPLE}{CASE}")).unwrap().case.unwrap().resolved()["battery"].is_null());
        let one = |b: &str, want: &str| {
            let p = run(&with(b), &circuit());
            assert!(p.len() == 1 && p[0].contains(want), "{b:?}: want {want:?}, got {p:?}");
        };
        one("size = [36, 17, 8.5]", "bottom_gap 9 mm has no room for the cell (8.5 thick + 0.85 swell + 0.2 clearance = 9.55 mm)");
        one("size = [36, 17, 7.8]\nswell = 0.5\npad = 0.1", "pad 0.1 mm is under the static fit 0.2 mm");
        one("size = [36, 0, 7.8]", "size must be three lengths over 0");
        one("size = [36, 17, 7.8]\nlead = \"J9\"", "lead J9: no such part");
        assert!(parse(&with("size = [36, 17]")).is_err());
        assert!(parse(&with("size = [36, 17, 7.8]\nfoam = 1")).is_err());
    }

    #[test]
    fn case_errors() {
        let base = format!("{SAMPLE}{CASE}");
        let bad = |from: &str, to: &str, want: &str| {
            assert!(base.contains(from), "{from:?} not in the case sample");
            let p = run(&base.replacen(from, to, 1), &circuit());
            assert!(p.len() == 1 && p[0].contains(want), "{from:?} -> {to:?}: want {want:?}, got {p:?}");
        };
        bad("wall = 1.5", "wall = 1.0", "case.wall = 1 mm is under the minimum 1.2 mm (resin)");
        bad("material = \"resin\"", "material = \"nylon\"\nfloor = 1.2", "case.floor = 1.2 mm is under the minimum 1.5 mm (nylon)");
        bad("wall = 1.5", "wall = 1.5\nedge_gap = 0.1", "case.edge_gap");
        bad("wall = 1.5", "wall = 1.5\ntop_gap = 0.1", "case.top_gap");
        bad("wall = 1.5", "wall = 1.5\nbottom_gap = -1", "case.bottom_gap");
        bad("ref = \"U1\"", "ref = \"J9\"", "case.opening J9: no such part");
        bad("ref = \"R1\"", "ref = \"U1\"", "case.opening U1: listed twice");
        bad("kind = \"usb_c\"", "kind = \"usb_c\"\ntravel = 0.3", "travel is not used by a usb_c opening (it takes margin, height)");
        bad("kind = \"usb_c\"", "kind = \"connector\"", "a connector needs height");
        bad("kind = \"usb_c\"", "kind = \"usb_c\"\nmargin = 0.1", "margin 0.1 mm is under the static fit 0.2 mm");
        bad("style = \"hole\"", "style = \"hole\"\ndiameter = 0.8", "a 0.8 mm hole is under the smallest printable hole 1 mm (resin)");
        bad("kind = \"led\"\nstyle = \"hole\"", "kind = \"pinhole\"\ndiameter = 0.9", "a 0.9 mm hole");
        bad("style = \"hole\"", "style = \"hole\"\nside = \"bottom\"", "side is not used by a led opening");
        // a pinhole may be on the tray side; only then is `side` written to board.json
        let bottom = base.replace("kind = \"led\"\nstyle = \"hole\"", "kind = \"pinhole\"\nside = \"bottom\"");
        assert_eq!(run(&bottom, &circuit()), Vec::<String>::new());
        let r = parse(&bottom).unwrap().case.unwrap().resolved();
        assert_eq!(r["openings"][1]["side"], "bottom");
        assert!(parse(&base).unwrap().case.unwrap().resolved()["openings"][1].get("side").is_none());
        bad("kind = \"led\"\nstyle = \"hole\"", "kind = \"vent\"\nslots = 0", "slots must be at least 1");
        bad("kind = \"led\"\nstyle = \"hole\"", "kind = \"vent\"\nslot_width = 0.5", "a 0.5 mm hole");
        bad("kind = \"led\"\nstyle = \"hole\"", "kind = \"button\"\ntravel = 0", "travel must be more than 0");
        // a LED window is a pocket, not a hole: a small one is fine
        assert_eq!(run(&base.replace("style = \"hole\"", "diameter = 0.8"), &circuit()), Vec::<String>::new());
    }

    /// Appended to SAMPLE: the proofs land on its last `[[requirement]]` (R1).
    const READINESS: &str = r#"
[[requirement.proof]]
how = "simulated"
evidence = "QEMU self-test sensor"

[[requirement.proof]]
how = "unprovable"
evidence = "Accuracy in real air; measured at bring-up"

[[risk]]
what = "The antenna keep-out is big enough"
tag = "INFERRED"
fix = "new_board"
miss = "Short Wi-Fi range; a second board"
check = "Blind review of the layout"
accepted = "OK, I accept the antenna risk"

[[risk]]
what = "LED resistor value"
tag = "UNVERIFIED"
fix = "rework"
miss = "A dim light; one resistor swapped"
"#;

    #[test]
    fn proofs_and_risks() {
        // all optional: a board.toml without them parses as before
        let bf = parse(SAMPLE).unwrap();
        assert!(bf.risks.is_empty() && bf.requirements[0].proofs.is_empty());
        let text = SAMPLE.replace("[firmware]\nself_test = [\"sensor\"]\n", "") + READINESS + "\n[firmware]\nself_test = [\"sensor\"]\n";
        assert_eq!(run(&text, &circuit()), Vec::<String>::new());
        let bf = parse(&text).unwrap();
        let proofs = &bf.requirements[0].proofs;
        assert_eq!((proofs.len(), proofs[0].how, proofs[1].how), (2, How::Simulated, How::Unprovable));
        assert_eq!(proofs[0].evidence, "QEMU self-test sensor");
        let r = &bf.risks;
        assert_eq!((r.len(), r[0].tag, r[0].fix, r[1].tag, r[1].fix), (2, Tag::Inferred, Fix::NewBoard, Tag::Unverified, Fix::Rework));
        assert_eq!((r[0].check.as_deref(), r[0].accepted.as_deref(), r[1].check.as_deref(), r[1].accepted.as_deref()), (Some("Blind review of the layout"), Some("OK, I accept the antenna risk"), None, None));
        for how in ["datasheet", "devboard", "gate"] {
            assert!(parse(&text.replace("how = \"simulated\"", &format!("how = \"{how}\""))).is_ok(), "{how}");
        }
        assert!(parse(&text.replace("fix = \"rework\"", "fix = \"firmware\"")).is_ok());
        // unknown words and keys don't parse; a risk needs what, tag, fix and miss
        for (from, to) in [
            ("how = \"simulated\"", "how = \"tested\""),
            ("fix = \"rework\"", "fix = \"respin\""),
            ("fix = \"new_board\"", "fix = \"new board\""),
            ("tag = \"INFERRED\"", "tag = \"inferred\""),
            ("tag = \"UNVERIFIED\"", "tag = \"GUESS\""),
            ("how = \"simulated\"", "how = \"simulated\"\nby = \"QEMU\""),
            ("fix = \"rework\"", "fix = \"rework\"\ncost = 3"),
            ("miss = \"A dim light; one resistor swapped\"\n", ""),
            ("evidence = \"QEMU self-test sensor\"\n", ""),
        ] {
            assert!(text.contains(from), "{from:?} not in the sample");
            assert!(parse(&text.replacen(from, to, 1)).is_err(), "{from:?} -> {to:?} parsed");
        }
        // empty words are gate problems
        let bad = |from: &str, to: &str, want: &str| {
            assert!(text.contains(from), "{from:?} not in the sample");
            let p = run(&text.replacen(from, to, 1), &circuit());
            assert!(p.len() == 1 && p[0] == want, "{from:?} -> {to:?}: want {want:?}, got {p:?}");
        };
        bad("evidence = \"Accuracy in real air; measured at bring-up\"", "evidence = \" \"", "requirement R1: proof 2: evidence is empty");
        bad("what = \"LED resistor value\"", "what = \"\"", "risk 2: what is empty");
        bad("miss = \"Short Wi-Fi range; a second board\"", "miss = \"\"", "risk 1: miss is empty");
        bad("accepted = \"OK, I accept the antenna risk\"", "accepted = \"  \"", "risk 1: accepted is empty");
    }

    #[test]
    fn unknown_keys_are_errors() {
        assert!(parse(&SAMPLE.replace("gpio = 1\n", "gpio = 1\ngpoi = 1\n")).is_err());
        assert!(parse(&SAMPLE.replace("[firmware]", "[firmwear]")).is_err());
        assert!(parse(&SAMPLE.replace("dir = \"io\"", "dir = \"inout\"")).is_err());
    }

    #[test]
    fn gpio_table() {
        let m = "RF_Module:ESP32-S3-WROOM-1";
        assert_eq!(gpio_of(m, "IO48"), Some(48));
        assert_eq!(gpio_of(m, "TXD0"), Some(43));
        assert_eq!(gpio_of(m, "RXD0"), Some(44));
        assert_eq!(gpio_of(m, "USB_D-"), Some(19));
        assert_eq!(gpio_of(m, "USB_D+"), Some(20));
        for not in ["EN", "3V3", "GND", "IO", "IOx1"] {
            assert_eq!(gpio_of(m, not), None, "{not}");
        }
    }

    #[test]
    fn module_table() {
        // -1U: its own entry, and the WROOM-1 symbol it uses with KiCad 10's libraries
        for m in ["RF_Module:ESP32-S3-WROOM-1U", "RF_Module:ESP32-S3-WROOM-1"] {
            assert!(knows(m), "{m}");
            assert_eq!(gpio_of(m, "TXD0"), Some(43), "{m}");
            assert_eq!(gpio_of(m, "IO0"), Some(0), "{m}");
            assert_eq!(gpio_of(m, "EN"), None, "{m}");
        }
        for m in ["RF_Module:ESP32-S3-WROOM-2", "RF_Module:ESP32-S3-MINI-1", "RF_Module:ESP32-WROOM-32"] {
            assert!(!knows(m), "{m}");
            assert_eq!(gpio_of(m, "IO0"), None, "{m}");
        }
        // every special pin is a pin of KiCad's symbol; its GPIOs are 0-21, 35-48 and the specials
        let m = "RF_Module:ESP32-S3-WROOM-1";
        let sym = crate::symlib::load(m).unwrap();
        for (name, _) in WROOM1_SPECIAL {
            assert!(sym.pins.iter().any(|p| p.name == *name), "{name}");
        }
        let gpios: BTreeSet<u32> = sym.pins.iter().filter_map(|p| gpio_of(m, &p.name)).collect();
        let want: BTreeSet<u32> = (0..=21).chain(35..=48).collect();
        assert_eq!(gpios, want);
    }

    #[test]
    fn each_error() {
        one("name = \"t\"", "name = \"u\"", "not the circuit's name");
        one("revision = \"A\"", "revision = \"B\"", "not the circuit's revision");
        one("gpio = 1\n", "gpio = 2\n", "IO1 is GPIO 1, not 2");
        one("net = \"SDA\"", "net = \"SCL\"", "on net SDA, not SCL");
        one("signal = \"BOOT\"", "signal = \"Boot\"", "upper-case C identifier");
        one("ma = 500", "ma = 300", "power usb: loads total 355 mA, over the 300 mA budget (USB 2.0)");
        one("[firmware]", "[order]\nassembled = 6\n\n[firmware]", "6 assembled of 5 boards");
        one("\"gate:drc\"", "\"gate:lint\"", "gates are");
        one("\"part:R1\"", "\"part:R9\"", "no such part");
        one("\"pin:I2C_SDA\"", "\"pin:I2C_SCL\"", "no such signal");
        one("covered_by = [\"part:R1\", \"pin:I2C_SDA\", \"test:sensor\", \"gate:drc\"]", "covered_by = [\"test:sensor\", \"drc\"]", "must start with");
        one("self_test = [\"sensor\"]", "self_test = [\"sensor\", \"led\"]", "\"led\" covers no requirement");
        // GPIO 0 twice, and IO0 then no longer in the map
        let p = run(&SAMPLE.replacen("pin = \"IO1\"\nnet = \"SDA\"\ngpio = 1", "pin = \"IO0\"\nnet = \"BOOT\"\ngpio = 0", 1), &circuit());
        assert!(p.iter().any(|x| x.contains("GPIO 0 used by another")), "{p:?}");
        assert!(p.iter().any(|x| x.contains("IO1) is on net SDA but not in the pin map")), "{p:?}");
    }

    #[test]
    fn pins_the_module_lacks_or_that_are_not_gpios() {
        let p = run(&SAMPLE.replacen("pin = \"IO1\"", "pin = \"IO99\"", 1), &circuit());
        assert!(p.iter().any(|x| x.contains("has no pin named \"IO99\"")), "{p:?}");
        let p = run(&SAMPLE.replacen("pin = \"IO1\"", "pin = \"EN\"", 1), &circuit());
        assert!(p.iter().any(|x| x.contains("EN is not a GPIO")), "{p:?}");
        let mut c = circuit();
        let u1 = c.find_part("U1").unwrap();
        let x = c.net("X");
        c.connect(x, u1, &["IO48"]);
        let p = run(SAMPLE, &c);
        assert!(p.len() == 1 && p[0].contains("IO48) is on net X but not in the pin map"), "{p:?}");
    }

    #[test]
    fn module_must_exist_and_be_known() {
        one("module = \"U1\"", "module = \"U7\"", "not a part in the circuit");
        let p = run(&SAMPLE.replace("module = \"U1\"", "module = \"R1\""), &circuit());
        assert!(p.len() == 1 && p[0].contains("has no GPIO table"), "{p:?}");
    }

    #[test]
    fn spec_ids_must_match() {
        let bf = parse(SAMPLE).unwrap();
        let p = problems(&bf, &circuit(), Some(&ids(&["R1", "R2"])));
        assert_eq!(p, vec!["spec.md requirement R2 is not in board.toml"]);
        let p = problems(&bf, &circuit(), Some(&ids(&[])));
        assert_eq!(p, vec!["board.toml requirement R1 is not in spec.md"]);
        assert!(problems(&bf, &circuit(), None)[0].contains("no spec.md"));
        let spec = "# x\n- **R1** one\n  - **R2** nested\n* **R10** star\nnot **R3** a list item\n- R4 not bold\n";
        assert_eq!(spec_ids(spec), ids(&["R1", "R10", "R2"]));
    }

    #[test]
    fn header_text() {
        let h = header(&parse(SAMPLE).unwrap());
        assert!(h.starts_with("// Generated by pcbgen"));
        for want in [
            "#pragma once\n",
            "#include \"driver/gpio.h\"\n",
            "#define BOARD_NAME \"t\"\n#define BOARD_REVISION \"A\"\n",
            "// I2C_SDA: module pin IO1, net SDA, io\n#define PIN_I2C_SDA GPIO_NUM_1\n",
            "// BOOT: module pin IO0, net BOOT, in, active low; strapping pin\n#define PIN_BOOT GPIO_NUM_0\n#define PIN_BOOT_ACTIVE_LOW 1\n",
            "#define PIN_USB_DP GPIO_NUM_20\n",
            "#define BOARD_SELF_TEST_COUNT 1\n#define BOARD_SELF_TESTS {\"sensor\"}\n",
        ] {
            assert!(h.contains(want), "missing {want:?} in\n{h}");
        }
        assert!(!h.contains("PIN_I2C_SDA_ACTIVE_LOW"));
    }
}
