vaknin/PCB/templates/board/src/main.rs

//! __NAME__, Rev 0. Run: `cargo run --release -p __NAME__ -- [stage ...]`.

mod circuit;
mod layout;

fn main() -> std::process::ExitCode {
    pcbgen::cli::main(pcbgen::cli::Board {
        dir: env!("CARGO_MANIFEST_DIR").into(),
        circuit: circuit::build,
        layout: layout::layout,
    })
}
