vaknin/PCB/crates/pcbgen/src/wokwi.rs

//! Wokwi project files generated from `board.toml` (D-025): the `fw` stage writes them next to
//! `board_pins.h` whenever a pin has a `sim` part, and `sim --wokwi` runs them.
//!
//! - `diagram.json`: an ESP32-S3-DevKitC-1 set up as the module (16 MB flash, 8 MB octal PSRAM,
//!   USB Serial/JTAG console) with one stand-in part per `sim` pin, wired as the board has it.
//! - `wokwi.toml`: points at the `build-wokwi` image (`flasher_args.json`, so the custom
//!   partition table is used).
//! - `wokwi-selftest.yaml`: the scenario: each `[[sim.wokwi_step]]`, then `SELFTEST_DONE`.
//!
//! Wokwi pauses the simulation between scenario steps (every step is a pause point in
//! wokwi-cli 0.27.1), so a `wait` can't miss a line printed while a button is held, as long as the
//! firmware prints it only after the release.

use serde_json::{Value, json};

use crate::boardfile::{BoardFile, SimPart};

pub const DIAGRAM: &str = "diagram.json";
pub const TOML: &str = "wokwi.toml";
pub const SCENARIO: &str = "wokwi-selftest.yaml";
/// The ESP-IDF project name (`project(firmware)` in the template's CMakeLists.txt).
const ELF: &str = "build-wokwi/firmware.elf";
/// A press without `hold_ms`.
const PRESS_MS: u64 = 200;

/// True if the board has anything for Wokwi to drive or check.
pub fn wanted(bf: &BoardFile) -> bool {
    bf.pins.iter().any(|p| p.sim.is_some())
}

/// The id of the part standing in for a signal (`BOOT` → `boot`).
fn part_id(signal: &str) -> String {
    signal.to_lowercase()
}
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
