vaknin/PCB/(commit log)

2026-09-29 Decide KiCad-native pipeline (D-004)
    Claude-Session: https://claude.ai/code/session_01N9LAUHq11L6KrJkWViepr9
2026-09-29 Phase 0 complete: KiCad 10.0.6 installed, serial access
    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
2026-09-29 Phase 1: pcbgen pipeline, starter board placed and routed
    - pcbgen: circuit-as-code -> KiCad schematic (ERC 0), PCB from netlist,
    Freerouting via DSN/SES, ERC/DRC gates with reasoned waivers
    - Starter board: parts research applied (LDL1117 D-007, H5VUT2U+SMF5.0A
    D-008, fuse/SHT40 LCSC fixes, red status LED, green power LED on 5V)
    - Placement fixed after DRC and renders; 100% routed; escape stubs for
    keep-out footprints; GND stitching (per-piece fix untested after segfaults)
    - Python 3.14 SWIG iterator shim; render script; docs/pipeline.md
    - D-009 firmware: C on ESP-IDF; lessons logged
    Claude-Session: https://claude.ai/code/sessio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
    [starter.kicad_pcb, starter.kicad_sch]
2026-09-29 Phase 1 complete: SWIG crash fixed, all gates pass, fab files, reviews
    - Segfault root cause: pcbnew's Remove() and Outline()/GetCourtyard() hand
    KiCad-owned memory to Python; fixed (leak removed items, borrowed()).
    Each stage and each SWIG step now runs in its own process; zones are
    filled by kicad-cli (D-011)
    - Routing: pours hidden from Freerouting so GND gets real tracks; Power
    class 0.3 mm; retries; stitching checks track clearance (D-012)
    - New gates: netlist round trip, net-class patterns, routing report
    - fab.py: gerbers/drill zip, JLCPCB BOM and CPL with rotation corrections
    - Datasheet check and blind review by separate agents; cap values, fuse
    before TVS, C1 placement, U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
    [positions-kicad.csv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]
2026-09-29 Lessons: .kicad_pro rewrite after sch-only runs is harmless
    Claude-Session: https://claude.ai/code/session_01EfFHJzgmcgpgRkWALfogi6
2026-09-29 Starter: LDO cooling copper, 0.3 mm ESP32 EPAD holes, 0.75 A fuse (D-015)
    - pcbgen: CopperZone (local pour of one net, above GND) and
    RouteOptions.stitch_local (per-net via stitching); routing report now
    lists every pour and vias per net.
    - Starter: +3V3 pour on both layers under U2's tab with 20 vias.
    - Local footprint lib/footprints/pcbgen.pretty/ESP32-S3-WROOM-1_EPAD-Drill0.3:
    KiCad's footprint with the 12 EPAD drills at 0.3 mm (JLCPCB's quote form
    charges ~$50 for 0.2 mm).
    - F1: Bourns MF-NSMF075-2 (C89653), which has a published derating table;
    a 0.5 A PTC holds only ~0.35-0.40 A at 50-60 C.
    - Research: research/2026-09-29-holes-and-fuse.md.
    - Full run: ERC 0, DRC 0 open (11 w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
    [positions-kicad.csv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]
2026-09-29 D-016: plan the Rust port of pcbgen (KiCad 11, no SWIG)
    Pin Rust 1.98.1 in mise.toml; ignore Cargo's target/.
    Claude-Session: https://claude.ai/code/session_01Gx8G6vBFXfvHWNjYGCm7nX
2026-09-29 Rust pcbgen: circuit model, schematic, project and board writers
    A Cargo workspace (crates/pcbgen + one crate per board) that writes the
    .kicad_sch and .kicad_pcb itself, with no SWIG. The starter board is
    ported to boards/starter/src/{circuit,layout}.rs.
    Checked against the Python pipeline on the starter board:
    - .kicad_sch, .kicad_pro, lib tables and .kicad_dru byte-identical;
    kicad-cli netlist identical (apart from path and timestamp); ERC 0.
    - .kicad_pcb before routing: same footprints, pads, nets, zones, texts
    and escape stubs (only a 1 nm difference on three outline arc
    midpoints); DRC before routing gives the same counts (parity 0,
    47 unrouted, 3 dangling stubs, the 11 known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
2026-09-29 Rust pcbgen: DSN writer, SES reader, stitching, report and fab
    The route stage now writes the Specctra DSN itself and reads the SES
    back (no SWIG); stitching reads the zone fill kicad-cli saved.
    Checked on the starter board:
    - DSN equal to KiCad's export in boundary, vias, rules, keep-outs,
    every pin's position/rotation/shape, nets, classes and locked stubs.
    - Freerouting turned out deterministic (the same DSN routes the same
    twice); the Python run-to-run variation came from pcbnew's random
    footprint UUIDs reordering the DSN. Retries now shuffle the
    footprint order with a seed, so each try differs but stays
    reproducible.
    - Full Rust run in place: netlist + net classes PASS, ERC 0,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
    [starter-B_Cu.gbl, starter-B_Mask.gbs, starter-B_Paste.gbp, starter-B_Silkscreen.gbo, starter-Edge_Cuts.gm1, starter-F_Cu.gtl, starter-F_Mask.gts, starter-F_Paste.gtp]
2026-09-29 Retire the Python pipeline: docs, lessons and decisions switch to Rust
    The Rust pcbgen reproduced every gate on the starter board (D-016), so
    the Python package, the Python board files and the venv are removed.
    docs/pipeline.md, HARDWARE_LESSONS (SWIG gotchas out; KiCad file
    conventions, deterministic Freerouting and the ignored via_costs flag
    in) and DECISIONS (D-016 results; KiCad 11 question closed; best-of-N
    routing noted as open) are updated.
    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
2026-09-29 pcbgen route: best of N footprint orders, fanout off, working via cost
    - Route every footprint order (default 8, 4 at a time) and keep the best:
    fewest unrouted (other nets, then the pour net), then least track under
    its class width, then fewest vias, then shortest. Each order works in
    route/try-<n>/; the winner's files are copied to route/, and
    route/tries.json (every order's score) goes into routing.json as "router".
    - Freerouting's fanout stage is off by default (RouteOptions::fanout). Its
    code narrows tracks to 3/4 or 3/5 of their class width; on the starter
    board every order had 40-49 mm of such track with it and none without it,
    and 20-27 vias instead of 23-31.
    - Via cost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
    [layout.rs, report.rs, route.rs, ses.rs]
2026-09-29 pcbgen cli: export KiCad's netlist once per run; --tries N
    The netlist and net-class gates and the pcb stage each ran kicad-cli's
    netlist export (up to 4 exports per full run). The cli now exports once
    and hands the tree to all three. Both gates always run, so a failing
    netlist no longer hides a dead net-class pattern.
    --tries N overrides the layout's number of router orders (1 for a quick
    look at a placement).
    [cli.rs, gates.rs, pcb.rs]
2026-09-29 pcbgen: tests that need no KiCad, plus an opt-in end-to-end run
    Unit tests (6 -> 20): DSN pin names (@n) and quoting, footprint orders,
    roundrect polygons covering the pad within 1 um, the DSN's KiCad
    conventions on a small board (Y up, rotations, NPTH keep-outs, classes,
    locked wires), refusing unsupported pads; SES reading; the stitching grid
    origin; Freerouting log parsing and the route score order; glob; pad
    distances.
    boards/starter/tests/end_to_end.rs runs the whole pipeline into a temp
    directory and checks the reports (cargo test --release -p starter --
    --ignored; needs kicad-cli and Freerouting).
2026-09-29 pcbgen: trapezoid and custom pads; KiCad's names for unnumbered pads
    - Pad::poly holds the copper outline of trapezoid pads (KiCad's rect_delta
    corners) and custom pads (the convex hull of the anchor and every
    primitive, strokes included; circles as polygons around them, at most
    5 um outside). Freerouting takes a padstack polygon's convex hull anyway.
    - The DSN writer writes both as polygons (Trapz/Cust padstacks); only
    bottom-side parts are still refused.
    - Pad::dist uses the outline, not the bounding box.
    - Unnumbered copper pads are pins "@1", "@2", ... as in KiCad's export;
    before, the first one was written as a pin with an empty name, which
    broke the DSN.
    Checked against Ki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
    [board.rs, dsn.rs, geom.rs]
2026-09-29 pcbgen route: warn when every order leaves something unrouted; clear old orders
2026-09-29 D-017: best-of-N routing with fanout off, pad shapes, tests; docs and lessons
    Logs why fanout is off (its code narrows tracks to 3/4 or 3/5 of their
    class width), the route score and its time cost, Freerouting's real
    setting names, the pad-shape check against KiCad's own DSN export, and
    that a board crate outside the repo works. Closes the "routing quality
    between tries" open question.
2026-09-29 starter: re-route with best-of-8 orders and fanout off (D-017)
    Kept order 2 of 8: 0 unrouted, 20 routed vias (was 30), no routed track
    under its class width (only the locked 0.2 mm escape stubs, 1.6 mm; was
    45.9 mm). All gates pass: netlist and net classes PASS, ERC 0, DRC 0 open
    (the same 11 waived silk warnings, 0 unconnected, parity 0), routing 0
    unrouted, no copper in keep-outs. Parts, nets, placement and rules are
    unchanged; schematic, BOM, CPL and positions byte-identical. Only the
    copper layers and drill file changed (the other gerbers only in their
    timestamps).
    [starter-B_Cu.gbl, starter-B_Mask.gbs, starter-B_Paste.gbp, starter-B_Silkscreen.gbo, starter-Edge_Cuts.gm1, starter-F_Cu.gtl, starter-F_Mask.gts, starter-F_Paste.gtp]
2026-09-29 pcbgen: bottom-side parts (at_bottom), pad drill offsets in the DSN
    Footprints are flipped as pcbnew flips them (checked item by item against
    pcbnew-saved boards); the DSN writes a bottom part as KiCad's exporter does
    (top-side image placed back at angle + 180, checked against
    ExportSpecctraDSN and Freerouting's own reader). Escape stubs, the keep-out
    report and the CPL (kicad-jlcpcb-tools' bottom rule, UNVERIFIED) follow
    the part's side. Pads with a drill offset now have their copper shifted in
    the DSN. scripts/fr-violations lists the violations Freerouting counts.
    Claude-Session: https://claude.ai/code/session_017MYWTVb3Gpj9aQSXu7LKG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
    [board.rs, dsn.rs, fab.rs, footprint.rs, layout.rs, pcb.rs, report.rs]
2026-09-29 pcbgen route: DRC-check the best 3 orders, keep the best that passes (D-019)
    The router's own score can't see faults such as a track starving a pour's
    thermal spokes. The best drc_checks orders are finished (fill, stitching)
    in route/try-<n>/check/ and run through the DRC gate; the best-ranked clean
    one is kept. The starter keeps the same order; the bottom-side scratch
    board now passes.
    Claude-Session: https://claude.ai/code/session_017MYWTVb3Gpj9aQSXu7LKGQ
2026-09-29 research: end-to-end cost estimate for JLCPCB assembly shipped to Israel
    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
2026-09-29 D-021: several boards per shipment as separate orders in one parcel; per-design cost
    Option A (each design its own order, 5 bare / 2 assembled, JLCPCB Combine
    Shipping) decided for now; option B (one mixed panel) documented with its
    revisit trigger. Cost estimate section 5: ~$72 per design for the starter,
    $52-70 for a typical design, VAT included (inferred).
    Claude-Session: https://claude.ai/code/session_01SS3tfFv1YxzSRxvcLY7Yf6
2026-09-29 pcbgen route: escalate when no checked order passes DRC; failure report and log (D-020)
    - Ladder, cheapest first: check the other routed orders, then route
    RouteOptions::extra_rounds x extra_tries new seeded orders and check them.
    - route/failure.json and a printed summary: each open DRC item's type, parts,
    position in layout mm, how many checked orders hit it, and a suggested fix.
    - <board>/route-failures.jsonl: one line per failed order, deduplicated by a
    layout fingerprint; error types tallied, and a RULE line when a type has
    failed on two boards.
    - RouteOptions::pad_rings: an opt-in router keep-out around poured pads.
    - gates::drc_open returns KiCad's items; 6 new unit tests.
    Co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
    [dsn.rs, failure.rs, gates.rs, layout.rs, lib.rs, route.rs, schematic.rs]
2026-09-29 D-022: project workflow: brainstorm, spec.md + board.toml, simulate, review rounds until freeze
    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
2026-09-29 D-020: routing-failure pipeline documented and verified; report fixes
    - failure report: count the kept order's open items, not its fault groups;
    no position for pour zones; a fix for dangling tracks.
    - DECISIONS D-020, HARDWARE_LESSONS (thermal spokes, failure log),
    docs/pipeline.md (route row, 'When routing fails').
    - Verified in scratch: escalation rescues D-018's board with drc_checks 1;
    a forced failure (no waivers, 16 orders) gives the report and the log;
    pad rings on J1 SH remove starved_thermal in 8 of 8 orders (at a cost in
    routability, so opt-in); the unchanged starter is byte-identical.
    Claude-Session: https://claud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
    [failure.rs]
2026-09-29 pcbgen: board.toml gate and fw stage (pin header); starter board.toml and spec.md (D-023)
    board.toml holds the pin map, power budget, requirement IDs and firmware
    self-tests. The BOARD.TOML gate (sch, check, fw) checks it against the
    circuit (names, module pins, nets, GPIO numbers, unmapped GPIOs), the power
    budget, requirement coverage and spec.md's IDs. The fw stage writes
    firmware/board_pins.h for ESP-IDF.
    Claude-Session: https://claude.ai/code/session_017JtPd3Cp5oKMh8iBbZE2ux
2026-09-29 templates for spec.md, board.toml, errata; draft/freeze tag scripts and a pre-order freeze check (D-023)
    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
2026-09-29 pcbgen: cost stage (live JLCPCB prices) and review stage (owner's round page); check writes gates.json (D-023)
    cost prices fab/<name>-bom.csv from JLCPCB's parts API through curl, adds
    PCB/setup/stencil/joint/Extended fees for [order] (default 5 bare, 2
    assembled) and lists shipping and VAT per parcel. review builds one
    self-contained page from the reports, BOM, cost, board.toml, round.md and
    git tags. Both run only when named.
    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
2026-09-29 D-024: capture-clip spec and parts research; exclude the spec-only board from the workspace
    Claude-Session: https://claude.ai/code/session_01PoeX4yGXX1j7hFqk6DNovE
2026-09-29 D-025 (proposed): plan for firmware and enclosure tooling, then capture-clip; research on Wokwi, ESP32-S3 firmware and case tooling
    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
2026-09-29 D-025 decided: simulation open source first (linux target, QEMU, Wokwi only for pins); dev-board session moved to Phase D.5
    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
2026-09-29 Phase A (D-025): shared firmware components, firmware template, starter firmware, and the sim stage running it in Espressif QEMU
    - firmware/components: board (target choice, boot banner, NVS, OTA mark-good), selftest (JSON lines), provision (no-echo NVS line protocol)
    - templates/firmware: project, sdkconfig per target (real, qemu, wokwi), 16 MB partition table with two OTA slots
    - pcbgen sim stage: builds the QEMU target, boots it with 8 MB octal PSRAM, checks banner, self-tests and a provisioning round trip; writes firmware/sim.json
    - fw stage copies the template into a board with no firmware project
    Claude-Session: https://claude.ai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
    [partitions.csv]
2026-09-29 board.toml: sim parts on pins, [[sim.wokwi_step]] and [provision] references, with gate checks and tests (D-025 Phase A)
    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
2026-09-29 sim --wokwi: Wokwi files generated from board.toml, run with lint, quota log and self-test parsing; starter passes (D-025 Phase A)
    - wokwi.rs: diagram.json (DevKitC-1 as the N16R8 module, stand-in parts wired from [[pin]] sim),
    wokwi.toml and the scenario YAML from [[sim.wokwi_step]]; written by the fw stage
    - sim.rs: shared banner/self-test report for QEMU and Wokwi; Wokwi run builds build-wokwi,
    lints first, passes the token by environment, logs simulated seconds to
    ~/.config/wokwi/usage.jsonl and stores the result under "wokwi" in sim.json
    - selftest: SELFTEST_DONE carries the uptime (ms)
    - starter: SHT40 tests skip in any simulation; the button test reports after the release;
    STA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
    [cli.rs, lib.rs, main.c, sim.rs, wokwi.rs]
2026-09-29 fw-test.sh: laptop tests for firmware logic (gcc + ESP-IDF linux target, sanitizers); provision split into parser, NVS handler and console; sensirion component (D-025 Phase A)
    The laptop build caught a %lld/int64_t mismatch in selftest.c. The console now
    refuses an over-long PROV line instead of storing a cut-off value (checked in QEMU),
    and provision_get no longer drops the last byte of an exactly-fitting value.
    Claude-Session: https://claude.ai/code/session_018PqDNKqvpnaEcwm8k1sFwr
    [main.c, provision.c, provision.h, provision_cmd.c, provision_text.c, provision_text.h]
2026-09-29 devctl: flash (REAL builds only), selftest, provision (secrets never printed) and monitor over serial or QEMU; docs, skill and board.toml template cover sim, fw-test and devctl (D-025 Phase A done)
    pcbgen::sim exposes Console, report and banner so the sim stage and bring-up share
    one set of checks. Serial behaviour on real USB Serial/JTAG is UNVERIFIED until the
    dev-board session (Phase D.5).
    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
2026-09-29 enclosure: CadQuery 2.8.0 venv (uv), 3D models in lib/3dmodels with the EasyEDA ones aligned to KiCad's footprints (D-025 Phase B.1-B.2)
    Claude-Session: https://claude.ai/code/session_01KcBasXjoyQ3ovruemPSuS8
2026-09-29 case stage: board.toml [case], board.json + board.step (fails on missing 3D models), enclosure/case.py builds tray, lid and button cap and fit-checks them; starter passes all 30 checks (D-025 Phase B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
    Review-page section and the Python negative tests are still to do (DECISIONS D-025).
    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
    [cap-SW2.step, cap-SW2.stl, case-bottom.step, case-bottom.stl, case-lid.step, case-lid.stl]
2026-09-30 case: review-page section, negative fit tests (test_case.py), [case.battery] pocket with battery.case/battery.board checks, date-only STEP timestamps; Phase B done (D-025)
    Claude-Session: https://claude.ai/code/session_012xw7M9x5foufDcDwBV7QvS
    [cap-SW2.step, case-bottom.step, case-lid.step]
2026-09-30 Phase C: case in every round, per-source and sleep power budgets, bring-up and secret expiry on the review page (D-025)
    - board.toml [power]: [[power.source]]s with [[power.source.limit]]s (budget = smallest),
    loads with `from`, [[power.sleep_load]]s against a source's sleep_ua (INFERRED/VERIFIED
    required); the BOARD.TOML gate fails on any budget exceeded. Starter migrated.
    - Requirements can be covered by power:<source> / sleep:<source>; the review page shows the
    budget chip next to them (sleep total next to R2).
    - [provision] values may be { from, expires }: the review page warns 60 days before a secret
    lapses; devctl provision warns on an expired one. Unknown keys in the table are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
    [boardfile.rs, provision.rs, review.rs, wokwi.rs]
2026-09-30 Phase D.1: codec spike, OGG/Opus 16 kHz 32 kbps from esp_audio_codec + esp_muxer on IDF v6.1 in QEMU, checked with ffprobe and one Gemini request (D-025)
    Claude-Session: https://claude.ai/code/session_01N3ATtTwghYqpriFWiRdvY1
    [partitions.csv]
2026-09-30 Phase E.1: capture-clip circuit as code and board.toml; ERC clean, BOARD.TOML passes (D-025)
    Charge current 100 mA so charging plus the Wi-Fi peak stays inside a USB
    port's 500 mA. Layout not started.
    Claude-Session: https://claude.ai/code/session_01UQDo51mTSB52EdakzLEgRL
    [capture-clip.kicad_sch]
2026-09-30 workflow: right the first time (readiness page, hardware hooks, Wi-Fi update in Rev A); capture-clip battery report and switchable charge current (D-025)
    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
2026-09-30 Phase D.3 slice 1: clip app logic (state machine, queue with power-cut recovery, upload pipeline, status file), 86 laptop tests; datasheet check for capture-clip (D-025)
    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
2026-09-30 Phase E.3/E.4: capture-clip layout and case, all gates pass; power-path fix (D-025)
    30 x 60 mm board routed on the default 8 orders: ERC 0, DRC 0 open, 0 unrouted.
    D2 -> RB168MM-40, U4 -> HE9073 (9 V input), C4 10 uF: asleep 12.7 of 20 uA.
    Case with battery pocket and a tray-side microphone opening (new pcbgen
    [[case.opening]] side = "bottom", board-edge notch); fit.json 30 of 30.
    Cost: $66.89 per design for 5 bare + 2 assembled.
    Claude-Session: https://claude.ai/code/session_012cDPYugvAySizSnVuzDouS
    [cap-SW1.step, cap-SW1.stl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]
2026-09-30 WIP: capture-clip firmware app and QEMU scenarios, dev-board encoder measurements, cost options (D-025)
    Stopped mid-task for a fresh session; see boards/capture-clip/firmware/PROGRESS.md,
    firmware/spikes/codec/RESULTS-devboard.md and research/2026-09-30-cost-options-capture-clip.md.
    Laptop tests: 238 pass. QEMU update/rollback scenarios are not repeatable yet.
    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
    [partitions.csv]
2026-09-30 Readiness page in the review stage; cost trade-offs are the owner's (D-025)
    board.toml gains [[requirement.proof]] and [[risk]]; review writes
    review/readiness.html and readiness.json; freeze.sh refuses while anything is
    red. Docs: the owner's cost rule, side = "bottom" openings and board notches.
    Claude-Session: https://claude.ai/code/session_01CXRNDRxQnPUFHoyYeVPoJ9
2026-09-30 QEMU crashes no longer raise desktop crash notices; dev-board boot, wake, OGG and scan measurements (D-025)
    scripts/nodump.c is preloaded into QEMU by the sim stage, devctl and the codec
    spike, so a simulator segfault leaves no core dump. Dev-board results are the
    agent's measurements, not re-run by the main session.
    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
    [bench.py, sim.rs]
2026-09-30 capture-clip: readiness proofs and risks, independent reviews, power-path datasheet check (D-025)
    Blind review, red team and a datasheet check of the swapped regulator and diode;
    their findings are board.toml risks and a round-2 list in DECISIONS.
    Claude-Session: https://claude.ai/code/session_016Xhxqaf7FYvqZrXN7qVMTL
2026-10-01 WIP capture-clip: button sampler, task priorities, queued self-test, SIM PRESS (unverified)
    Committed as-is at the owner's request so pipeline work starts from a clean
    tree. Not rerun after the last source change; see PROGRESS.md. Also the
    starter's gates.json report and the 2026-09-30 price notes in DECISIONS.
    Claude-Session: https://claude.ai/code/session_01T5c1vQNCB4AARjsQRobsDT
2026-10-01 pcb-pipeline skill moves into the repo, split by task; skill-check.sh keeps it honest
    The skill was a 332-line global file, ~60 % copied from docs/pipeline.md and docs/workflow.md.
    Now .claude/skills/pcb-pipeline/: a short SKILL.md (rules, start of session, run line, a
    task -> file table) and one reference file per task (authoring, results, rounds, choice-page,
    review-agents, firmware, pcbgen-dev) that point at the docs instead of copying them. Stale
    bits fixed from the code: devctl --port DEV / --seconds N, the capture and clip components,
    scripts/nodump.sh. Tools still being built (pcb parts/lib/new, pcbgen::blocks,
    [[sim.scenario]], freeze library hashes) are documented inside <!-- pendin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
2026-10-01 pcbgen: circuit blocks, module GPIO table, `pcb new` board scaffold
    - crates/pcbgen/src/blocks.rs: usb_c_power (HRO USB-C, CC pull-downs, ESD, TVS,
    optional PTC fuse), ldo_3v3 (LDL1117S33R or HE9073A33), esp32s3_core
    (WROOM-1-N16R8, 22u+100n, EN RC, RESET, BOOT strap), 0805 helpers and
    nc_unconnected. Options structs so capture-clip's variants fit too.
    - boards/starter uses the blocks; schematic, BOM, CPL and footprints unchanged
    (compared in scratch against the committed outputs).
    - boardfile.rs: module GPIO table (WROOM-1, WROOM-1U) replaces hardcoded logic.
    - scaffold.rs + bin/pcb.rs: `pcb new <name>` makes boards/<name> from
    templates/board and templates/{board.toml,spec.md,rou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
    [blocks.rs, boardfile.rs, circuit.rs, layout.rs, lib.rs, main.rs, pcb.rs, scaffold.rs]
2026-10-01 Merge notes for blocks and pcb new: skill, lessons, D-026
    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
2026-10-01 Parts search tool and PARTS gate: jlc module, `pcb parts search/show`, MPN + stock check in cost
    - crates/pcbgen/src/jlc.rs: JLCPCB parts API client moved out of cost.rs; search with
    Basic / no-fee / in-stock filters and paging (filters verified live), get by exact LCSC
    code, richer Listing (MPN, maker, package, category, description, parameters,
    datasheet + JLCPCB copy, part page), 1-day answer cache in ~/.cache/pcbgen/jlc keyed by
    request-body hash, datasheet download + pdftotext, MPN normaliser.
    - New bin `pcb` (cargo run --release -p pcbgen --bin pcb -- parts ...): `parts search`
    table (class with fee, stock, price at qty, package, MPN, KiCad footprint name hint),
    `parts show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
    [starter.kicad_pcb, starter.kicad_sch]
2026-10-01 sim stage: QEMU scenarios from board.toml, the board's run.py hook, simcmd component (D-025)
    - Console: regex wait with a cursor and per-wait timeout, STATUS on timeout,
    crash lines drained, JSON-field match, SIM ack, kill/reboot, extra QEMU args,
    QemuDied (signal) told apart from a firmware failure.
    - scenario.rs: [[sim.scenario]] steps (send, sim, wait, expect_json, sleep_ms,
    reboot), literal provisioning, fresh image per scenario, up to 3 reruns on a
    QEMU crash (counted, crashed log kept); firmware/sim/run.py hook merged in.
    - sim.json scenarios; review page table; readiness proofs scenario:<name> are
    red when the scenario failed or has no result; freeze.sh refuses a readiness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
    [boardfile.rs, lib.rs, main.c, readiness.rs, review.rs, scenario.rs, sim.rs]
2026-10-01 Part 2b: `pcb lib import` and the footprint drift guard
    - pcbgen::libimport + `pcb lib import <LCSC> [--fresh]`: easyeda2kicad
    (enclosure venv) into lib/symbols/pcbgen.kicad_sym and
    lib/footprints/pcbgen.pretty under the MPN, both re-saved by kicad-cli;
    unspecified pins become passive, the symbol's LCSC/MPN fields dropped,
    the model pointed at pcbgen.3dshapes/<name>.step (prints the
    enclosure/models.py line); warns when pads reach past the courtyard;
    refuses an existing LCSC or name. Recorded UNVERIFIED in
    lib/IMPORTED.toml; the readiness page turns each unverified import a
    board uses into a red item.
    - scripts/lib-hashes.sh: sha256 of every footprint and symbol block a
    boa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
    [lib.rs, libimport.rs, pcb.rs, readiness.rs]
2026-10-01 Docs for parts search, lib import and the drift guard
    Skill: pending markers removed for parts search, .mpn, lib import,
    IMPORTED.toml and the freeze hashes, text matched to the commands as
    built. skill-check.sh now reads the pcb binary's command modules for
    prose flags. lib/IMPORTED.toml committed with its header only.
    D-026 bullets; the "vendoring footprints" open question closed by the
    drift guard; HARDWARE_LESSONS on the JLCPCB API and easyeda2kicad.
    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
2026-10-01 Scenario docs, template firmware on simcmd, fw-test --scenarios runs the sim stage
    - Skill: the last <!-- pending --> blocks (simcmd, scenarios, sim.json results, scenario:
    proofs) rewritten to match what was built; freeze refusal on a readiness.json older than
    sim.json in rounds.md. skill-check: PASS (0 pending).
    - templates/firmware/main/main.c: simcmd_start + SIM/SELFTEST console lines, SELFTEST in its
    own task (verified on a scaffolded board: QEMU scenario pass; REAL build has no simcmd symbols).
    - scripts/fw-test.sh --scenarios: the sim stage for boards with [[sim.scenario]] (sim.json into
    the log directory), run.py for the others.
    - templates/board.toml: `<scenario>`, `<test>`,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
2026-10-01 Template firmware implements status_led, the self-test templates/board.toml lists
    A fresh `pcb new` board listed status_led but the firmware only had a placeholder, so the
    QEMU check reported it missing and the sim stage failed. Verified: pcb new tmpx, then
    `-p tmpx -- fw sim` prints SIM (QEMU): PASS (status_led skips: no GPIO in QEMU).
    Claude-Session: https://claude.ai/code/session_01UCuBg7KsogyXbiphz9EqTb
    [main.c]
2026-10-01 Skill evals (Part 3 step 6) and the gaps they found
    Eight dry-run owner requests, each planned with and without the pcb-pipeline skill, graded
    against assertions; plus 16 trigger queries run with claude -p from outside the repo (16/16,
    which also shows the ~/.claude/skills symlink loads the skill). The set and the trigger checker
    are in scripts/skill-evals/ for the next real skill change.
    Fixes from the grading:
    - results.md: failed routing no longer says "route more orders" when every order failed; full
    failure.json path
    - choice-page.md: case colour is not a board.toml key (recolour renders via COL_CASE, record as
    a comment); cheapest picture that shows the difference; either/or brain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
2026-10-07 Update dependencies within their semver ranges
    - zeroize 1.9.0 -> 1.9.1
    The nightly safe update (dibs): `cargo update`, pre-releases left alone, tests passed.
    For you: nothing to notice; this project's crates are current and its builds share more compiled crates with your other projects.
2026-10-10 Update dependencies within their semver ranges
    - serde_spanned 1.1.1 -> 1.1.2
    - toml 1.1.6+spec-1.1.0 -> 1.1.8+spec-1.1.0
    - toml_datetime 1.1.1+spec-1.1.0 -> 1.1.2+spec-1.1.0
    - toml_parser 1.1.3+spec-1.1.0 -> 1.1.5+spec-1.1.0
    - toml_writer 1.1.2+spec-1.1.0 -> 1.1.3+spec-1.1.0
    - uuid 1.27.0 -> 1.28.0
    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
2026-10-11 Update dependencies within their semver ranges
    - serde_json 1.0.151 -> 1.0.152
    - syn 3.0.6 -> 3.0.7
    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
2026-10-12 Update dependencies within their semver ranges
    - serde_json 1.0.152 -> 1.0.154
    - syn 3.0.7 -> 3.0.8
    - zopfli 0.8.3 -> 0.8.4
    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
2026-10-13 Update dependencies within their semver ranges
    - syn 3.0.8 -> 3.0.9
    - unicode-ident 1.0.26 -> 1.0.27
    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
2026-10-14 Update dependencies within their semver ranges
    - equivalent 1.0.2 -> 1.0.3
    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
2026-10-18 Update dependencies within their semver ranges
    - libc 0.2.190 -> 0.2.191
    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
2026-10-21 Update dependencies within their semver ranges
    - crc32fast 1.5.2 -> 1.5.3
    - typed-path 0.12.3 -> 0.12.4
    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
